neuroandriyanov/LaserRangefinder/hardware/photos/README.en.md

# Rangefinder, optics and power-supply photographs

[Русский](README.md) | **English**

Original photographs by the author. Images are preserved without re-encoding;
links open full-size files. Board labels do not replace checking connections
against the schematic and QSF.

## Board in its enclosure

Rangefinder board and receiver assembly in the open enclosure

*Custom electronics are arranged around the optical assembly.*

## Optical assembly

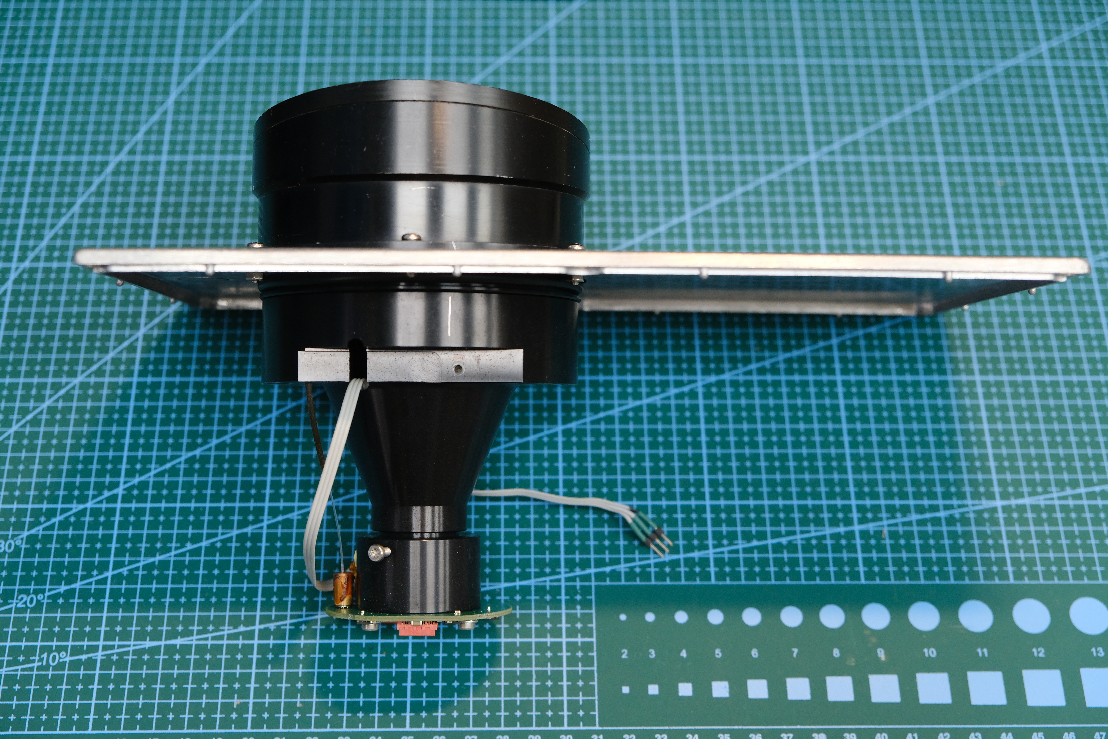
[picture p2: hardware/photos/rangefinder-03.jpg]
Optical assembly on the mounting panel, side view


*The optics used to build the bench. The restoration story is in a
[separate description](../../docs/project-story.en.md).*

## All original photographs

| Rangefinder | Power supply |
|---|---|
| [Photo 01 — board](rangefinder-01.jpg) | [Power-supply photo 01](power-supply-01.jpg) |
| [Photo 02](rangefinder-02.jpg) | [Power-supply photo 02](power-supply-02.jpg) |
| [Photo 03 — optical assembly](rangefinder-03.jpg) | |
| [Photo 04](rangefinder-04.jpg) | |
| [Photo 05 — board in enclosure](rangefinder-05.jpg) | |
| [Photo 06](rangefinder-06.jpg) | |

Oscilloscope captures are stored separately:
[latest series with distances](../../measurements/2026-11-03/Осциллограммы/README.en.md).
