neuroandriyanov/LaserRangefinder/NOTICE.en.md

# Material provenance and licences

[Русский](NOTICE.md) | **English**

Copyright (c) 2026 Sergey Vasilyevich Andriyanov (NeuroAndriyanov).

At the owner's request of 3 November 2026, original LaserRangefinder
materials are provided under the same free permissive licences used
in his FerroDSP and PropValve-RE06MT projects.

## Applicable terms

| Materials | Licence |
|---|---|
| Original application and tool code: app/, tools/ | MIT |
| Original HDL, tests, ROM tables and custom FPGA settings in fpga/ | MIT, preserving separate manufacturer notices |
| Original READMEs, instructions, reports and illustrations | MIT |
| Author's hardware/photos/ photographs, oscilloscope captures, tables and original presentation of measurements/ data | MIT, to the extent of the author's rights |
| Original main.pdf, power.pdf schematics and bom.xlsx in hardware/schematics/ | CERN-OHL-P-2.0 |

Full texts: [MIT](LICENSE) and [CERN-OHL-P-2.0](LICENSES/CERN-OHL-P-2.0.txt).
This is an allocation by material type, not a requirement to apply both
licences simultaneously to every file. Retain attribution notices and
follow the relevant licence terms when using and distributing changes.

## Manufacturer materials

Quartus, its libraries and automatically generated components retain
Altera's terms. QDF files, SOF/POF images and project-file notices
containing such components do not become wholly MIT-licensed merely
by being in this folder. Licensing the author's settings and HDL
does not grant rights to Quartus itself or proprietary manufacturer components.

Python, Tcl/Tk, Icarus Verilog, NumPy, Matplotlib, pySerial, Bumble, libusb1,
Bleak and other dependencies are installed separately under their own
licences. Third-party APKs, installers, drivers and manufacturer
documentation packages are not included here.

LE-200 PROFIBUS is named as the donor of physical optical assemblies.
This project's licences do not grant rights to the manufacturer's
original design, documentation, trademarks or third-party patents.
The bench is an independent experimental design, not an official
project of the donor's manufacturer.

## Data and history

Code and measurement scripts were developed with AI participation;
the author designed, restored and checked the hardware. Documents
distinguish his statements, simulations and real measurements.
An open licence does not confirm a 200 m range, accuracy or IP68 protection.

The root manifest describes the current publication folder. The
measurement-series manifest remains unchanged and also contains hashes
of primary captures retained in the author's working archive. The new
licence does not change numerical results or file provenance.

[Licence text sources](docs/license-sources.en.md).
