neuroandriyanov/LaserRangefinder/docs/website-links.md

# Материалы для ссылок с сайта

**Русский** | [English](website-links.en.md)

Все пути отсчитываются от корня этой папки. Машиночитаемый каталог:
[site-links.json](../site-links.json). Ссылки относительные, поэтому адрес
будущего GitHub-репозитория и домен сайта не зашиты в документы.

После выбора репозитория для просмотра используйте его обычную ссылку на
файл/каталог; для скачивания — URL исходного файла, предоставленный GitHub.
Пробелы и кириллицу кодируйте по сегментам URL (например, пробел → `%20`).
Для воспроизводимых публикаций фиксируйте commit/tag, а не изменяемую ветку.
`measurements/2026-11-03/` — постоянный адрес именно этой серии; новые серии
следует добавлять рядом, не перезаписывая исторические материалы.

| Материал | Путь |
|---|---|
| Программа | `app/README.md` |
| Проект Quartus | `fpga/DistanceSensorFpga_v0.qpf` |
| Сборка FPGA | `fpga/README.md` |
| Основная схема | `hardware/schematics/main.pdf` |
| Питание | `hardware/schematics/power.pdf` |
| Спецификация | `hardware/schematics/bom.xlsx` |
| Фото платы, оптики и питания | `hardware/photos/README.md` |
| Последняя серия | `measurements/2026-11-03/README.md` |
| Таблица измерений | `measurements/2026-11-03/Стендовые измерения.xlsx` |
| Осциллограммы | `measurements/2026-11-03/Осциллограммы/README.md` |
| UART v3 | `docs/protocol-v3.md` |
| Проверки | `docs/build-verification.md` |
| Обзор проекта | `README.md` |
| История проекта | `docs/project-story.md` |
| Стенд | `docs/stand.md` |
| Эксперименты | `docs/experiments.md` |
| Начать работу с ИИ | `docs/START_WITH_AI.md` |
| Памятка ИИ | `AGENTS.md` |
| Текущий статус | `docs/AI_HANDOFF.md` |
| Лицензии | `NOTICE.md` |

На снимках SVG есть внешняя подпись расстояния и пары каналов; рядом лежат
нативные PNG. Для сайта можно ссылаться на SVG или PNG без повторного
скриншота и изменения измерительных следов. Схемы PDF и таблицы XLSX
доступны отдельными файлами. Фото плат полноразмерные, поэтому страница
сайта может задавать уменьшенную ширину отображения и ссылку на оригинал.

Для страницы проекта можно использовать разделы основного README: история,
работа с ИИ, измерения и другие проекты. Подробные статьи имеют собственные
постоянные пути; материалы измерений остаются в каталоге своей даты.
