neuroandriyanov/LaserRangefinder/docs/AI_HANDOFF.md

# Контекст для следующего ИИ

**Русский** | [English](AI_HANDOFF.en.md)

Состояние на **3 ноября 2026 года, Samara (UTC+4)**. Этот файл относится
к самостоятельной публикационной папке. Он не требует доступа к рабочему
компьютеру автора. Порядок чтения и проверки — [AGENTS.md](../AGENTS.md).

Канонический репозиторий: [neuroandriyanov/LaserRangefinder](https://github.com/neuroandriyanov/LaserRangefinder).
Первая публикация подготовлена 03.11.2026 по поручению автора через отдельную
ветку и pull request в main. Точный коммит и факт слияния проверяйте в истории
репозитория. Программная версия и результаты измерений при переносе не менялись.

## Документация на двух языках — 7 ноября 2026

Аппаратное и программное состояние ниже остаётся состоянием 3 ноября.
Добавлены полные английские документы, подписи осциллограмм и отдельная
английская таблица измерений. Числовые исходники, прошивка и исторические
манифесты сохранены; приборы не опрашивались. Русский материал можно добавлять
первым, затем переводить по [инструкции](TRANSLATIONS.md). Проверки и причина
обновления корневого manifest.json записаны в [журнале](PROJECT_LOG.md).

## Что здесь есть

Приложение ПК 0.5.1, FPGA UART v3, схемы, фото и последняя серия измерений.
История: оптика и приёмный блок от неисправного LE-200 PROFIBUS; PIN-фотодиоды
заменены на BPX65, лазерный диод на QL67D7SA. Это сведения автора, записанные
при подготовке описания. Основная плата — собственная разработка.
Подробнее: [история](project-story.md), [стенд](stand.md).

## Актуальная реализация

| Узел | Состояние |
|---|---|
| FPGA | EP4CE6E22C8, проект DistanceSensorFpga_v0 в fpga/ |
| DDS | AD9959, SYSCLK 500 МГц, единый IO_UPDATE, 4 канала |
| АЦП | 8 ADS8681, синхронные 250 квыб/с |
| Аналоговая фаза | МНК/CORDIC, окно 1000 отсчётов, обновление через 250; FIR отсутствует |
| Цифровая фаза | 125 МГц, 16 фронтов каждой полярности |
| Достоверность | Помимо фаз, проверяется модуль U ≥0,5 В на каждом ADC5–8 |
| UART | v3, 115200 8N1, запрос 12 байт, измерения 112, банк DDS 48 |
| Расстояние | Вычисляет ПК по cal2; в FPGA расчёта расстояния и скорости нет |
| Рулетка | Vector60 через отдельный WinUSB Bluetooth-адаптер; не обязательна для FPGA/демо |

Стартовый банк: FTW `[12845056, 635888254, 12879416, 635830272]`,
ASF `[200, 1000, 1000, 450]`, POW все 0. Точная копия —
[default.json](../app/profiles/dds/default.json). ПЧ НЧ 4000,030458 Гц,
ВЧ 6749,993190 Гц. НЧ DDS CH0/CH2, ВЧ CH1/CH3; фазовые пары входов
3−1 ВЧ и 4−2 НЧ. Настройки через COM действуют до reset; на ПК сохраняются отдельно.

## Что проверено

Последняя серия: 762, 1091, 1480, 1958, 2398, 2876, 3425, 4198, 4814, 5635 мм.
На точку два снимка, CH1+CH3 и CH2+CH4. Cal2 зафиксирована до серии,
область 638–5583 мм, ID `6c959d57db56d0397e0618d8026c43604e38874606a59c39262eb9daf9059de6`.
Внутри неё девять точек: RMS расхождения с рулеткой 13,36/13,16 мм,
max |ошибки| 22,96/22,81 мм (аналоговый/цифровой). 5635 мм вне модели.
[Отчёт и данные](../measurements/2026-11-03/README.md).

POF рабочей серии: `7e652373ae74ca5d1734248706c16cae9fdaf9ef25b28a321869271220e0212d`.
Program+Verify на авторской плате — 03.11.2026 20:31:09 Samara.
Контрольная сборка публикационной копии дала такой же POF, без повторной записи.
Quartus Lite 25.1std: 6162/6272 LE, 23/30 M9K, 5/15 DSP18, 1/2 PLL;
66 проверок, min slack +0,137 нс, unconstrained 0.
63 теста приложения, 22 протокола и 9 HDL-наборов прошли;
чистая установка и деморежим после переноса проверены на Windows/Python 3.14.
[Доказательства](build-verification.md). Это проверки сохранённой версии.

## Незакрытые вопросы

- В точке 5635 мм появился `diagnostics=4`: запоминаемое цифровое переполнение.
  Источник — digital_phase_meter.overflow_seen и/или bridge.overrun; какой именно
  и почему, пока не установлено. После восстановления текущий valid может быть 1.
- Причина редких аппаратных скачков фазы не доказана. Проверка DDS не обнаружила
  периодических обновлений при неизменном задании. FIR был убран после отсутствия
  заметного улучшения по наблюдениям автора.
- Подбор DDS проводился в одной точке 1642 мм. Профиль не универсальная калибровка.
- Нужны исследования динамики и температуры, длинная дистанция 100–200 м,
  дальнейший расчёт расстояния/скорости. Комнатные опыты их не заменяют.
- IP68 — цель выбора корпуса; протокола испытаний собранного изделия нет.

Последнее подтверждённое состояние авторского стенда после серии: прежний
DDS-банк, generation=0, diagnostics=4, COM/BLE освобождены, осциллограф RUN,
все четыре канала, 50 мкс/дел. При подготовке этой документации приборы не
опрашивались. Для другого стенда или нового дня состояние нужно узнать заново.

## С чего продолжать

Для изучения достаточно [инструкции](START_WITH_AI.md), демонстрации и сохранённых
данных. Для разработки выберите задачу пользователя, затем соответствующие тесты.
Для bit2 сначала нужен воспроизводимый сценарий и локализация источника;
не сбрасывайте и не скрывайте флаг ради красивой статистики. Для нового стенда
сначала подтвердите подключения, реальный банк и пригодность своей калибровки.

Новые сведения записывайте сюда, завершённые этапы — в [PROJECT_LOG.md](PROJECT_LOG.md).
Исходные данные и старые манифесты сохраняйте. Лицензии уже выбраны по поручению
автора: MIT и CERN-OHL-P-2.0, область — [NOTICE.md](../NOTICE.md).
