neuroandriyanov/LaserRangefinder/docs/known-limitations.md

# Подтверждённые ограничения

**Русский** | [English](known-limitations.en.md)

- Корпус выбирался с расчётом на IP68; протокола испытаний степени защиты
  собранного устройства в комплекте нет.

- Реально измерена комнатная дистанция до 5635 мм. Cal2 охватывает 638–5583 мм;
  перенос результата на 100–200 м пока не проверен.
- Расстояние на главной вкладке считает ПК. FPGA передаёт фазы, амплитуды,
  сырые коды, частоты и статусы; аппаратного расчёта расстояния/скорости нет.
- Последняя точка стенда содержит `diagnostics=4`: запоминаемый bit2
  переполнения цифрового захвата/CDC. Причина не установлена. Текущие valid
  могут восстановиться, пока этот диагностический бит остаётся до reset.
- Для точки вне модели Excel выводит «н/д». Потери и помехи не заменяются
  интерполяцией, выдаваемой за измерение.
- Независимость фазового алгоритма от масштаба амплитуды проверена
  моделированием. При малом сигнале, искажениях, насыщении и взаимопроникновении
  каналов реальная погрешность всё равно возможна.
- Передача полного запроса и ответа при 115200 8N1 занимает минимум 10,764 мс;
  1000 и даже устойчивые 100 полных ответов/с на этой скорости недостижимы.
- Приложение и WinUSB backend проверены на Windows. Изменяемый VID:PID
  не означает подтверждённую совместимость со всеми Bluetooth-адаптерами.
- Профиль DDS подобран на конкретной плате при 1642 мм. Его сохранение не
  заменяет настройку и калибровку другого экземпляра.
- FPGA использует 98% логических элементов; запас для новых функций мал.
- Эта публикационная сборка не проходила повторную запись в плату.
  Стендовая серия относится к отдельно сохранённому проверенному POF.
