neuroandriyanov/LaserRangefinder/docs/protocol-v2-fields.md

# Наследуемые поля UART v2

**Русский** | [English](protocol-v2-fields.en.md)

Справочная таблица старого формата для сравнения с v3. **Текущая прошивка — v3**,
описана в [основном документе](protocol-v3.md). Для v3 наследуются байты 4–87;
байты 88–111, длина, версия, периоды, возраст и CRC определяются только v3.
FIR в текущей прошивке отсутствует. Порог ADC5–8 и перестройка DDS описаны в v3.

## Измерения: 96 байт

| Смещение | Размер | Поле |
|---|---:|---|
| 0…3 | 4 | `A5 5A 02 60` |
| 4 | 1 | `82` |
| 5 | 1 | 0 — запрос обработан; **это не признак достоверности измерений** |
| 6 | 1 | Аналоговые флаги, см. ниже |
| 7 | 1 | Цифровые флаги: bit0 ВЧ valid, bit1 НЧ valid |
| 8 | 2 | Номер запроса |
| 10 | 1 | `adc_ok`: bit0…7 для АЦП1…8 |
| 11 | 1 | `channel_valid`: bit0…3 для аналоговых каналов 1…4 |
| 12 | 4 | Счётчик аналоговых результатов, шаг 1 мс, unsigned32 |
| 16 | 4 | Счётчик выборок АЦП, unsigned32, 250000/с |
| 20, 24 | 4+4 | Аналоговые фазы ВЧ и НЧ, signed32 |
| 28, 32 | 4+4 | Цифровые фазы ВЧ и НЧ, signed32, среднее двух полярностей |
| 36, 40 | 4+4 | Цифровая ВЧ: отдельно нарастающие / спадающие фронты |
| 44, 48 | 4+4 | Цифровая НЧ: отдельно нарастающие / спадающие фронты |
| 52, 56, 60, 64 | 4×4 | Модули I/Q каналов 1…4 после CORDIC, unsigned32 |
| 68, 70, 72, 74 | 4×2 | Последние сырые коды АЦП1…4 (синусоиды), unsigned16 |
| **76, 78, 80, 82** | **4×2** | **АЦП5…8: выходы четырёх детекторов амплитуды**, unsigned16 |
| 84 | 2 | Счётчик цифровых результатов, unsigned16 |
| 86 | 2 | Порог аналоговой амплитуды, 100 отсчётов пика |
| 88, 90 | 2+2 | Последние периоды опорных ВЧ/НЧ меандров в тактах 125 МГц |
| 92 | 1 | Возраст цифрового результата, приблизительно мс, насыщение 255 |
| 93 | 1 | Диагностика: bit0 ошибка RX, bit1 очередь запросов переполнена, bit2 цифровой буфер/CDC переполнен |
| 94 | 2 | CRC16 байтов 2…93 |

Аналоговые флаги byte6: bit0 ВЧ valid; bit1 НЧ valid; bit2 `beam_lost` после
100 мс непрерывной непригодности; bit3 ошибка инициализации хотя бы одного
АЦП; bit4 плохая выборка/ограничение в окне; bit5 окно не заполнено;
bit6 ошибка RX; bit7 переполнение аналоговой обработки.
Диагностические биты ошибок RX/очереди/цифрового переполнения сохраняются
до reset, но сами не запрещают восстановление хороших последующих измерений.

Фазы: `градусы = signed32 × 360 / 2^32`, интервал [-180,180).
Цифровое значение внутри FPGA имеет 24 бита, в пакете дополняется восемью
нулевыми младшими битами. Направление всех разностей — канал 3 минус 1
(ВЧ), канал 4 минус 2 (НЧ). Переход ±180° штатный, развёртки дальности нет.

Синусоидальная амплитуда пика в отсчётах АЦП:
`2 × magnitude / (1000 × 1.646760258121)`; далее ×0.000375 В.
Для сырых кодов АЦП: `(raw - 32768) × 0.000375 В`.
АЦП5…8 передают напряжения выходов детекторов на входах АЦП, а не калиброванную
мощность света/ВЧ. Пакет содержит одну последнюю одновременную выборку всех
восьми АЦП у конца аналогового окна; это отдельные данные от I/Q-амплитуд,
усреднённых за 4 мс. Передаточный коэффициент детектора сюда не введён.
