neuroandriyanov/LaserRangefinder/docs/stand.md

# Из чего состоит стенд

**Русский** | [English](stand.en.md)

Стенд нужен для сопоставления трёх вещей: реального перемещения мишени,
формы сигналов и результата вычислений FPGA. Это настольная установка
с ручным перемещением, а не автоматическая измерительная линия.

## Аппаратура

| Узел | Назначение |
|---|---|
| Восстановленная оптика LE-200 PROFIBUS | Линза, коллиматор, оптический путь и приёмный узел |
| BPX65, два PIN-фотодиода | Прямой опорный свет по оптоволокну и отражённый свет от мишени |
| QL67D7SA | Заменённый лазерный диод, красный диапазон около 670 нм по описанию автора |
| Четыре SA612 | Перенос двух частот каждого фотоприёмного канала на ПЧ |
| Собственная плата с AD9959 и Cyclone IV | Формирование сигналов, управление и вычисление фаз |
| Восемь ADS8681 | Четыре синусоиды ПЧ и четыре выхода детекторов амплитуды |
| Компараторы | Цифровые сигналы для второго способа измерения фаз |
| RIGOL DS1104Z | Наблюдение четырёх сигналов, запись экранов и контроль формы |
| Vector60 с Bluetooth | Контроль расстояния до той же мишени |
| USB–TTL | UART между FPGA и ПК, 115200 8N1, уровни 3,3 В |
| USB-Blaster | Загрузка и проверка образа FPGA / EPCS4 |
| ПК и выделенный Bluetooth USB-адаптер | Программа, журналы, расчёты и обмен с рулеткой |
| Мишень на штативе | Ручное изменение расстояния с остановками |

Фотографии [платы, оптики и питания](../hardware/photos/README.md),
[схемы и спецификация](../hardware/README.md). Внешний тракт SA612 не полностью
представлен основной схемой. Оптическая история и марки заменённых элементов
сообщены автором; они не выведены из PDF основной платы.

## Подключение каналов

В последней аналоговой серии использовалось следующее соответствие:

| Осциллограф | Разъём | Сигнал | С чем сравниваем |
|---|---|---|---|
| CH1 | X9 | Опорный ВЧ | CH3−CH1 |
| CH2 | X10 | Опорный НЧ | CH4−CH2 |
| CH3 | X11 | Отражённый ВЧ | CH3−CH1 |
| CH4 | X12 | Отражённый НЧ | CH4−CH2 |

Для наблюдения цифрового тракта ранее использовались X17–X20 в соответствующем
порядке. Перестановку щупов необходимо отмечать в новом сеансе: одни и те же
подписи CH1–CH4 сами по себе не говорят, аналоговый это сигнал или цифровой.

Текущие DDS CH0/CH2 образуют НЧ-пару, CH1/CH3 — ВЧ-пару. Их нельзя путать
с номерами входов осциллографа или АЦП. Точные FTW и амплитуды находятся
в [профиле](../app/profiles/dds/default.json). ПЧ НЧ — 4000,030458 Гц,
ПЧ ВЧ — 6749,993190 Гц; генератор AD9959 номинально 500 МГц.

## Как снималась последняя серия

1. Автор устанавливал мишень и подтверждал, что она неподвижна.
2. После выдержки записывались ответы рулетки и FPGA. В последней серии
   использовались выдержка 3 с, запись не менее 15 с и не менее шести ответов
   рулетки. Критерии отбора приведены в [отчёте](../measurements/2026-11-03/README.md).
3. Сохранялись два экрана осциллографа: CH1+CH3 и CH2+CH4. Затем ещё раз
   проверялось расстояние рулеткой.
4. Только после завершения точки подавалась команда передвинуть мишень.
   Ответ «двигать некуда» завершал серию.

Это отдельная проверочная серия. Автоматическая калибровка в приложении имеет
другой критерий: **три одинаковых ответа рулетки** и пригодные свежие фазы.
Она подаёт звуковой сигнал о добавлении точки. Эти три ответа не означают
ни три синхронные выборки всех приборов, ни критерий последней длинной записи.

Рулетка и осциллограф имеют собственные часы и задержки. Их сопоставляли
на остановках мишени. FPGA синхронизирует свои АЦП; это не синхронизирует
внешние приборы с FPGA. Для движения нужна отдельная проверка времени измерения.

## Что сохраняется

Для серии полезны версия/хеш прошивки, прочитанный DDS-банк, подключение щупов,
настройки осциллографа, временные метки запросов и ответов, исходные пакеты UART,
отсчёты рулетки и ошибки. Компактный результат содержит средние, разброс,
флаги достоверности, формулы и подписанные снимки; он не заменяет сырую запись.

В этом комплекте лежат клиенты FPGA и Vector60, приложение и сохранённые
осциллограммы. Авторские сценарии автоматического захвата RIGOL и полные сырые
сеансы не включены. Для повторения на другом стенде нужен подходящий SCPI/VISA
клиент или сохранение экранов средствами самого осциллографа.

Программа и скрипты не перемещают мишень. Решение о движении реального механизма
при потере достоверности принимает внешний управляющий контроллер.

## Следующий масштаб испытаний

Пока использовано небольшое помещение. Для проверки 100–200 м понадобится
длинный участок, новые контрольные расстояния и проверка повторяемости,
дрейфа и работы при движении. Конструкция корпуса рассчитана на последующие
опыты на оборудовании; результаты испытаний IP68 пока не представлены.
