neuroandriyanov/LaserRangefinder/docs/START_WITH_AI.md

# Как начать работу с проектом вместе с ИИ

**Русский** | [English](START_WITH_AI.en.md)

Начать можно без платы и измерительных приборов. В папке уже есть фотографии,
схемы, исходники, тесты и записанные измерения. Агент с доступом к локальным
файлам сможет восстановить контекст и помочь с выбранной задачей.

## 1. Откройте весь проект

Скачайте или скопируйте комплект целиком и откройте его корневую папку в среде,
где работает ваш ИИ-агент. В корне должны быть `AGENTS.md`, `README.md` и папки
`app`, `fpga`, `hardware`, `measurements`, `docs`. Пути в инструкциях отсчитываются
отсюда. Передавать агенту только один Verilog-файл недостаточно для понимания
подключений, тактов, протокола и ограничений.

Не все агенты автоматически читают AGENTS.md, поэтому в первом сообщении
лучше назвать его явно. Если у вашего помощника нет доступа к папкам,
предоставьте ему эти документы и нужные исходники доступным в вашей среде способом.

## 2. Дайте первое задание

Можно скопировать этот текст:

```text
Работаем с LaserRangefinder. Сначала прочитай AGENTS.md, README.md,
docs/AI_HANDOFF.md и docs/START_WITH_AI.md. Затем изучи карту файлов
и документы по моей задаче.

Кратко объясни, как устроен тракт, что уже реализовано и проверено,
какие ограничения остаются и где лежат исходные данные.
Отделяй реальные измерения от моделирования и гипотез.
Пока только изучение: файлы и настройки приборов не меняй.
```

Это удобный первый шаг, а не обязательная церемония перед каждой задачей.
Когда агент освоился, дайте конкретное поручение и нужный объём самостоятельности.

## 3. Выберите небольшую задачу

| Интерес | Пример поручения |
|---|---|
| Программа ПК | «Запусти деморежим по app/README.md, изучи чтение UART v3 и покажи, где отображается достоверность» |
| Математика | «По последней серии построй зависимость фаз от расстояния. Коэффициенты cal2 не переобучай; сравни с сохранённым результатом» |
| FPGA | «Разбери путь ADC → phase_demod → phase_lsq → CORDIC и тест переменных ПЧ. Объясни, почему масштаб амплитуды не должен менять идеальную фазу» |
| Диагностика | «Изучи digital_phase_meter и digital_phase_bridge. Предложи тест для источника bit2; не объявляй причину доказанной до проверки» |
| Документация | «Проверь, хватает ли схем, таблицы подключений и инструкций для запуска на другом ПК» |

Команды установки, запуска и тестов находятся в [app/README.md](../app/README.md)
и [fpga/README.md](../fpga/README.md). Контроль исходного комплекта без приборов:

```powershell
python tools/verify_bundle.py
```

Команда запускается из корня и сверяет хеши с manifest.json. После намеренной
правки файл закономерно перестанет совпадать: это повод сохранить новую версию
манифеста с записью в журнале, а не скрывать изменение.

## 4. Если есть собственный стенд

Сначала покажите агенту [описание стенда](stand.md), вашу схему подключения,
модель FPGA, реальный COM-порт, приборы и задачу эксперимента. Адреса авторского
стенда не нужны: программа рассчитана на выбор своих устройств.

Перед перестройкой DDS сохраните прочитанный банк и проверьте соответствие
калибровки. Смена частоты меняет вклад аналогового тракта; прежние коэффициенты
нельзя автоматически считать подходящими. В комплекте есть клиенты FPGA и
Vector60. Управление другой рулеткой или осциллографом потребует своего
совместимого интерфейса; готового универсального драйвера здесь нет.

Пример согласованной серии:

```text
Запиши исходную точку на неподвижной мишени. После завершения записи
предлагай два ответа: «Передвинул, мишень неподвижна» и
«Двигать некуда, заканчиваем». Новую точку снимай после подтверждения.
Сохраняй расстояние рулетки, данные FPGA, два снимка осциллографа,
настройки и ошибки. При завершении подготовь таблицу и краткий отчёт.
```

Точное подключение и критерии приёма записи оговариваются до серии.
Рулетка, осциллограф и FPGA имеют разные задержки: совпадение времени получения
данных на ПК само по себе не делает измерения синхронными.

## 5. Оставьте контекст следующему агенту

В конце полезно поручить:

```text
Обнови docs/AI_HANDOFF.md и добавь запись в docs/PROJECT_LOG.md.
Укажи, что изменено, чем проверено, где лежат результаты и что делать дальше.
Если использовались приборы, запиши настройки и оставленное состояние.
Исходные измерения и неудачные попытки сохрани без подмены.
```

Так проект можно продолжать в новом чате и с другим помощником. Важнее сохранить
понятные данные и решения, чем всю переписку: следующий участник должен видеть,
что известно, на чём это основано и что пока остаётся вопросом.
