neuroandriyanov/LaserRangefinder/hardware/photos/power-supply-01.jpg

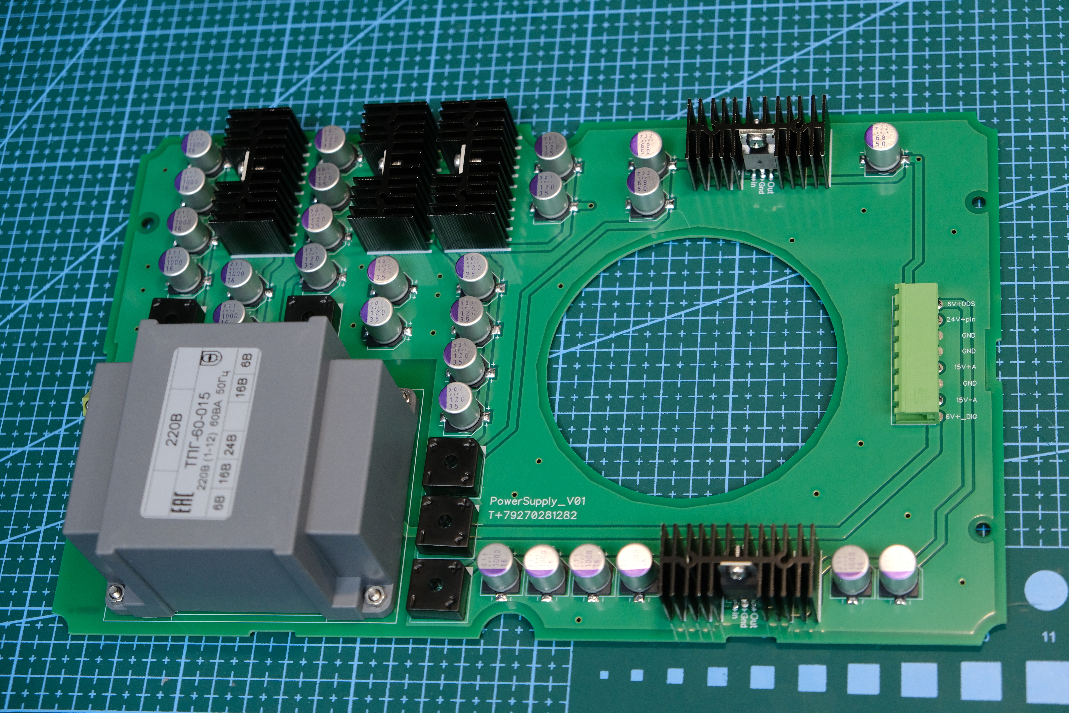
hardware/photos/power-supply-01.jpg
