neuroandriyanov/LaserRangefinder/hardware/photos/power-supply-02.jpg

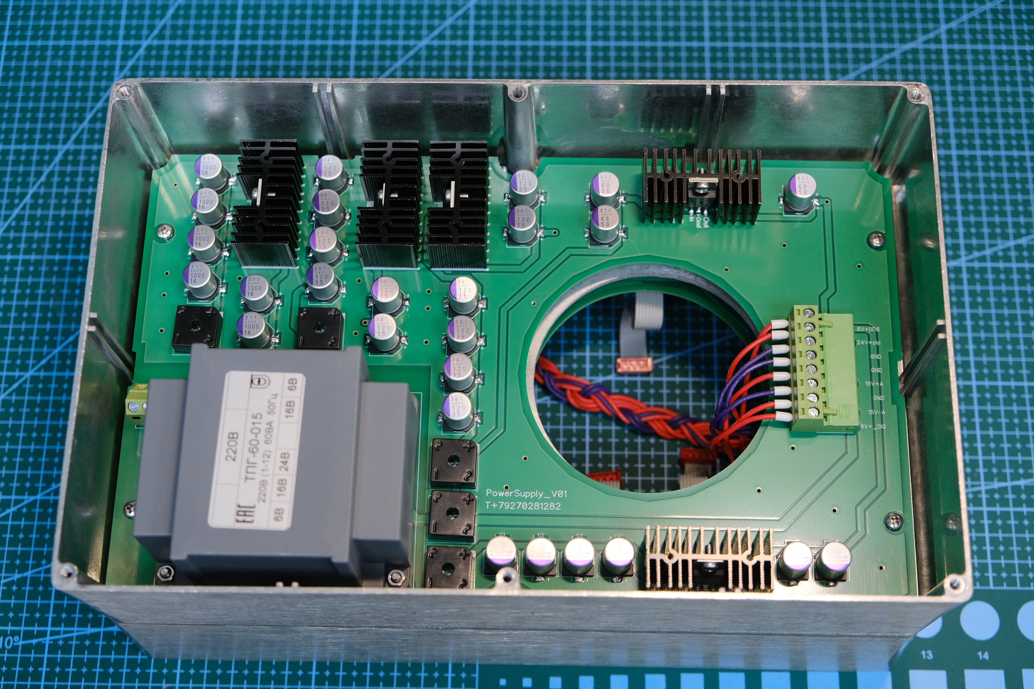
hardware/photos/power-supply-02.jpg
