neuroandriyanov/LaserRangefinder/hardware/photos/rangefinder-01.jpg

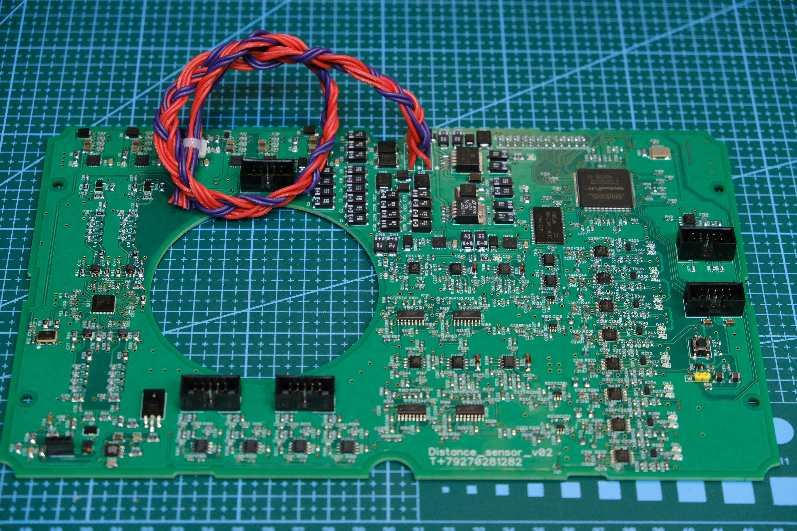
hardware/photos/rangefinder-01.jpg
