neuroandriyanov/LaserRangefinder/hardware/photos/rangefinder-02.jpg

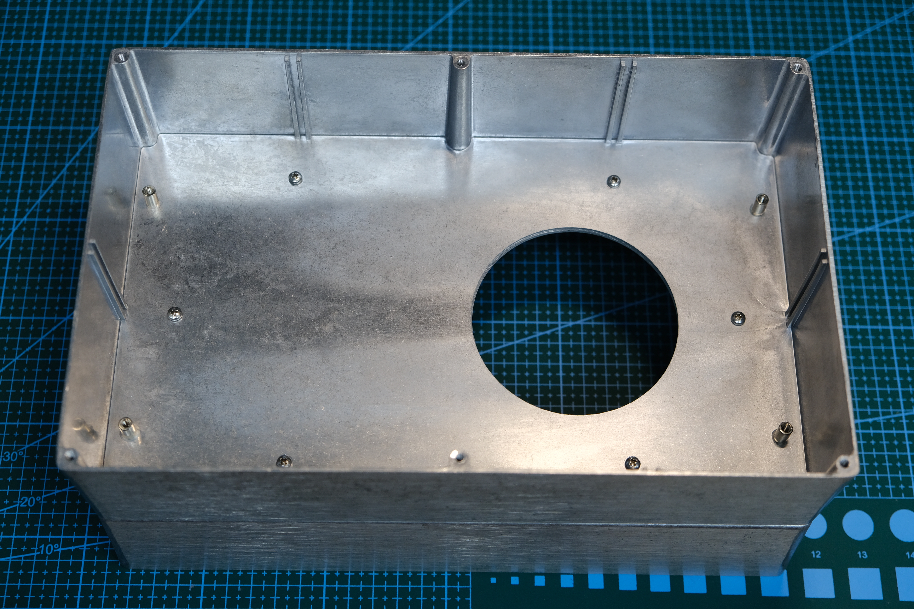
hardware/photos/rangefinder-02.jpg
