neuroandriyanov/LaserRangefinder/hardware/photos/rangefinder-04.jpg

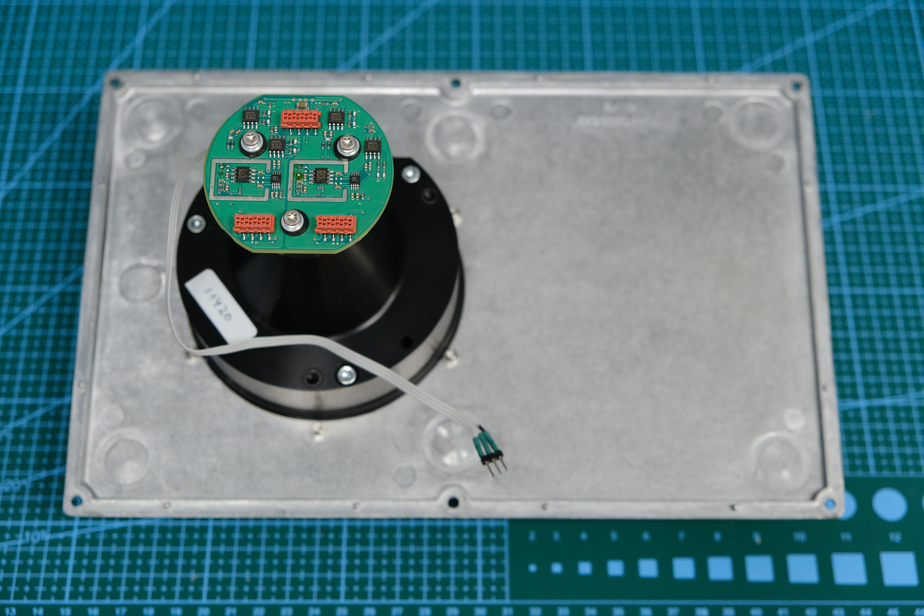
hardware/photos/rangefinder-04.jpg
