neuroandriyanov/LaserRangefinder/hardware/photos/rangefinder-06.jpg

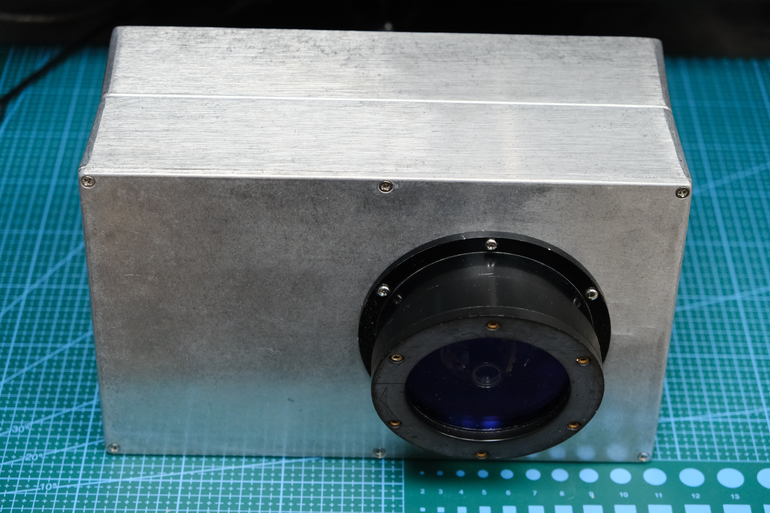
hardware/photos/rangefinder-06.jpg
