neuroandriyanov/LaserRangefinder/hardware/schematics/bom.xlsx

N | RefDes | Value | Name | Pcs | Price | SumPrice
1 | DA7 | AD9959BCPZ | AD9959BCPZ | 1
2 | DA31,DA32,DA33,DA34,DA35,DA36,DA37,DA38 | ADS8681 | ADS8681 | 8
3 | DA11 | TPS7A3301RGWR | TPS7A3301RGWR | 1
4 | DA1,DA2,DA3,DA4,DA5,DA6,DA10 | TPS7A4701RGWR | TPS7A4701RGWR | 7
5 | DA17,DA20,DA24,DA27 | OPA189 | OPA189 | 4
6 | DA8 | OPA343UA | OPA343UA | 1
7 | DD5,DD6,DD7,DD8 | MAX998EUT | MAX998EUT | 4
8 | DA19,DA22,DA23,DA26,DA29,DA30 | AD8034 | AD8034 | 6
9 | D4,D7,D8,D9,D12,D13,D24,D27,D30,D32,D37,D38,D39,D40,D41,D42,D43,D44,D45,D46,D47,D48,D49,D50,D51,D52 | APHCM2012CGCK | APHCM2012CGCK | 32
10 | DD3 | EP4CE6E22 | EP4CE6E22 | 1
11 | DD4 | K6R4008V1D-UI10 | K6R4008V1D-UI10 | 1
12 | DA18,DA21,DA25,DA28 | LM13700M | LM13700M | 4
13 | DD1,DD9,DD10,DD11,DD12,DD13,DD14,DD15,DD16 | SN74LVC2G14DBVR | SN74LVC2G14DBVR | 9
14 | DD2 | RS806-2.93YF5 | RS806-2.93YF5 | 1
15 | DA9 | EPCS4SI8 | EPCS4SI8 | 1
16 | D15,D16,D17,D18 | BAT60JFILM | BAT60JFILM | 4
17 | DA12,DA13 | M78L05CD | M78L05CD | 2
18 | DA14 | LM1117_3V | LM1117_3V | 1
19 | R49,R60,R62,R65,R67,R69,R71,R73,R76,R78,,R79,R81,R83,R92,R93,R108,R111,R114,R129,R134,R135,R141,R142,R143,R144,R151,R152,R158,R159,R160,R161,R162,R163,R178,R181,R184,R199,R204,R205,R211,R212,R213,R214,R221,R222,R228,R229,R230,R231 | 22 | 603 | 49
20 | R146,R148,R155,R156,R216,R218,R225,R226 | 100 | 603 | 8
21 | R99,R103,R117,R125,R169,R173,R187,R195 | 470 | 603 | 8
22 | R232,R233,R235,R239,R240,R241,R242,R243,R272,R273,R274,R277,R280,R281,R282,R283 | 560 | 603 | 16
N | RefDes | Value | Name | Pcs | Price | SumPrice
23 | R234,R236,R237,R238,R244,R245,R246,R247,R275,R276,R278,R279,R284,R285,R286,R287 | 0.3 | 603 | 16
24 | R100,R104,R118,R126,R170,R174,R188,R196 | 1,5K | 603 | 8
25 | R88 | 1.5M | 603 | 1
26 | R8,R13,R17 | 1,91K | 603 | 3
27 | R12,R21,R50,R51,R52,R53,R54,R55,R56,R58,R59,R105,R106,R109,R110,R112,R113,R122,R127,R130,R131,R132,R133,R136,R137,R138,R139,R140,R145,R147,,R149,R150,R153,R154,R157,R175,,R176,R179,R180,R182,R183,R192,R197,R200,R201,R202,R203,R206,R207,R208,R209,R210,R215,R217,R219,R220,R223,R224,R227,R248,R249,R250,R251,R252,R253,R254,R255,R256,R257,R258,R259,R260,R261,R262,R263,R264,R265,R266,R267,R268,R269,R270,R271,R288,R289,R290,R291,R292,R293,R294,,R295,R296,R297,R298,R299,R300,R301,R302,R303,R304,R305,R306,R307,R308,R309,R310,R311 | 10K | 603 | 106
28 | R101,R116,R171,R186 | 20K | 603 | 4
29 | R95,R97,R102,R107,R119,R120,R123,R128,R165,R167,R172,R177,R189,R190,R193,R198 | 22K | 603 | 16
30 | R96,R98,R121,R124,R166,R168,R191,R194 | 3,3K | 603 | 8
31 | R61,R63,R64,R66,R68,R70,R72,R74,R75,R77,R80,R82,R84 | 4,3K | 603 | 13
32 | R94,R115,R164,R185 | 15K | 603 | 4
33 | R89 | 162k | 603 | 1
34 | R57 | 1k | 603 | 1
35 | C139 | 0,01uF 16V | 603 | 1
36 | C215,C216,C220,C221,C269,C270,C274,C275 | 0,022uF 16V | 603 | 8
37 | C180,C188,C193,C200,C234,C242,C247,C254 | 0,02uF 16V | 603 | 8
38 | C184,C186,C195,C202,C208,C219,C238,C240,C249,C256,C262,C273 | 0,05uF 16V | 603 | 12
N | RefDes | Value | Name | Pcs | Price | SumPrice
39 | C55,C56,C57,C58,C59,C60,C61,C62,C63,C64,C65,C67,C68,C69,C71,C76,C77,C78,C79,C84,C88,C89,C90,C95,C96,C97,C98,C99,C100,C101,C106,C107,C112,C113,C114,C115,C120,C121,C124,C125,C126,C143,C144,C154,C155,C156,C157,C158,C159,,C160,C161,C162,C163,C164,C165,C166,C167,C168,C169,C170,C171,C172,C173,C174,C175,C176,C177,C178,C179,C181,C183,C185,C187,C190,C192,C196,C197,C198,C199,C204,C205,C206,C207,C209,C210,C212,C213,C223,C224,C228,C229,C230,C231,C232,C233,C235,C237,C239,,C241,C244,C246,C250,C251,C252,,C253,C258,C259,C260,C261,C263,C264,C266,C267,C277,C278,C282,C283,C284,C285 | 0,1uF 16V | 603 | 119
40 | C191,C203,C214,C225,C245,C257,C268,C279 | 100pF 16V | 603 | 8
41 | C83,C94,C105,C111,C116,C117,C118,C119 | 10pF 16V | 603 | 8
42 | C20,C21,C22,C23,C27,C28,C29,C30,C34,C35,C36,C37,C41,C42,C43,C44,C48,C49,C50,C51,C72,C85,C86,C87,C142,C145,C292,C295,C304,C307,C316,C319,C328,C331 | 10uF 16V | 603 | 34
43 | C211,C222,C265,C276,C286,C287,C288,C289,C294,C297,C298,C299,C300,C301,C306,C309,C310,C311,C312,C313,C318,C321,C322,C323,C324,C325,C330,C333 | 1uF 16V | 603 | 28
44 | C80,C91,C102,C108,C217,C226,C271,C280 | 20pF 16V | 603 | 8
45 | C293,C296,C305,C308,C317,C320,C329,C332 | 22uF 16V | 603 | 8
46 | C218,C227,C272,C281, | 23pF 16V | 603 | 4
47 | C290,C291,C302,C303,C314,,C315,C326,C327 | 300pF 16V | 603 | 8
48 | C182,C194,C236,C248, | 30pF 16V | 603 | 4
49 | C82,C93,,C104,C110 | 33pF 16V | 603 | 4
50 | C81,C92,C103,C109 | 39pF 16V | 603 | 4
51 | C74 | 680pF 16V | 603 | 1
52 | C189,C201,C243,C255 | 70pF 16V | 603 | 4
N | RefDes | Value | Name | Pcs | Price | SumPrice
53 | L4,L8,L12,L16 | 100nH | 603 | 4
54 | L2,L6,L10,L14 | 22nH | 603 | 4
55 | L5,L9,L13,L17 | 56nH | 603 | 4
56 | L3,L7,L11,L15 | 82nH | 603 | 4
57 | R26,R33,R39,R45 | 1 | 1206 | 4
58 | R14,R22 | 10 | 1206 | 2
59 | R7 | 20 | 1206 | 1
60 | R30,R32,R35 | 30 | 1206 | 3
61 | R15,R16 | 50 | 1206 | 2
62 | R24,R25,R27,R28,R29,R31,R34,R36,R37,R38,R40,R41,R42,R43,R44,,R46,R47,R48 | 180 | 1206 | 18
63 | R3,R4,R5,R6,R90,R91 | 560 | 1206 | 6
64 | R18,R19,R85 | 10K | 1206 | 3
65 | R2 | 1K | 1206 | 1
66 | R10,R11 | 2,2K | 1206 | 2
67 | R23 | 2K | 1206 | 1
68 | R20,R86,R87 | 3K | 1206 | 3
69 | R1 | 4,3K | 1206 | 1
70 | R9 | 8,2K | 1206 | 1
71 | C66,C73,C75 | 0,1uF 16V | 1206 | 3
72 | C14,C19,C26,C33,C40,C47,C131,C138 | 0,47uF 25V | 1206 | 8
73 | C15,C16,C17,C18 | 10uF 50V | 1210 | 4
74 | L1 | 10uH | 1812 | 1
75 | C24,C25,C31,C32,C38,C39,C45,C46,C52,C53,C54,C70,C122,C123 | 47uF 10V | 1206 | 14
76 | C11,C12,C13,C127,C128,C129,C130,C132,C133,C134,C135 | 68uF 25V | 7343 | 11
77 | C1,C2,C3,C4,C5,C6,C7,C8,C9C10,C136,C137,,C140,C141,C146,C147,C148,C149,C150,C151,C152,C153 | 100uF 16V | 7343 | 23
78 | VT1 | 2SD882 | 2SD882 | 1
N | RefDes | Value | Name | Pcs | Price | SumPrice
79 | OSC1 | ASG-P-X-A-500.000M | ASG-P-X-A-500.000M | 1
80 | CLCK1 | WTL7K85435FO | WTL7K85435FO | 1
81 | DA16 | TPS7A4525KTTR | TPS7A4525KTTR | 1
82 | DA15 | TPS7A4533KTTR | TPS7A4533KTTR | 1
83 | D33,D34,D35,D36 | BAT85 | BAT85 | 4
84 | L18,l19 | CBC3225T220MR | CBC3225T220MR | 2
85 | Sa1 | IT1109 | IT1109 | 1
86 | Q1,Q2,Q3 | RQA0004LXAQS | RQA0004LXAQS | 3
87 | D1,D3,D19,D20,D25,D28 | STPS5L60S | STPS5L60S | 6
88 | T1,T2,T3,T4 | TC1-1T+ | TC1-1T+ | 4
89 | X2,X3,X5,X6,X7 | IDC10 | IDC10 | 5
90 | D23,D26 | SMBJ12.0 | SMBJ12.0 | 2
91 | D21,D22 | SMBJ15.0 | SMBJ15.0 | 2
92 | D6 | SMBJ5.0 | SMBJ5.0 | 1
93 | D2,D31 | SMBJ6.0 | SMBJ6.0 | 2
94 | D10,D11,D29 | SMBJ3V3 | SMBJ3V3 | 3
95 | D5 | SMBJ24.0 | SMBJ24.0 | 1
