neuroandriyanov/LaserRangefinder/docs/verification/quartus-build.txt

TBBmalloc: skip allocation functions replacement in ucrtbase.dll: unknown prologue for function _msize
Info: *******************************************************************
Info: Running Quartus Prime Shell
    Info: Version 25.1std.0 Build 1129 10/21/2025 SC Lite Edition
    Info: Copyright (C) 2025  Altera Corporation. All rights reserved.
    Info: Your use of Altera Corporation's design tools, logic functions 
    Info: and other software and tools, and any partner logic 
    Info: functions, and any output files from any of the foregoing 
    Info: (including device programming or simulation files), and any 
    Info: associated documentation or information are expressly subject 
    Info: to the terms and conditions of the Altera Program License 
    Info: Subscription Agreement, the Altera Quartus Prime License Agreement,
    Info: the Altera IP License Agreement, or other applicable license
    Info: agreement, including, without limitation, that your use is for
    Info: the sole purpose of programming logic devices manufactured by
    Info: Altera and sold by Altera or its authorized distributors.  Please
    Info: refer to the Altera Software License Subscription Agreements 
    Info: on the Quartus Prime software download page.
    Info: Processing started: Tue Nov  3 22:02:20 2026
Info: Command: quartus_sh --flow compile DistanceSensorFpga_v0
Info: Quartus(args): compile DistanceSensorFpga_v0
Info: Project Name = <workspace>/LaseRangefinder_github/fpga/DistanceSensorFpga_v0
Info: Revision Name = DistanceSensorFpga_v0
Info: *******************************************************************
Info: Running Quartus Prime Analysis & Synthesis
    Info: Version 25.1std.0 Build 1129 10/21/2025 SC Lite Edition
    Info: Processing started: Tue Nov  3 22:02:21 2026
Info: Command: quartus_map --read_settings_files=on --write_settings_files=off DistanceSensorFpga_v0 -c DistanceSensorFpga_v0
Info (20032): Parallel compilation is enabled and will use up to 4 processors
Info (12021): Found 1 design units, including 1 entities, in source file distancesensorfpga_v0.sv
    Info (12023): Found entity 1: DistanceSensorFpga_v0 File: <workspace>/LaseRangefinder_github/fpga/DistanceSensorFpga_v0.sv Line: 2
Info (12021): Found 1 design units, including 1 entities, in source file dds_programmer.sv
    Info (12023): Found entity 1: dds_programmer File: <workspace>/LaseRangefinder_github/fpga/dds_programmer.sv Line: 3
Info (12021): Found 1 design units, including 1 entities, in source file dds_settings.sv
    Info (12023): Found entity 1: dds_settings File: <workspace>/LaseRangefinder_github/fpga/dds_settings.sv Line: 3
Info (12021): Found 2 design units, including 2 entities, in source file phase_clock.sv
    Info (12023): Found entity 1: phase_clock File: <workspace>/LaseRangefinder_github/fpga/phase_clock.sv Line: 2
    Info (12023): Found entity 2: reset_sync File: <workspace>/LaseRangefinder_github/fpga/phase_clock.sv Line: 26
Info (12021): Found 1 design units, including 1 entities, in source file ads8681_bank.sv
    Info (12023): Found entity 1: ads8681_bank File: <workspace>/LaseRangefinder_github/fpga/ads8681_bank.sv Line: 3
Info (12021): Found 1 design units, including 1 entities, in source file phase_demod.sv
    Info (12023): Found entity 1: phase_demod File: <workspace>/LaseRangefinder_github/fpga/phase_demod.sv Line: 3
Info (12021): Found 1 design units, including 1 entities, in source file cordic_atan.sv
    Info (12023): Found entity 1: cordic_atan File: <workspace>/LaseRangefinder_github/fpga/cordic_atan.sv Line: 3
Info (12021): Found 1 design units, including 1 entities, in source file phase_lsq.sv
    Info (12023): Found entity 1: phase_lsq File: <workspace>/LaseRangefinder_github/fpga/phase_lsq.sv Line: 3
Info (12021): Found 1 design units, including 1 entities, in source file uart_phy.sv
    Info (12023): Found entity 1: uart_phy File: <workspace>/LaseRangefinder_github/fpga/uart_phy.sv Line: 2
Info (12021): Found 1 design units, including 1 entities, in source file phase_link.sv
    Info (12023): Found entity 1: phase_link File: <workspace>/LaseRangefinder_github/fpga/phase_link.sv Line: 2
Info (12021): Found 1 design units, including 1 entities, in source file digital_phase_meter.sv
    Info (12023): Found entity 1: digital_phase_meter File: <workspace>/LaseRangefinder_github/fpga/digital_phase_meter.sv Line: 4
Info (12021): Found 1 design units, including 1 entities, in source file digital_phase_bridge.sv
    Info (12023): Found entity 1: digital_phase_bridge File: <workspace>/LaseRangefinder_github/fpga/digital_phase_bridge.sv Line: 3
Info (12127): Elaborating entity "DistanceSensorFpga_v0" for the top level hierarchy
Info (12128): Elaborating entity "reset_sync" for hierarchy "reset_sync:board_reset" File: <workspace>/LaseRangefinder_github/fpga/DistanceSensorFpga_v0.sv Line: 119
Info (12128): Elaborating entity "dds_settings" for hierarchy "dds_settings:config_bank" File: <workspace>/LaseRangefinder_github/fpga/DistanceSensorFpga_v0.sv Line: 135
Warning (10230): Verilog HDL assignment warning at dds_settings.sv(60): truncated value with size 32 to match size of target (18) File: <workspace>/LaseRangefinder_github/fpga/dds_settings.sv Line: 60
Warning (10230): Verilog HDL assignment warning at dds_settings.sv(61): truncated value with size 32 to match size of target (18) File: <workspace>/LaseRangefinder_github/fpga/dds_settings.sv Line: 61
Warning (10230): Verilog HDL assignment warning at dds_settings.sv(86): truncated value with size 20 to match size of target (19) File: <workspace>/LaseRangefinder_github/fpga/dds_settings.sv Line: 86
Info (12128): Elaborating entity "dds_programmer" for hierarchy "dds_programmer:ad9959_ctrl" File: <workspace>/LaseRangefinder_github/fpga/DistanceSensorFpga_v0.sv Line: 138
Warning (10230): Verilog HDL assignment warning at dds_programmer.sv(36): truncated value with size 32 to match size of target (2) File: <workspace>/LaseRangefinder_github/fpga/dds_programmer.sv Line: 36
Info (12128): Elaborating entity "phase_clock" for hierarchy "phase_clock:sample_clock" File: <workspace>/LaseRangefinder_github/fpga/DistanceSensorFpga_v0.sv Line: 142
Info (12128): Elaborating entity "altpll" for hierarchy "phase_clock:sample_clock|altpll:pll" File: <workspace>/LaseRangefinder_github/fpga/phase_clock.sv Line: 21
Info (12130): Elaborated megafunction instantiation "phase_clock:sample_clock|altpll:pll" File: <workspace>/LaseRangefinder_github/fpga/phase_clock.sv Line: 21
Info (12133): Instantiated megafunction "phase_clock:sample_clock|altpll:pll" with the following parameter: File: <workspace>/LaseRangefinder_github/fpga/phase_clock.sv Line: 21
    Info (12134): Parameter "bandwidth_type" = "AUTO"
    Info (12134): Parameter "clk0_divide_by" = "5"
    Info (12134): Parameter "clk0_multiply_by" = "2"
    Info (12134): Parameter "clk1_divide_by" = "1"
    Info (12134): Parameter "clk1_multiply_by" = "1"
    Info (12134): Parameter "clk1_duty_cycle" = "50"
    Info (12134): Parameter "clk1_phase_shift" = "-1250"
    Info (12134): Parameter "clk0_duty_cycle" = "50"
    Info (12134): Parameter "clk0_phase_shift" = "0"
    Info (12134): Parameter "compensate_clock" = "CLK0"
    Info (12134): Parameter "inclk0_input_frequency" = "8000"
    Info (12134): Parameter "intended_device_family" = "Cyclone IV E"
    Info (12134): Parameter "operation_mode" = "NORMAL"
    Info (12134): Parameter "pll_type" = "AUTO"
    Info (12134): Parameter "width_clock" = "5"
    Info (12134): Parameter "port_areset" = "PORT_USED"
    Info (12134): Parameter "port_inclk0" = "PORT_USED"
    Info (12134): Parameter "port_locked" = "PORT_USED"
    Info (12134): Parameter "port_clk0" = "PORT_USED"
    Info (12134): Parameter "port_clk1" = "PORT_USED"
Info (12021): Found 1 design units, including 1 entities, in source file db/altpll_1ud1.tdf
    Info (12023): Found entity 1: altpll_1ud1 File: <workspace>/LaseRangefinder_github/fpga/db/altpll_1ud1.tdf Line: 28
Info (12128): Elaborating entity "altpll_1ud1" for hierarchy "phase_clock:sample_clock|altpll:pll|altpll_1ud1:auto_generated" File: <Quartus>/libraries/megafunctions/altpll.tdf Line: 898
Info (12128): Elaborating entity "digital_phase_meter" for hierarchy "digital_phase_meter:digital_meter" File: <workspace>/LaseRangefinder_github/fpga/DistanceSensorFpga_v0.sv Line: 162
Warning (10036): Verilog HDL or VHDL warning at digital_phase_meter.sv(59): object "expected" assigned a value but never read File: <workspace>/LaseRangefinder_github/fpga/digital_phase_meter.sv Line: 59
Warning (10230): Verilog HDL assignment warning at digital_phase_meter.sv(119): truncated value with size 32 to match size of target (18) File: <workspace>/LaseRangefinder_github/fpga/digital_phase_meter.sv Line: 119
Info (12128): Elaborating entity "digital_phase_bridge" for hierarchy "digital_phase_bridge:digital_bridge" File: <workspace>/LaseRangefinder_github/fpga/DistanceSensorFpga_v0.sv Line: 168
Info (12128): Elaborating entity "ads8681_bank" for hierarchy "ads8681_bank:adc_bank" File: <workspace>/LaseRangefinder_github/fpga/DistanceSensorFpga_v0.sv Line: 181
Info (12128): Elaborating entity "phase_demod" for hierarchy "phase_demod:demod" File: <workspace>/LaseRangefinder_github/fpga/DistanceSensorFpga_v0.sv Line: 192
Warning (10030): Net "sine_rom.data_a" at phase_demod.sv(16) has no driver or initial value, using a default initial value '0' File: <workspace>/LaseRangefinder_github/fpga/phase_demod.sv Line: 16
Warning (10030): Net "sine_rom.waddr_a" at phase_demod.sv(16) has no driver or initial value, using a default initial value '0' File: <workspace>/LaseRangefinder_github/fpga/phase_demod.sv Line: 16
Warning (10030): Net "sine_rom.we_a" at phase_demod.sv(16) has no driver or initial value, using a default initial value '0' File: <workspace>/LaseRangefinder_github/fpga/phase_demod.sv Line: 16
Info (12128): Elaborating entity "phase_lsq" for hierarchy "phase_lsq:finalize" File: <workspace>/LaseRangefinder_github/fpga/DistanceSensorFpga_v0.sv Line: 196
Warning (10230): Verilog HDL assignment warning at phase_lsq.sv(18): truncated value with size 42 to match size of target (32) File: <workspace>/LaseRangefinder_github/fpga/phase_lsq.sv Line: 18
Warning (10230): Verilog HDL assignment warning at phase_lsq.sv(29): truncated value with size 64 to match size of target (32) File: <workspace>/LaseRangefinder_github/fpga/phase_lsq.sv Line: 29
Warning (10230): Verilog HDL assignment warning at phase_lsq.sv(32): truncated value with size 64 to match size of target (32) File: <workspace>/LaseRangefinder_github/fpga/phase_lsq.sv Line: 32
Info (10264): Verilog HDL Case Statement information at phase_lsq.sv(28): all case item expressions in this case statement are onehot File: <workspace>/LaseRangefinder_github/fpga/phase_lsq.sv Line: 28
Warning (10230): Verilog HDL assignment warning at phase_lsq.sv(43): truncated value with size 32 to match size of target (5) File: <workspace>/LaseRangefinder_github/fpga/phase_lsq.sv Line: 43
Info (12128): Elaborating entity "cordic_atan" for hierarchy "phase_lsq:finalize|cordic_atan:angle_unit" File: <workspace>/LaseRangefinder_github/fpga/phase_lsq.sv Line: 89
Warning (10230): Verilog HDL assignment warning at cordic_atan.sv(20): truncated value with size 34 to match size of target (28) File: <workspace>/LaseRangefinder_github/fpga/cordic_atan.sv Line: 20
Warning (10230): Verilog HDL assignment warning at cordic_atan.sv(21): truncated value with size 34 to match size of target (28) File: <workspace>/LaseRangefinder_github/fpga/cordic_atan.sv Line: 21
Warning (10230): Verilog HDL assignment warning at cordic_atan.sv(23): truncated value with size 32 to match size of target (28) File: <workspace>/LaseRangefinder_github/fpga/cordic_atan.sv Line: 23
Warning (10030): Net "table_atan.data_a" at cordic_atan.sv(11) has no driver or initial value, using a default initial value '0' File: <workspace>/LaseRangefinder_github/fpga/cordic_atan.sv Line: 11
Warning (10030): Net "table_atan.waddr_a" at cordic_atan.sv(11) has no driver or initial value, using a default initial value '0' File: <workspace>/LaseRangefinder_github/fpga/cordic_atan.sv Line: 11
Warning (10030): Net "table_atan.we_a" at cordic_atan.sv(11) has no driver or initial value, using a default initial value '0' File: <workspace>/LaseRangefinder_github/fpga/cordic_atan.sv Line: 11
Info (12128): Elaborating entity "phase_link" for hierarchy "phase_link:link" File: <workspace>/LaseRangefinder_github/fpga/DistanceSensorFpga_v0.sv Line: 212
Info (12128): Elaborating entity "uart_phy" for hierarchy "phase_link:link|uart_phy:phy" File: <workspace>/LaseRangefinder_github/fpga/phase_link.sv Line: 34
Info (19000): Inferred 11 megafunctions from design logic
    Info (276029): Inferred altsyncram megafunction from the following design logic: "digital_phase_meter:digital_meter|history_rtl_0" 
        Info (286033): Parameter OPERATION_MODE set to SINGLE_PORT
        Info (286033): Parameter WIDTH_A set to 75
        Info (286033): Parameter WIDTHAD_A set to 3
        Info (286033): Parameter NUMWORDS_A set to 8
        Info (286033): Parameter OUTDATA_REG_A set to UNREGISTERED
        Info (286033): Parameter ADDRESS_ACLR_A set to NONE
        Info (286033): Parameter OUTDATA_ACLR_A set to NONE
        Info (286033): Parameter READ_DURING_WRITE_MODE_PORT_A set to OLD_DATA
        Info (286033): Parameter INDATA_ACLR_A set to NONE
        Info (286033): Parameter WRCONTROL_ACLR_A set to NONE
        Info (286033): Parameter RAM_BLOCK_TYPE set to M9K
    Info (276029): Inferred altsyncram megafunction from the following design logic: "dds_settings:config_bank|staging_rtl_0" 
        Info (286033): Parameter OPERATION_MODE set to DUAL_PORT
        Info (286033): Parameter WIDTH_A set to 16
        Info (286033): Parameter WIDTHAD_A set to 4
        Info (286033): Parameter NUMWORDS_A set to 16
        Info (286033): Parameter WIDTH_B set to 16
        Info (286033): Parameter WIDTHAD_B set to 4
        Info (286033): Parameter NUMWORDS_B set to 16
        Info (286033): Parameter ADDRESS_ACLR_A set to NONE
        Info (286033): Parameter OUTDATA_REG_B set to UNREGISTERED
        Info (286033): Parameter ADDRESS_ACLR_B set to NONE
        Info (286033): Parameter OUTDATA_ACLR_B set to NONE
        Info (286033): Parameter ADDRESS_REG_B set to CLOCK0
        Info (286033): Parameter INDATA_ACLR_A set to NONE
        Info (286033): Parameter WRCONTROL_ACLR_A set to NONE
        Info (286033): Parameter RAM_BLOCK_TYPE set to M9K
        Info (286033): Parameter READ_DURING_WRITE_MODE_MIXED_PORTS set to OLD_DATA
    Info (276029): Inferred altsyncram megafunction from the following design logic: "phase_link:link|packet_mem_rtl_0" 
        Info (286033): Parameter OPERATION_MODE set to DUAL_PORT
        Info (286033): Parameter WIDTH_A set to 8
        Info (286033): Parameter WIDTHAD_A set to 7
        Info (286033): Parameter NUMWORDS_A set to 128
        Info (286033): Parameter WIDTH_B set to 8
        Info (286033): Parameter WIDTHAD_B set to 7
        Info (286033): Parameter NUMWORDS_B set to 128
        Info (286033): Parameter ADDRESS_ACLR_A set to NONE
        Info (286033): Parameter OUTDATA_REG_B set to UNREGISTERED
        Info (286033): Parameter ADDRESS_ACLR_B set to NONE
        Info (286033): Parameter OUTDATA_ACLR_B set to NONE
        Info (286033): Parameter ADDRESS_REG_B set to CLOCK0
        Info (286033): Parameter INDATA_ACLR_A set to NONE
        Info (286033): Parameter WRCONTROL_ACLR_A set to NONE
        Info (286033): Parameter RAM_BLOCK_TYPE set to M9K
        Info (286033): Parameter READ_DURING_WRITE_MODE_MIXED_PORTS set to OLD_DATA
    Info (276029): Inferred altsyncram megafunction from the following design logic: "phase_lsq:finalize|work_rtl_0" 
        Info (286033): Parameter OPERATION_MODE set to DUAL_PORT
        Info (286033): Parameter WIDTH_A set to 32
        Info (286033): Parameter WIDTHAD_A set to 5
        Info (286033): Parameter NUMWORDS_A set to 32
        Info (286033): Parameter WIDTH_B set to 32
        Info (286033): Parameter WIDTHAD_B set to 5
        Info (286033): Parameter NUMWORDS_B set to 32
        Info (286033): Parameter ADDRESS_ACLR_A set to NONE
        Info (286033): Parameter OUTDATA_REG_B set to UNREGISTERED
        Info (286033): Parameter ADDRESS_ACLR_B set to NONE
        Info (286033): Parameter OUTDATA_ACLR_B set to NONE
        Info (286033): Parameter ADDRESS_REG_B set to CLOCK0
        Info (286033): Parameter INDATA_ACLR_A set to NONE
        Info (286033): Parameter WRCONTROL_ACLR_A set to NONE
        Info (286033): Parameter RAM_BLOCK_TYPE set to M9K
        Info (286033): Parameter READ_DURING_WRITE_MODE_MIXED_PORTS set to OLD_DATA
    Info (276029): Inferred altsyncram megafunction from the following design logic: "phase_lsq:finalize|work_rtl_1" 
        Info (286033): Parameter OPERATION_MODE set to DUAL_PORT
        Info (286033): Parameter WIDTH_A set to 32
        Info (286033): Parameter WIDTHAD_A set to 5
        Info (286033): Parameter NUMWORDS_A set to 32
        Info (286033): Parameter WIDTH_B set to 32
        Info (286033): Parameter WIDTHAD_B set to 5
        Info (286033): Parameter NUMWORDS_B set to 32
        Info (286033): Parameter ADDRESS_ACLR_A set to NONE
        Info (286033): Parameter OUTDATA_REG_B set to UNREGISTERED
        Info (286033): Parameter ADDRESS_ACLR_B set to NONE
        Info (286033): Parameter OUTDATA_ACLR_B set to NONE
        Info (286033): Parameter ADDRESS_REG_B set to CLOCK0
        Info (286033): Parameter INDATA_ACLR_A set to NONE
        Info (286033): Parameter WRCONTROL_ACLR_A set to NONE
        Info (286033): Parameter RAM_BLOCK_TYPE set to M9K
        Info (286033): Parameter READ_DURING_WRITE_MODE_MIXED_PORTS set to OLD_DATA
    Info (276029): Inferred altsyncram megafunction from the following design logic: "digital_phase_meter:digital_meter|averages_rtl_0" 
        Info (286033): Parameter OPERATION_MODE set to SINGLE_PORT
        Info (286033): Parameter WIDTH_A set to 24
        Info (286033): Parameter WIDTHAD_A set to 3
        Info (286033): Parameter NUMWORDS_A set to 8
        Info (286033): Parameter OUTDATA_REG_A set to UNREGISTERED
        Info (286033): Parameter ADDRESS_ACLR_A set to NONE
        Info (286033): Parameter OUTDATA_ACLR_A set to NONE
        Info (286033): Parameter READ_DURING_WRITE_MODE_PORT_A set to OLD_DATA
        Info (286033): Parameter INDATA_ACLR_A set to NONE
        Info (286033): Parameter WRCONTROL_ACLR_A set to NONE
        Info (286033): Parameter RAM_BLOCK_TYPE set to M9K
    Info (276029): Inferred altsyncram megafunction from the following design logic: "phase_demod:demod|window_mem_rtl_0" 
        Info (286033): Parameter OPERATION_MODE set to DUAL_PORT
        Info (286033): Parameter WIDTH_A set to 32
        Info (286033): Parameter WIDTHAD_A set to 5
        Info (286033): Parameter NUMWORDS_A set to 32
        Info (286033): Parameter WIDTH_B set to 32
        Info (286033): Parameter WIDTHAD_B set to 5
        Info (286033): Parameter NUMWORDS_B set to 32
        Info (286033): Parameter ADDRESS_ACLR_A set to NONE
        Info (286033): Parameter OUTDATA_REG_B set to UNREGISTERED
        Info (286033): Parameter ADDRESS_ACLR_B set to NONE
        Info (286033): Parameter OUTDATA_ACLR_B set to NONE
        Info (286033): Parameter ADDRESS_REG_B set to CLOCK0
        Info (286033): Parameter INDATA_ACLR_A set to NONE
        Info (286033): Parameter WRCONTROL_ACLR_A set to NONE
        Info (286033): Parameter RAM_BLOCK_TYPE set to M9K
        Info (286033): Parameter READ_DURING_WRITE_MODE_MIXED_PORTS set to OLD_DATA
    Info (276029): Inferred altsyncram megafunction from the following design logic: "phase_demod:demod|acc_mem_rtl_0" 
        Info (286033): Parameter OPERATION_MODE set to SINGLE_PORT
        Info (286033): Parameter WIDTH_A set to 42
        Info (286033): Parameter WIDTHAD_A set to 5
        Info (286033): Parameter NUMWORDS_A set to 32
        Info (286033): Parameter OUTDATA_REG_A set to UNREGISTERED
        Info (286033): Parameter ADDRESS_ACLR_A set to NONE
        Info (286033): Parameter OUTDATA_ACLR_A set to NONE
        Info (286033): Parameter READ_DURING_WRITE_MODE_PORT_A set to OLD_DATA
        Info (286033): Parameter INDATA_ACLR_A set to NONE
        Info (286033): Parameter WRCONTROL_ACLR_A set to NONE
        Info (286033): Parameter RAM_BLOCK_TYPE set to M9K
    Info (276029): Inferred altsyncram megafunction from the following design logic: "phase_demod:demod|total_mem_rtl_0" 
        Info (286033): Parameter OPERATION_MODE set to SINGLE_PORT
        Info (286033): Parameter WIDTH_A set to 42
        Info (286033): Parameter WIDTHAD_A set to 5
        Info (286033): Parameter NUMWORDS_A set to 32
        Info (286033): Parameter OUTDATA_REG_A set to UNREGISTERED
        Info (286033): Parameter ADDRESS_ACLR_A set to NONE
        Info (286033): Parameter OUTDATA_ACLR_A set to NONE
        Info (286033): Parameter READ_DURING_WRITE_MODE_PORT_A set to OLD_DATA
        Info (286033): Parameter INDATA_ACLR_A set to NONE
        Info (286033): Parameter WRCONTROL_ACLR_A set to NONE
        Info (286033): Parameter RAM_BLOCK_TYPE set to M9K
    Info (276029): Inferred altsyncram megafunction from the following design logic: "phase_demod:demod|history_mem_rtl_0" 
        Info (286033): Parameter OPERATION_MODE set to SINGLE_PORT
        Info (286033): Parameter WIDTH_A set to 42
        Info (286033): Parameter WIDTHAD_A set to 7
        Info (286033): Parameter NUMWORDS_A set to 128
        Info (286033): Parameter OUTDATA_REG_A set to UNREGISTERED
        Info (286033): Parameter ADDRESS_ACLR_A set to NONE
        Info (286033): Parameter OUTDATA_ACLR_A set to NONE
        Info (286033): Parameter READ_DURING_WRITE_MODE_PORT_A set to OLD_DATA
        Info (286033): Parameter INDATA_ACLR_A set to NONE
        Info (286033): Parameter WRCONTROL_ACLR_A set to NONE
        Info (286033): Parameter RAM_BLOCK_TYPE set to M9K
    Info (276029): Inferred altsyncram megafunction from the following design logic: "phase_demod:demod|sine_rom_rtl_0" 
        Info (286033): Parameter OPERATION_MODE set to BIDIR_DUAL_PORT
        Info (286033): Parameter WIDTH_A set to 16
        Info (286033): Parameter WIDTH_B set to 16
        Info (286033): Parameter WIDTHAD_A set to 12
        Info (286033): Parameter WIDTHAD_B set to 12
        Info (286033): Parameter NUMWORDS_A set to 4096
        Info (286033): Parameter NUMWORDS_B set to 4096
        Info (286033): Parameter OUTDATA_REG_A set to UNREGISTERED
        Info (286033): Parameter OUTDATA_REG_B set to UNREGISTERED
        Info (286033): Parameter ADDRESS_REG_B set to CLOCK0
        Info (286033): Parameter INDATA_REG_B set to CLOCK0
        Info (286033): Parameter WRCONTROL_WRADDRESS_REG_B set to CLOCK0
        Info (286033): Parameter INDATA_ACLR_A set to NONE
        Info (286033): Parameter WRCONTROL_ACLR_A set to NONE
        Info (286033): Parameter ADDRESS_ACLR_A set to NONE
        Info (286033): Parameter ADDRESS_ACLR_B set to NONE
        Info (286033): Parameter OUTDATA_ACLR_B set to NONE
        Info (286033): Parameter INIT_FILE set to db/DistanceSensorFpga_v0.ram0_phase_demod_e102cc5e.hdl.mif
Info (278001): Inferred 3 megafunctions from design logic
    Info (278003): Inferred multiplier megafunction ("lpm_mult") from the following logic: "phase_lsq:finalize|Mult0" File: <workspace>/LaseRangefinder_github/fpga/phase_lsq.sv Line: 24
    Info (278003): Inferred multiplier megafunction ("lpm_mult") from the following logic: "phase_demod:demod|Mult0" File: <workspace>/LaseRangefinder_github/fpga/phase_demod.sv Line: 49
    Info (278002): Inferred adder/subtractor megafunction ("lpm_add_sub") from the following logic: "phase_lsq:finalize|cordic_atan:angle_unit|Add4" File: <workspace>/LaseRangefinder_github/fpga/cordic_atan.sv Line: 29
Info (12130): Elaborated megafunction instantiation "digital_phase_meter:digital_meter|altsyncram:history_rtl_0"
Info (12133): Instantiated megafunction "digital_phase_meter:digital_meter|altsyncram:history_rtl_0" with the following parameter:
    Info (12134): Parameter "OPERATION_MODE" = "SINGLE_PORT"
    Info (12134): Parameter "WIDTH_A" = "75"
    Info (12134): Parameter "WIDTHAD_A" = "3"
    Info (12134): Parameter "NUMWORDS_A" = "8"
    Info (12134): Parameter "OUTDATA_REG_A" = "UNREGISTERED"
    Info (12134): Parameter "ADDRESS_ACLR_A" = "NONE"
    Info (12134): Parameter "OUTDATA_ACLR_A" = "NONE"
    Info (12134): Parameter "READ_DURING_WRITE_MODE_PORT_A" = "OLD_DATA"
    Info (12134): Parameter "INDATA_ACLR_A" = "NONE"
    Info (12134): Parameter "WRCONTROL_ACLR_A" = "NONE"
    Info (12134): Parameter "RAM_BLOCK_TYPE" = "M9K"
Info (12021): Found 1 design units, including 1 entities, in source file db/altsyncram_l6a1.tdf
    Info (12023): Found entity 1: altsyncram_l6a1 File: <workspace>/LaseRangefinder_github/fpga/db/altsyncram_l6a1.tdf Line: 28
Info (12130): Elaborated megafunction instantiation "dds_settings:config_bank|altsyncram:staging_rtl_0"
Info (12133): Instantiated megafunction "dds_settings:config_bank|altsyncram:staging_rtl_0" with the following parameter:
    Info (12134): Parameter "OPERATION_MODE" = "DUAL_PORT"
    Info (12134): Parameter "WIDTH_A" = "16"
    Info (12134): Parameter "WIDTHAD_A" = "4"
    Info (12134): Parameter "NUMWORDS_A" = "16"
    Info (12134): Parameter "WIDTH_B" = "16"
    Info (12134): Parameter "WIDTHAD_B" = "4"
    Info (12134): Parameter "NUMWORDS_B" = "16"
    Info (12134): Parameter "ADDRESS_ACLR_A" = "NONE"
    Info (12134): Parameter "OUTDATA_REG_B" = "UNREGISTERED"
    Info (12134): Parameter "ADDRESS_ACLR_B" = "NONE"
    Info (12134): Parameter "OUTDATA_ACLR_B" = "NONE"
    Info (12134): Parameter "ADDRESS_REG_B" = "CLOCK0"
    Info (12134): Parameter "INDATA_ACLR_A" = "NONE"
    Info (12134): Parameter "WRCONTROL_ACLR_A" = "NONE"
    Info (12134): Parameter "RAM_BLOCK_TYPE" = "M9K"
    Info (12134): Parameter "READ_DURING_WRITE_MODE_MIXED_PORTS" = "OLD_DATA"
Info (12021): Found 1 design units, including 1 entities, in source file db/altsyncram_hoi1.tdf
    Info (12023): Found entity 1: altsyncram_hoi1 File: <workspace>/LaseRangefinder_github/fpga/db/altsyncram_hoi1.tdf Line: 28
Info (12130): Elaborated megafunction instantiation "phase_link:link|altsyncram:packet_mem_rtl_0"
Info (12133): Instantiated megafunction "phase_link:link|altsyncram:packet_mem_rtl_0" with the following parameter:
    Info (12134): Parameter "OPERATION_MODE" = "DUAL_PORT"
    Info (12134): Parameter "WIDTH_A" = "8"
    Info (12134): Parameter "WIDTHAD_A" = "7"
    Info (12134): Parameter "NUMWORDS_A" = "128"
    Info (12134): Parameter "WIDTH_B" = "8"
    Info (12134): Parameter "WIDTHAD_B" = "7"
    Info (12134): Parameter "NUMWORDS_B" = "128"
    Info (12134): Parameter "ADDRESS_ACLR_A" = "NONE"
    Info (12134): Parameter "OUTDATA_REG_B" = "UNREGISTERED"
    Info (12134): Parameter "ADDRESS_ACLR_B" = "NONE"
    Info (12134): Parameter "OUTDATA_ACLR_B" = "NONE"
    Info (12134): Parameter "ADDRESS_REG_B" = "CLOCK0"
    Info (12134): Parameter "INDATA_ACLR_A" = "NONE"
    Info (12134): Parameter "WRCONTROL_ACLR_A" = "NONE"
    Info (12134): Parameter "RAM_BLOCK_TYPE" = "M9K"
    Info (12134): Parameter "READ_DURING_WRITE_MODE_MIXED_PORTS" = "OLD_DATA"
Info (12021): Found 1 design units, including 1 entities, in source file db/altsyncram_1pi1.tdf
    Info (12023): Found entity 1: altsyncram_1pi1 File: <workspace>/LaseRangefinder_github/fpga/db/altsyncram_1pi1.tdf Line: 28
Info (12130): Elaborated megafunction instantiation "phase_lsq:finalize|altsyncram:work_rtl_0"
Info (12133): Instantiated megafunction "phase_lsq:finalize|altsyncram:work_rtl_0" with the following parameter:
    Info (12134): Parameter "OPERATION_MODE" = "DUAL_PORT"
    Info (12134): Parameter "WIDTH_A" = "32"
    Info (12134): Parameter "WIDTHAD_A" = "5"
    Info (12134): Parameter "NUMWORDS_A" = "32"
    Info (12134): Parameter "WIDTH_B" = "32"
    Info (12134): Parameter "WIDTHAD_B" = "5"
    Info (12134): Parameter "NUMWORDS_B" = "32"
    Info (12134): Parameter "ADDRESS_ACLR_A" = "NONE"
    Info (12134): Parameter "OUTDATA_REG_B" = "UNREGISTERED"
    Info (12134): Parameter "ADDRESS_ACLR_B" = "NONE"
    Info (12134): Parameter "OUTDATA_ACLR_B" = "NONE"
    Info (12134): Parameter "ADDRESS_REG_B" = "CLOCK0"
    Info (12134): Parameter "INDATA_ACLR_A" = "NONE"
    Info (12134): Parameter "WRCONTROL_ACLR_A" = "NONE"
    Info (12134): Parameter "RAM_BLOCK_TYPE" = "M9K"
    Info (12134): Parameter "READ_DURING_WRITE_MODE_MIXED_PORTS" = "OLD_DATA"
Info (12021): Found 1 design units, including 1 entities, in source file db/altsyncram_boi1.tdf
    Info (12023): Found entity 1: altsyncram_boi1 File: <workspace>/LaseRangefinder_github/fpga/db/altsyncram_boi1.tdf Line: 28
Info (12130): Elaborated megafunction instantiation "digital_phase_meter:digital_meter|altsyncram:averages_rtl_0"
Info (12133): Instantiated megafunction "digital_phase_meter:digital_meter|altsyncram:averages_rtl_0" with the following parameter:
    Info (12134): Parameter "OPERATION_MODE" = "SINGLE_PORT"
    Info (12134): Parameter "WIDTH_A" = "24"
    Info (12134): Parameter "WIDTHAD_A" = "3"
    Info (12134): Parameter "NUMWORDS_A" = "8"
    Info (12134): Parameter "OUTDATA_REG_A" = "UNREGISTERED"
    Info (12134): Parameter "ADDRESS_ACLR_A" = "NONE"
    Info (12134): Parameter "OUTDATA_ACLR_A" = "NONE"
    Info (12134): Parameter "READ_DURING_WRITE_MODE_PORT_A" = "OLD_DATA"
    Info (12134): Parameter "INDATA_ACLR_A" = "NONE"
    Info (12134): Parameter "WRCONTROL_ACLR_A" = "NONE"
    Info (12134): Parameter "RAM_BLOCK_TYPE" = "M9K"
Info (12021): Found 1 design units, including 1 entities, in source file db/altsyncram_f6a1.tdf
    Info (12023): Found entity 1: altsyncram_f6a1 File: <workspace>/LaseRangefinder_github/fpga/db/altsyncram_f6a1.tdf Line: 28
Info (12130): Elaborated megafunction instantiation "phase_demod:demod|altsyncram:acc_mem_rtl_0"
Info (12133): Instantiated megafunction "phase_demod:demod|altsyncram:acc_mem_rtl_0" with the following parameter:
    Info (12134): Parameter "OPERATION_MODE" = "SINGLE_PORT"
    Info (12134): Parameter "WIDTH_A" = "42"
    Info (12134): Parameter "WIDTHAD_A" = "5"
    Info (12134): Parameter "NUMWORDS_A" = "32"
    Info (12134): Parameter "OUTDATA_REG_A" = "UNREGISTERED"
    Info (12134): Parameter "ADDRESS_ACLR_A" = "NONE"
    Info (12134): Parameter "OUTDATA_ACLR_A" = "NONE"
    Info (12134): Parameter "READ_DURING_WRITE_MODE_PORT_A" = "OLD_DATA"
    Info (12134): Parameter "INDATA_ACLR_A" = "NONE"
    Info (12134): Parameter "WRCONTROL_ACLR_A" = "NONE"
    Info (12134): Parameter "RAM_BLOCK_TYPE" = "M9K"
Info (12021): Found 1 design units, including 1 entities, in source file db/altsyncram_u7a1.tdf
    Info (12023): Found entity 1: altsyncram_u7a1 File: <workspace>/LaseRangefinder_github/fpga/db/altsyncram_u7a1.tdf Line: 28
Info (12130): Elaborated megafunction instantiation "phase_demod:demod|altsyncram:history_mem_rtl_0"
Info (12133): Instantiated megafunction "phase_demod:demod|altsyncram:history_mem_rtl_0" with the following parameter:
    Info (12134): Parameter "OPERATION_MODE" = "SINGLE_PORT"
    Info (12134): Parameter "WIDTH_A" = "42"
    Info (12134): Parameter "WIDTHAD_A" = "7"
    Info (12134): Parameter "NUMWORDS_A" = "128"
    Info (12134): Parameter "OUTDATA_REG_A" = "UNREGISTERED"
    Info (12134): Parameter "ADDRESS_ACLR_A" = "NONE"
    Info (12134): Parameter "OUTDATA_ACLR_A" = "NONE"
    Info (12134): Parameter "READ_DURING_WRITE_MODE_PORT_A" = "OLD_DATA"
    Info (12134): Parameter "INDATA_ACLR_A" = "NONE"
    Info (12134): Parameter "WRCONTROL_ACLR_A" = "NONE"
    Info (12134): Parameter "RAM_BLOCK_TYPE" = "M9K"
Info (12021): Found 1 design units, including 1 entities, in source file db/altsyncram_m9a1.tdf
    Info (12023): Found entity 1: altsyncram_m9a1 File: <workspace>/LaseRangefinder_github/fpga/db/altsyncram_m9a1.tdf Line: 28
Info (12130): Elaborated megafunction instantiation "phase_demod:demod|altsyncram:sine_rom_rtl_0"
Info (12133): Instantiated megafunction "phase_demod:demod|altsyncram:sine_rom_rtl_0" with the following parameter:
    Info (12134): Parameter "OPERATION_MODE" = "BIDIR_DUAL_PORT"
    Info (12134): Parameter "WIDTH_A" = "16"
    Info (12134): Parameter "WIDTH_B" = "16"
    Info (12134): Parameter "WIDTHAD_A" = "12"
    Info (12134): Parameter "WIDTHAD_B" = "12"
    Info (12134): Parameter "NUMWORDS_A" = "4096"
    Info (12134): Parameter "NUMWORDS_B" = "4096"
    Info (12134): Parameter "OUTDATA_REG_A" = "UNREGISTERED"
    Info (12134): Parameter "OUTDATA_REG_B" = "UNREGISTERED"
    Info (12134): Parameter "ADDRESS_REG_B" = "CLOCK0"
    Info (12134): Parameter "INDATA_REG_B" = "CLOCK0"
    Info (12134): Parameter "WRCONTROL_WRADDRESS_REG_B" = "CLOCK0"
    Info (12134): Parameter "INDATA_ACLR_A" = "NONE"
    Info (12134): Parameter "WRCONTROL_ACLR_A" = "NONE"
    Info (12134): Parameter "ADDRESS_ACLR_A" = "NONE"
    Info (12134): Parameter "ADDRESS_ACLR_B" = "NONE"
    Info (12134): Parameter "OUTDATA_ACLR_B" = "NONE"
    Info (12134): Parameter "INIT_FILE" = "db/DistanceSensorFpga_v0.ram0_phase_demod_e102cc5e.hdl.mif"
Info (12021): Found 1 design units, including 1 entities, in source file db/altsyncram_4qq1.tdf
    Info (12023): Found entity 1: altsyncram_4qq1 File: <workspace>/LaseRangefinder_github/fpga/db/altsyncram_4qq1.tdf Line: 28
Info (12130): Elaborated megafunction instantiation "phase_lsq:finalize|lpm_mult:Mult0" File: <workspace>/LaseRangefinder_github/fpga/phase_lsq.sv Line: 24
Info (12133): Instantiated megafunction "phase_lsq:finalize|lpm_mult:Mult0" with the following parameter: File: <workspace>/LaseRangefinder_github/fpga/phase_lsq.sv Line: 24
    Info (12134): Parameter "LPM_WIDTHA" = "32"
    Info (12134): Parameter "LPM_WIDTHB" = "32"
    Info (12134): Parameter "LPM_WIDTHP" = "64"
    Info (12134): Parameter "LPM_WIDTHR" = "64"
    Info (12134): Parameter "LPM_WIDTHS" = "1"
    Info (12134): Parameter "LPM_REPRESENTATION" = "SIGNED"
    Info (12134): Parameter "INPUT_A_IS_CONSTANT" = "NO"
    Info (12134): Parameter "INPUT_B_IS_CONSTANT" = "NO"
    Info (12134): Parameter "MAXIMIZE_SPEED" = "5"
Info (12021): Found 1 design units, including 1 entities, in source file db/mult_46t.tdf
    Info (12023): Found entity 1: mult_46t File: <workspace>/LaseRangefinder_github/fpga/db/mult_46t.tdf Line: 31
Info (12130): Elaborated megafunction instantiation "phase_demod:demod|lpm_mult:Mult0" File: <workspace>/LaseRangefinder_github/fpga/phase_demod.sv Line: 49
Info (12133): Instantiated megafunction "phase_demod:demod|lpm_mult:Mult0" with the following parameter: File: <workspace>/LaseRangefinder_github/fpga/phase_demod.sv Line: 49
    Info (12134): Parameter "LPM_WIDTHA" = "17"
    Info (12134): Parameter "LPM_WIDTHB" = "17"
    Info (12134): Parameter "LPM_WIDTHP" = "34"
    Info (12134): Parameter "LPM_WIDTHR" = "34"
    Info (12134): Parameter "LPM_WIDTHS" = "1"
    Info (12134): Parameter "LPM_REPRESENTATION" = "SIGNED"
    Info (12134): Parameter "INPUT_A_IS_CONSTANT" = "NO"
    Info (12134): Parameter "INPUT_B_IS_CONSTANT" = "NO"
    Info (12134): Parameter "MAXIMIZE_SPEED" = "5"
Info (12021): Found 1 design units, including 1 entities, in source file db/mult_76t.tdf
    Info (12023): Found entity 1: mult_76t File: <workspace>/LaseRangefinder_github/fpga/db/mult_76t.tdf Line: 29
Info (12130): Elaborated megafunction instantiation "phase_lsq:finalize|cordic_atan:angle_unit|lpm_add_sub:Add4" File: <workspace>/LaseRangefinder_github/fpga/cordic_atan.sv Line: 29
Info (12133): Instantiated megafunction "phase_lsq:finalize|cordic_atan:angle_unit|lpm_add_sub:Add4" with the following parameter: File: <workspace>/LaseRangefinder_github/fpga/cordic_atan.sv Line: 29
    Info (12134): Parameter "LPM_WIDTH" = "32"
    Info (12134): Parameter "LPM_DIRECTION" = "DEFAULT"
    Info (12134): Parameter "LPM_REPRESENTATION" = "UNSIGNED"
    Info (12134): Parameter "ONE_INPUT_IS_CONSTANT" = "NO"
Info (12021): Found 1 design units, including 1 entities, in source file db/add_sub_pvi.tdf
    Info (12023): Found entity 1: add_sub_pvi File: <workspace>/LaseRangefinder_github/fpga/db/add_sub_pvi.tdf Line: 23
Warning (12241): 1 hierarchies have connectivity warnings - see the Connectivity Checks report folder
Info (13014): Ignored 190 buffer(s)
    Info (13019): Ignored 190 SOFT buffer(s)
Info (13000): Registers with preset signals will power-up high File: <workspace>/LaseRangefinder_github/fpga/uart_phy.sv Line: 4
Info (13003): DEV_CLRn pin will set, and not reset, register with preset signal due to NOT Gate Push-Back
Warning (13024): Output pins are stuck at VCC or GND
    Warning (13410): Pin "ad9959_p0" is stuck at GND File: <workspace>/LaseRangefinder_github/fpga/DistanceSensorFpga_v0.sv Line: 63
    Warning (13410): Pin "ad9959_p1" is stuck at GND File: <workspace>/LaseRangefinder_github/fpga/DistanceSensorFpga_v0.sv Line: 64
    Warning (13410): Pin "ad9959_p2" is stuck at GND File: <workspace>/LaseRangefinder_github/fpga/DistanceSensorFpga_v0.sv Line: 65
    Warning (13410): Pin "ad9959_p3" is stuck at GND File: <workspace>/LaseRangefinder_github/fpga/DistanceSensorFpga_v0.sv Line: 66
    Warning (13410): Pin "ad9959_sdio1" is stuck at GND File: <workspace>/LaseRangefinder_github/fpga/DistanceSensorFpga_v0.sv Line: 68
    Warning (13410): Pin "ad9959_sdio2" is stuck at GND File: <workspace>/LaseRangefinder_github/fpga/DistanceSensorFpga_v0.sv Line: 69
    Warning (13410): Pin "ad9959_sdio3" is stuck at GND File: <workspace>/LaseRangefinder_github/fpga/DistanceSensorFpga_v0.sv Line: 70
    Warning (13410): Pin "K6R4008V1D_a0" is stuck at GND File: <workspace>/LaseRangefinder_github/fpga/DistanceSensorFpga_v0.sv Line: 75
    Warning (13410): Pin "K6R4008V1D_a1" is stuck at GND File: <workspace>/LaseRangefinder_github/fpga/DistanceSensorFpga_v0.sv Line: 76
    Warning (13410): Pin "K6R4008V1D_a2" is stuck at GND File: <workspace>/LaseRangefinder_github/fpga/DistanceSensorFpga_v0.sv Line: 77
    Warning (13410): Pin "K6R4008V1D_a3" is stuck at GND File: <workspace>/LaseRangefinder_github/fpga/DistanceSensorFpga_v0.sv Line: 78
    Warning (13410): Pin "K6R4008V1D_a4" is stuck at GND File: <workspace>/LaseRangefinder_github/fpga/DistanceSensorFpga_v0.sv Line: 79
    Warning (13410): Pin "K6R4008V1D_a5" is stuck at GND File: <workspace>/LaseRangefinder_github/fpga/DistanceSensorFpga_v0.sv Line: 80
    Warning (13410): Pin "K6R4008V1D_a6" is stuck at GND File: <workspace>/LaseRangefinder_github/fpga/DistanceSensorFpga_v0.sv Line: 81
    Warning (13410): Pin "K6R4008V1D_a7" is stuck at GND File: <workspace>/LaseRangefinder_github/fpga/DistanceSensorFpga_v0.sv Line: 82
    Warning (13410): Pin "K6R4008V1D_a8" is stuck at GND File: <workspace>/LaseRangefinder_github/fpga/DistanceSensorFpga_v0.sv Line: 83
    Warning (13410): Pin "K6R4008V1D_a9" is stuck at GND File: <workspace>/LaseRangefinder_github/fpga/DistanceSensorFpga_v0.sv Line: 84
    Warning (13410): Pin "K6R4008V1D_a10" is stuck at GND File: <workspace>/LaseRangefinder_github/fpga/DistanceSensorFpga_v0.sv Line: 85
    Warning (13410): Pin "K6R4008V1D_a11" is stuck at GND File: <workspace>/LaseRangefinder_github/fpga/DistanceSensorFpga_v0.sv Line: 86
    Warning (13410): Pin "K6R4008V1D_a12" is stuck at GND File: <workspace>/LaseRangefinder_github/fpga/DistanceSensorFpga_v0.sv Line: 87
    Warning (13410): Pin "K6R4008V1D_a13" is stuck at GND File: <workspace>/LaseRangefinder_github/fpga/DistanceSensorFpga_v0.sv Line: 88
    Warning (13410): Pin "K6R4008V1D_a14" is stuck at GND File: <workspace>/LaseRangefinder_github/fpga/DistanceSensorFpga_v0.sv Line: 89
    Warning (13410): Pin "K6R4008V1D_a15" is stuck at GND File: <workspace>/LaseRangefinder_github/fpga/DistanceSensorFpga_v0.sv Line: 90
    Warning (13410): Pin "K6R4008V1D_a16" is stuck at GND File: <workspace>/LaseRangefinder_github/fpga/DistanceSensorFpga_v0.sv Line: 91
    Warning (13410): Pin "K6R4008V1D_a17" is stuck at GND File: <workspace>/LaseRangefinder_github/fpga/DistanceSensorFpga_v0.sv Line: 92
    Warning (13410): Pin "K6R4008V1D_a18" is stuck at GND File: <workspace>/LaseRangefinder_github/fpga/DistanceSensorFpga_v0.sv Line: 93
    Warning (13410): Pin "K6R4008V1D_oe" is stuck at VCC File: <workspace>/LaseRangefinder_github/fpga/DistanceSensorFpga_v0.sv Line: 94
    Warning (13410): Pin "K6R4008V1D_we" is stuck at VCC File: <workspace>/LaseRangefinder_github/fpga/DistanceSensorFpga_v0.sv Line: 95
    Warning (13410): Pin "K6R4008V1D_cs" is stuck at VCC File: <workspace>/LaseRangefinder_github/fpga/DistanceSensorFpga_v0.sv Line: 96
Info (286030): Timing-Driven Synthesis is running
Info (17049): 30 registers lost all their fanouts during netlist optimizations.
Info (16010): Generating hard_block partition "hard_block:auto_generated_inst"
    Info (16011): Adding 1 node(s), including 0 DDIO, 1 PLL, 0 transceiver and 0 LCELL
Warning (21074): Design contains 3 input pin(s) that do not drive logic
    Warning (15610): No output dependent on input pin "mcu_p1" File: <workspace>/LaseRangefinder_github/fpga/DistanceSensorFpga_v0.sv Line: 5
    Warning (15610): No output dependent on input pin "mcu_p2" File: <workspace>/LaseRangefinder_github/fpga/DistanceSensorFpga_v0.sv Line: 6
    Warning (15610): No output dependent on input pin "ad9959_sync_out" File: <workspace>/LaseRangefinder_github/fpga/DistanceSensorFpga_v0.sv Line: 72
Info (21057): Implemented 8336 device resources after synthesis - the final resource count might be different
    Info (21058): Implemented 19 input pins
    Info (21059): Implemented 61 output pins
    Info (21060): Implemented 8 bidirectional pins
    Info (21061): Implemented 7876 logic cells
    Info (21064): Implemented 361 RAM segments
    Info (21065): Implemented 1 PLLs
    Info (21062): Implemented 10 DSP elements
Info: Quartus Prime Analysis & Synthesis was successful. 0 errors, 54 warnings
    Info: Peak virtual memory: 4953 megabytes
    Info: Processing ended: Tue Nov  3 22:02:45 2026
    Info: Elapsed time: 00:00:24
    Info: Total CPU time (on all processors): 00:00:34
Info: *******************************************************************
Info: Running Quartus Prime Fitter
    Info: Version 25.1std.0 Build 1129 10/21/2025 SC Lite Edition
    Info: Processing started: Tue Nov  3 22:02:46 2026
Info: Command: quartus_fit --read_settings_files=off --write_settings_files=off DistanceSensorFpga_v0 -c DistanceSensorFpga_v0
Info: qfit2_default_script.tcl version: #1
Info: Project  = DistanceSensorFpga_v0
Info: Revision = DistanceSensorFpga_v0
Info (20032): Parallel compilation is enabled and will use up to 4 processors
Info (119006): Selected device EP4CE6E22C8 for design "DistanceSensorFpga_v0"
Info (21077): Low junction temperature is 0 degrees C
Info (21077): High junction temperature is 85 degrees C
Info (15535): Implemented PLL "phase_clock:sample_clock|altpll:pll|altpll_1ud1:auto_generated|pll1" as Cyclone IV E PLL type File: <workspace>/LaseRangefinder_github/fpga/db/altpll_1ud1.tdf Line: 31
    Info (15099): Implementing clock multiplication of 2, clock division of 5, and phase shift of 0 degrees (0 ps) for phase_clock:sample_clock|altpll:pll|altpll_1ud1:auto_generated|clk[0] port File: <workspace>/LaseRangefinder_github/fpga/db/altpll_1ud1.tdf Line: 31
    Info (15099): Implementing clock multiplication of 1, clock division of 1, and phase shift of -56 degrees (-1250 ps) for phase_clock:sample_clock|altpll:pll|altpll_1ud1:auto_generated|clk[1] port File: <workspace>/LaseRangefinder_github/fpga/db/altpll_1ud1.tdf Line: 31
Warning (18550): Found RAM instances implemented as ROM because the write logic is disabled. One instance is listed below as an example.
    Info (119043): Atom "phase_demod:demod|altsyncram:sine_rom_rtl_0|altsyncram_4qq1:auto_generated|ram_block1a0" is instantiated as RAM, but it is actually implemented as ROM function because the write logic is always disabled
Info (171003): Fitter is performing an Auto Fit compilation, which may decrease Fitter effort to reduce compilation time
Warning (292013): Feature LogicLock is only available with a valid subscription license. You can purchase a software subscription to gain full access to this feature.
Info (176444): Device migration not selected. If you intend to use device migration later, you may need to change the pin assignments as they may be incompatible with other devices
    Info (176445): Device EP4CE10E22C8 is compatible
    Info (176445): Device EP4CE15E22C8 is compatible
    Info (176445): Device EP4CE22E22C8 is compatible
Info (169124): Fitter converted 4 user pins into dedicated programming pins
    Info (169125): Pin ~ALTERA_ASDO_DATA1~ is reserved at location 6
    Info (169125): Pin ~ALTERA_FLASH_nCE_nCSO~ is reserved at location 8
    Info (169125): Pin ~ALTERA_DCLK~ is reserved at location 12
    Info (169125): Pin ~ALTERA_DATA0~ is reserved at location 13
Info (176045): Design uses memory blocks. Violating setup or hold times of memory block address registers for either read or write operations could cause memory contents to be corrupted. Make sure that all memory block address registers meet the setup and hold time requirements.
Info (332104): Reading SDC File: 'phase.sdc'
Info (332110): Deriving PLL clocks
    Info (332110): create_generated_clock -source {sample_clock|pll|auto_generated|pll1|inclk[0]} -divide_by 5 -multiply_by 2 -duty_cycle 50.00 -name {sample_clock|pll|auto_generated|pll1|clk[0]} {sample_clock|pll|auto_generated|pll1|clk[0]}
    Info (332110): create_generated_clock -source {sample_clock|pll|auto_generated|pll1|inclk[0]} -phase -56.25 -duty_cycle 50.00 -name {sample_clock|pll|auto_generated|pll1|clk[1]} {sample_clock|pll|auto_generated|pll1|clk[1]}
Info (332151): Clock uncertainty is not calculated until you update the timing netlist.
Info (332154): The derive_clock_uncertainty command did not apply clock uncertainty to any clock-to-clock transfers.
Info (332129): Detected timing requirements -- optimizing circuit to achieve only the specified requirements
Info (332111): Found 4 clocks
    Info (332111):   Period   Clock Name
    Info (332111): ======== ============
    Info (332111):   20.000      board50
    Info (332111):    8.000       dds125
    Info (332111):   20.000 sample_clock|pll|auto_generated|pll1|clk[0]
    Info (332111):    8.000 sample_clock|pll|auto_generated|pll1|clk[1]
Info (176353): Automatically promoted node ad9959_sync_clck_125Mhz~input (placed in PIN 23 (CLK1, DIFFCLK_0n)) File: <workspace>/LaseRangefinder_github/fpga/DistanceSensorFpga_v0.sv Line: 71
    Info (176355): Automatically promoted destinations to use location or clock signal Global Clock CLKCTRL_G2
Info (176353): Automatically promoted node phase_clock:sample_clock|altpll:pll|altpll_1ud1:auto_generated|clk[0] (placed in counter C0 of PLL_1) File: <workspace>/LaseRangefinder_github/fpga/db/altpll_1ud1.tdf Line: 37
    Info (176355): Automatically promoted destinations to use location or clock signal Global Clock CLKCTRL_G3
Info (176353): Automatically promoted node phase_clock:sample_clock|altpll:pll|altpll_1ud1:auto_generated|clk[1] (placed in counter C1 of PLL_1) File: <workspace>/LaseRangefinder_github/fpga/db/altpll_1ud1.tdf Line: 37
    Info (176355): Automatically promoted destinations to use location or clock signal Global Clock CLKCTRL_G4
Info (176353): Automatically promoted node Clock_50Mhz~input (placed in PIN 25 (CLK3, DIFFCLK_1n)) File: <workspace>/LaseRangefinder_github/fpga/DistanceSensorFpga_v0.sv Line: 107
    Info (176355): Automatically promoted destinations to use location or clock signal Global Clock CLKCTRL_G0
Info (176353): Automatically promoted node reset_sync:measure_reset|sync[2]  File: <workspace>/LaseRangefinder_github/fpga/phase_clock.sv Line: 30
    Info (176355): Automatically promoted destinations to use location or clock signal Global Clock
    Info (176356): Following destination nodes may be non-global or may not use global or regional clocks
        Info (176357): Destination node comb~1
Info (176353): Automatically promoted node reset_sync:processing_reset|sync[2]  File: <workspace>/LaseRangefinder_github/fpga/phase_clock.sv Line: 30
    Info (176355): Automatically promoted destinations to use location or clock signal Global Clock
Info (176353): Automatically promoted node reset_sync:digital_reset|sync[2]  File: <workspace>/LaseRangefinder_github/fpga/phase_clock.sv Line: 30
    Info (176355): Automatically promoted destinations to use location or clock signal Global Clock
Info (176353): Automatically promoted node comb~0 
    Info (176355): Automatically promoted destinations to use location or clock signal Global Clock
Info (176233): Starting register packing
Info (176235): Finished register packing
    Extra Info (176218): Packed 8 registers into blocks of type Block RAM
    Extra Info (176218): Packed 17 registers into blocks of type Embedded multiplier block
    Extra Info (176218): Packed 2 registers into blocks of type I/O Output Buffer
    Extra Info (176220): Created 2 register duplicates
Info (171121): Fitter preparation operations ending: elapsed time is 00:00:04
Info (14896): Fitter has disabled Advanced Physical Optimization because it is not supported for the current family.
Info (170189): Fitter placement preparation operations beginning
Info (170190): Fitter placement preparation operations ending: elapsed time is 00:00:03
Info (170191): Fitter placement operations beginning
Info (170137): Fitter placement was successful
Info (170192): Fitter placement operations ending: elapsed time is 00:00:11
Info (170193): Fitter routing operations beginning
Info (170195): Router estimated average interconnect usage is 25% of the available device resources
    Info (170196): Router estimated peak interconnect usage is 37% of the available device resources in the region that extends from location X11_Y0 to location X22_Y11
Info (170199): The Fitter performed an Auto Fit compilation.  Optimizations were skipped to reduce compilation time.
    Info (170201): Optimizations that may affect the design's routability were skipped
Info (170194): Fitter routing operations ending: elapsed time is 00:00:09
Info (11888): Total time spent on timing analysis during the Fitter is 6.57 seconds.
Info (334003): Started post-fitting delay annotation
Info (334004): Delay annotation completed successfully
Info (334003): Started post-fitting delay annotation
Info (334004): Delay annotation completed successfully
Info (11218): Fitter post-fit operations ending: elapsed time is 00:00:03
Warning (169177): 27 pins must meet Intel FPGA requirements for 3.3-, 3.0-, and 2.5-V interfaces. For more information, refer to AN 447: Interfacing Cyclone IV E Devices with 3.3/3.0/2.5-V LVTTL/LVCMOS I/O Systems.
    Info (169178): Pin mcu_p1 uses I/O standard 3.3-V LVCMOS at 1 File: <workspace>/LaseRangefinder_github/fpga/DistanceSensorFpga_v0.sv Line: 5
    Info (169178): Pin mcu_p2 uses I/O standard 3.3-V LVCMOS at 2 File: <workspace>/LaseRangefinder_github/fpga/DistanceSensorFpga_v0.sv Line: 6
    Info (169178): Pin ad9959_sync_out uses I/O standard 3.3-V LVTTL at 24 File: <workspace>/LaseRangefinder_github/fpga/DistanceSensorFpga_v0.sv Line: 72
    Info (169178): Pin K6R4008V1D_io01 uses I/O standard 3.3-V LVCMOS at 100 File: <workspace>/LaseRangefinder_github/fpga/DistanceSensorFpga_v0.sv Line: 97
    Info (169178): Pin K6R4008V1D_io02 uses I/O standard 3.3-V LVCMOS at 101 File: <workspace>/LaseRangefinder_github/fpga/DistanceSensorFpga_v0.sv Line: 98
    Info (169178): Pin K6R4008V1D_io03 uses I/O standard 3.3-V LVCMOS at 103 File: <workspace>/LaseRangefinder_github/fpga/DistanceSensorFpga_v0.sv Line: 99
    Info (169178): Pin K6R4008V1D_io04 uses I/O standard 3.3-V LVCMOS at 104 File: <workspace>/LaseRangefinder_github/fpga/DistanceSensorFpga_v0.sv Line: 100
    Info (169178): Pin K6R4008V1D_io05 uses I/O standard 3.3-V LVCMOS at 128 File: <workspace>/LaseRangefinder_github/fpga/DistanceSensorFpga_v0.sv Line: 101
    Info (169178): Pin K6R4008V1D_io06 uses I/O standard 3.3-V LVCMOS at 127 File: <workspace>/LaseRangefinder_github/fpga/DistanceSensorFpga_v0.sv Line: 102
    Info (169178): Pin K6R4008V1D_io07 uses I/O standard 3.3-V LVCMOS at 126 File: <workspace>/LaseRangefinder_github/fpga/DistanceSensorFpga_v0.sv Line: 103
    Info (169178): Pin K6R4008V1D_io08 uses I/O standard 3.3-V LVCMOS at 125 File: <workspace>/LaseRangefinder_github/fpga/DistanceSensorFpga_v0.sv Line: 104
    Info (169178): Pin Clock_50Mhz uses I/O standard 3.3-V LVCMOS at 25 File: <workspace>/LaseRangefinder_github/fpga/DistanceSensorFpga_v0.sv Line: 107
    Info (169178): Pin ad9959_sync_clck_125Mhz uses I/O standard 3.3-V LVCMOS at 23 File: <workspace>/LaseRangefinder_github/fpga/DistanceSensorFpga_v0.sv Line: 71
    Info (169178): Pin max6316_reset uses I/O standard 3.3-V LVCMOS at 74 File: <workspace>/LaseRangefinder_github/fpga/DistanceSensorFpga_v0.sv Line: 56
    Info (169178): Pin mcu_rx uses I/O standard 3.3-V LVCMOS at 3 File: <workspace>/LaseRangefinder_github/fpga/DistanceSensorFpga_v0.sv Line: 7
    Info (169178): Pin sygnal1 uses I/O standard 3.3-V LVCMOS at 91 File: <workspace>/LaseRangefinder_github/fpga/DistanceSensorFpga_v0.sv Line: 110
    Info (169178): Pin sygnal2 uses I/O standard 3.3-V LVCMOS at 90 File: <workspace>/LaseRangefinder_github/fpga/DistanceSensorFpga_v0.sv Line: 111
    Info (169178): Pin sygnal3 uses I/O standard 3.3-V LVCMOS at 89 File: <workspace>/LaseRangefinder_github/fpga/DistanceSensorFpga_v0.sv Line: 112
    Info (169178): Pin sygnal4 uses I/O standard 3.3-V LVCMOS at 88 File: <workspace>/LaseRangefinder_github/fpga/DistanceSensorFpga_v0.sv Line: 115
    Info (169178): Pin adc4_sdo_0 uses I/O standard 3.3-V LVCMOS at 52 File: <workspace>/LaseRangefinder_github/fpga/DistanceSensorFpga_v0.sv Line: 34
    Info (169178): Pin adc3_sdo_0 uses I/O standard 3.3-V LVCMOS at 58 File: <workspace>/LaseRangefinder_github/fpga/DistanceSensorFpga_v0.sv Line: 39
    Info (169178): Pin adc2_sdo_0 uses I/O standard 3.3-V LVCMOS at 65 File: <workspace>/LaseRangefinder_github/fpga/DistanceSensorFpga_v0.sv Line: 44
    Info (169178): Pin adc1_sdo_0 uses I/O standard 3.3-V LVCMOS at 69 File: <workspace>/LaseRangefinder_github/fpga/DistanceSensorFpga_v0.sv Line: 49
    Info (169178): Pin adc8_sdo_0 uses I/O standard 3.3-V LVCMOS at 11 File: <workspace>/LaseRangefinder_github/fpga/DistanceSensorFpga_v0.sv Line: 14
    Info (169178): Pin adc6_sdo_0 uses I/O standard 3.3-V LVCMOS at 39 File: <workspace>/LaseRangefinder_github/fpga/DistanceSensorFpga_v0.sv Line: 24
    Info (169178): Pin adc7_sdo_0 uses I/O standard 3.3-V LVCMOS at 32 File: <workspace>/LaseRangefinder_github/fpga/DistanceSensorFpga_v0.sv Line: 19
    Info (169178): Pin adc5_sdo_0 uses I/O standard 3.3-V LVCMOS at 46 File: <workspace>/LaseRangefinder_github/fpga/DistanceSensorFpga_v0.sv Line: 29
Warning (169064): Following 8 pins have no output enable or a GND or VCC output enable - later changes to this connectivity may change fitting results
    Info (169065): Pin K6R4008V1D_io01 has a permanently disabled output enable File: <workspace>/LaseRangefinder_github/fpga/DistanceSensorFpga_v0.sv Line: 97
    Info (169065): Pin K6R4008V1D_io02 has a permanently disabled output enable File: <workspace>/LaseRangefinder_github/fpga/DistanceSensorFpga_v0.sv Line: 98
    Info (169065): Pin K6R4008V1D_io03 has a permanently disabled output enable File: <workspace>/LaseRangefinder_github/fpga/DistanceSensorFpga_v0.sv Line: 99
    Info (169065): Pin K6R4008V1D_io04 has a permanently disabled output enable File: <workspace>/LaseRangefinder_github/fpga/DistanceSensorFpga_v0.sv Line: 100
    Info (169065): Pin K6R4008V1D_io05 has a permanently disabled output enable File: <workspace>/LaseRangefinder_github/fpga/DistanceSensorFpga_v0.sv Line: 101
    Info (169065): Pin K6R4008V1D_io06 has a permanently disabled output enable File: <workspace>/LaseRangefinder_github/fpga/DistanceSensorFpga_v0.sv Line: 102
    Info (169065): Pin K6R4008V1D_io07 has a permanently disabled output enable File: <workspace>/LaseRangefinder_github/fpga/DistanceSensorFpga_v0.sv Line: 103
    Info (169065): Pin K6R4008V1D_io08 has a permanently disabled output enable File: <workspace>/LaseRangefinder_github/fpga/DistanceSensorFpga_v0.sv Line: 104
Info (144001): Generated suppressed messages file <workspace>/LaseRangefinder_github/fpga/output_files/DistanceSensorFpga_v0.fit.smsg
Info: Quartus Prime Fitter was successful. 0 errors, 4 warnings
    Info: Peak virtual memory: 5700 megabytes
    Info: Processing ended: Tue Nov  3 22:03:20 2026
    Info: Elapsed time: 00:00:34
    Info: Total CPU time (on all processors): 00:00:57
Info: *******************************************************************
Info: Running Quartus Prime Assembler
    Info: Version 25.1std.0 Build 1129 10/21/2025 SC Lite Edition
    Info: Processing started: Tue Nov  3 22:03:21 2026
Info: Command: quartus_asm --read_settings_files=off --write_settings_files=off DistanceSensorFpga_v0 -c DistanceSensorFpga_v0
Info (115031): Writing out detailed assembly data for power analysis
Info (115030): Assembler is generating device programming files
Info: Quartus Prime Assembler was successful. 0 errors, 0 warnings
    Info: Peak virtual memory: 4752 megabytes
    Info: Processing ended: Tue Nov  3 22:03:22 2026
    Info: Elapsed time: 00:00:01
    Info: Total CPU time (on all processors): 00:00:01
Info (293026): Skipped module Power Analyzer due to the assignment FLOW_ENABLE_POWER_ANALYZER
Info: *******************************************************************
Info: Running Quartus Prime Timing Analyzer
    Info: Version 25.1std.0 Build 1129 10/21/2025 SC Lite Edition
    Info: Processing started: Tue Nov  3 22:03:23 2026
Info: Command: quartus_sta DistanceSensorFpga_v0 -c DistanceSensorFpga_v0
Info: qsta_default_script.tcl version: #1
Info (20032): Parallel compilation is enabled and will use up to 4 processors
Info (21077): Low junction temperature is 0 degrees C
Info (21077): High junction temperature is 85 degrees C
Info (332104): Reading SDC File: 'phase.sdc'
Info (332110): Deriving PLL clocks
    Info (332110): create_generated_clock -source {sample_clock|pll|auto_generated|pll1|inclk[0]} -divide_by 5 -multiply_by 2 -duty_cycle 50.00 -name {sample_clock|pll|auto_generated|pll1|clk[0]} {sample_clock|pll|auto_generated|pll1|clk[0]}
    Info (332110): create_generated_clock -source {sample_clock|pll|auto_generated|pll1|inclk[0]} -phase -56.25 -duty_cycle 50.00 -name {sample_clock|pll|auto_generated|pll1|clk[1]} {sample_clock|pll|auto_generated|pll1|clk[1]}
Info (332151): Clock uncertainty is not calculated until you update the timing netlist.
Info (332123): Deriving Clock Uncertainty. Please refer to report_sdc in the Timing Analyzer to see clock uncertainties.
Info: Found TIMING_ANALYZER_REPORT_SCRIPT_INCLUDE_DEFAULT_ANALYSIS = ON
Info: Analyzing Slow 1200mV 85C Model
Info (332146): Worst-case setup slack is 0.294
    Info (332119):     Slack       End Point TNS Clock 
    Info (332119): ========= =================== =====================
    Info (332119):     0.294               0.000 dds125 
    Info (332119):     1.202               0.000 n/a 
    Info (332119):     2.290               0.000 sample_clock|pll|auto_generated|pll1|clk[0] 
    Info (332119):     3.149               0.000 sample_clock|pll|auto_generated|pll1|clk[1] 
    Info (332119):     8.993               0.000 board50 
Info (332146): Worst-case hold slack is 0.399
    Info (332119):     Slack       End Point TNS Clock 
    Info (332119): ========= =================== =====================
    Info (332119):     0.399               0.000 dds125 
    Info (332119):     0.405               0.000 sample_clock|pll|auto_generated|pll1|clk[0] 
    Info (332119):     0.453               0.000 board50 
    Info (332119):     0.454               0.000 sample_clock|pll|auto_generated|pll1|clk[1] 
    Info (332119):     3.841               0.000 n/a 
Info (332146): Worst-case recovery slack is 0.266
    Info (332119):     Slack       End Point TNS Clock 
    Info (332119): ========= =================== =====================
    Info (332119):     0.266               0.000 dds125 
    Info (332119):     4.664               0.000 sample_clock|pll|auto_generated|pll1|clk[1] 
    Info (332119):    13.822               0.000 board50 
    Info (332119):    14.089               0.000 sample_clock|pll|auto_generated|pll1|clk[0] 
Info (332146): Worst-case removal slack is 1.100
    Info (332119):     Slack       End Point TNS Clock 
    Info (332119): ========= =================== =====================
    Info (332119):     1.100               0.000 board50 
    Info (332119):     2.233               0.000 dds125 
    Info (332119):     2.308               0.000 sample_clock|pll|auto_generated|pll1|clk[1] 
    Info (332119):     3.011               0.000 sample_clock|pll|auto_generated|pll1|clk[0] 
Info (332146): Worst-case minimum pulse width slack is 3.595
    Info (332119):     Slack       End Point TNS Clock 
    Info (332119): ========= =================== =====================
    Info (332119):     3.595               0.000 dds125 
    Info (332119):     3.719               0.000 sample_clock|pll|auto_generated|pll1|clk[1] 
    Info (332119):     9.531               0.000 sample_clock|pll|auto_generated|pll1|clk[0] 
    Info (332119):     9.724               0.000 board50 
Info (332114): Report Metastability: Found 19 synchronizer chains.
    Info (332114): Typical MTBF of Design is 1e+09 years or 3.15e+16 seconds.

    Info (332114): Number of Synchronizer Chains Found: 19
    Info (332114): Shortest Synchronizer Chain: 2 Registers
    Info (332114): Fraction of Chains for which MTBFs Could Not be Calculated: 0.053
    Info (332114): Worst Case Available Settling Time: 10.525 ns
    Info (332114): Typical MTBF values are calculated based on the nominal silicon characteristics, at nominal operating conditions.
    Info (332114):   - Under typical conditions, an increase of 100ps in available settling time will increase MTBF values by a factor of 10.8
Info: Analyzing Slow 1200mV 0C Model
Info (334003): Started post-fitting delay annotation
Info (334004): Delay annotation completed successfully
Info (332123): Deriving Clock Uncertainty. Please refer to report_sdc in the Timing Analyzer to see clock uncertainties.
Info (332146): Worst-case setup slack is 0.593
    Info (332119):     Slack       End Point TNS Clock 
    Info (332119): ========= =================== =====================
    Info (332119):     0.593               0.000 dds125 
    Info (332119):     2.293               0.000 n/a 
    Info (332119):     3.447               0.000 sample_clock|pll|auto_generated|pll1|clk[1] 
    Info (332119):     3.800               0.000 sample_clock|pll|auto_generated|pll1|clk[0] 
    Info (332119):     9.368               0.000 board50 
Info (332146): Worst-case hold slack is 0.381
    Info (332119):     Slack       End Point TNS Clock 
    Info (332119): ========= =================== =====================
    Info (332119):     0.381               0.000 dds125 
    Info (332119):     0.388               0.000 sample_clock|pll|auto_generated|pll1|clk[0] 
    Info (332119):     0.401               0.000 board50 
    Info (332119):     0.402               0.000 sample_clock|pll|auto_generated|pll1|clk[1] 
    Info (332119):     3.518               0.000 n/a 
Info (332146): Worst-case recovery slack is 0.253
    Info (332119):     Slack       End Point TNS Clock 
    Info (332119): ========= =================== =====================
    Info (332119):     0.253               0.000 dds125 
    Info (332119):     4.842               0.000 sample_clock|pll|auto_generated|pll1|clk[1] 
    Info (332119):    14.112               0.000 board50 
    Info (332119):    14.379               0.000 sample_clock|pll|auto_generated|pll1|clk[0] 
Info (332146): Worst-case removal slack is 0.951
    Info (332119):     Slack       End Point TNS Clock 
    Info (332119): ========= =================== =====================
    Info (332119):     0.951               0.000 board50 
    Info (332119):     2.076               0.000 dds125 
    Info (332119):     2.096               0.000 sample_clock|pll|auto_generated|pll1|clk[1] 
    Info (332119):     2.684               0.000 sample_clock|pll|auto_generated|pll1|clk[0] 
Info (332146): Worst-case minimum pulse width slack is 3.594
    Info (332119):     Slack       End Point TNS Clock 
    Info (332119): ========= =================== =====================
    Info (332119):     3.594               0.000 dds125 
    Info (332119):     3.718               0.000 sample_clock|pll|auto_generated|pll1|clk[1] 
    Info (332119):     9.551               0.000 sample_clock|pll|auto_generated|pll1|clk[0] 
    Info (332119):     9.738               0.000 board50 
Info (332114): Report Metastability: Found 19 synchronizer chains.
    Info (332114): Typical MTBF of Design is 1e+09 years or 3.15e+16 seconds.

    Info (332114): Number of Synchronizer Chains Found: 19
    Info (332114): Shortest Synchronizer Chain: 2 Registers
    Info (332114): Fraction of Chains for which MTBFs Could Not be Calculated: 0.053
    Info (332114): Worst Case Available Settling Time: 10.902 ns
    Info (332114): Typical MTBF values are calculated based on the nominal silicon characteristics, at nominal operating conditions.
    Info (332114):   - Under typical conditions, an increase of 100ps in available settling time will increase MTBF values by a factor of 10.8
Info: Analyzing Fast 1200mV 0C Model
Info (332123): Deriving Clock Uncertainty. Please refer to report_sdc in the Timing Analyzer to see clock uncertainties.
Info (332146): Worst-case setup slack is 2.180
    Info (332119):     Slack       End Point TNS Clock 
    Info (332119): ========= =================== =====================
    Info (332119):     2.180               0.000 dds125 
    Info (332119):     5.105               0.000 n/a 
    Info (332119):     5.868               0.000 sample_clock|pll|auto_generated|pll1|clk[1] 
    Info (332119):    12.402               0.000 sample_clock|pll|auto_generated|pll1|clk[0] 
    Info (332119):    14.895               0.000 board50 
Info (332146): Worst-case hold slack is 0.137
    Info (332119):     Slack       End Point TNS Clock 
    Info (332119): ========= =================== =====================
    Info (332119):     0.137               0.000 dds125 
    Info (332119):     0.137               0.000 sample_clock|pll|auto_generated|pll1|clk[0] 
    Info (332119):     0.186               0.000 board50 
    Info (332119):     0.187               0.000 sample_clock|pll|auto_generated|pll1|clk[1] 
    Info (332119):     1.759               0.000 n/a 
Info (332146): Worst-case recovery slack is 2.349
    Info (332119):     Slack       End Point TNS Clock 
    Info (332119): ========= =================== =====================
    Info (332119):     2.349               0.000 dds125 
    Info (332119):     6.448               0.000 sample_clock|pll|auto_generated|pll1|clk[1] 
    Info (332119):    17.050               0.000 board50 
    Info (332119):    17.288               0.000 sample_clock|pll|auto_generated|pll1|clk[0] 
Info (332146): Worst-case removal slack is 0.461
    Info (332119):     Slack       End Point TNS Clock 
    Info (332119): ========= =================== =====================
    Info (332119):     0.461               0.000 board50 
    Info (332119):     0.820               0.000 dds125 
    Info (332119):     0.968               0.000 sample_clock|pll|auto_generated|pll1|clk[1] 
    Info (332119):     1.365               0.000 sample_clock|pll|auto_generated|pll1|clk[0] 
Info (332146): Worst-case minimum pulse width slack is 3.198
    Info (332119):     Slack       End Point TNS Clock 
    Info (332119): ========= =================== =====================
    Info (332119):     3.198               0.000 dds125 
    Info (332119):     3.796               0.000 sample_clock|pll|auto_generated|pll1|clk[1] 
    Info (332119):     9.239               0.000 board50 
    Info (332119):     9.732               0.000 sample_clock|pll|auto_generated|pll1|clk[0] 
Info (332114): Report Metastability: Found 19 synchronizer chains.
    Info (332114): Typical MTBF of Design is 1e+09 years or 3.15e+16 seconds.

    Info (332114): Number of Synchronizer Chains Found: 19
    Info (332114): Shortest Synchronizer Chain: 2 Registers
    Info (332114): Fraction of Chains for which MTBFs Could Not be Calculated: 0.053
    Info (332114): Worst Case Available Settling Time: 13.379 ns
    Info (332114): Typical MTBF values are calculated based on the nominal silicon characteristics, at nominal operating conditions.
    Info (332114):   - Under typical conditions, an increase of 100ps in available settling time will increase MTBF values by a factor of 10.8
Info (332101): Design is fully constrained for setup requirements
Info (332101): Design is fully constrained for hold requirements
Info: Quartus Prime Timing Analyzer was successful. 0 errors, 0 warnings
    Info: Peak virtual memory: 4916 megabytes
    Info: Processing ended: Tue Nov  3 22:03:28 2026
    Info: Elapsed time: 00:00:05
    Info: Total CPU time (on all processors): 00:00:06
Info (293000): Quartus Prime Full Compilation was successful. 0 errors, 58 warnings
Info (23030): Evaluation of Tcl script <Quartus>/common/tcl/internal/qsh_flow.tcl was successful
Info: Quartus Prime Shell was successful. 0 errors, 58 warnings
    Info: Peak virtual memory: 4705 megabytes
    Info: Processing ended: Tue Nov  3 22:03:29 2026
    Info: Elapsed time: 00:01:09
    Info: Total CPU time (on all processors): 00:00:01
TBBmalloc: skip allocation functions replacement in ucrtbase.dll: unknown prologue for function _msize
Info: *******************************************************************
Info: Running Quartus Prime Timing Analyzer
    Info: Version 25.1std.0 Build 1129 10/21/2025 SC Lite Edition
    Info: Copyright (C) 2025  Altera Corporation. All rights reserved.
    Info: Your use of Altera Corporation's design tools, logic functions 
    Info: and other software and tools, and any partner logic 
    Info: functions, and any output files from any of the foregoing 
    Info: (including device programming or simulation files), and any 
    Info: associated documentation or information are expressly subject 
    Info: to the terms and conditions of the Altera Program License 
    Info: Subscription Agreement, the Altera Quartus Prime License Agreement,
    Info: the Altera IP License Agreement, or other applicable license
    Info: agreement, including, without limitation, that your use is for
    Info: the sole purpose of programming logic devices manufactured by
    Info: Altera and sold by Altera or its authorized distributors.  Please
    Info: refer to the Altera Software License Subscription Agreements 
    Info: on the Quartus Prime software download page.
    Info: Processing started: Tue Nov  3 22:03:29 2026
Info: Command: quartus_sta -t tools/report_config_timing.tcl
Info (20032): Parallel compilation is enabled and will use up to 4 processors
Info (21077): Low junction temperature is 0 degrees C
Info (21077): High junction temperature is 85 degrees C
Info (332104): Reading SDC File: 'phase.sdc'
Info (332110): Deriving PLL clocks
    Info (332110): create_generated_clock -source {sample_clock|pll|auto_generated|pll1|inclk[0]} -divide_by 5 -multiply_by 2 -duty_cycle 50.00 -name {sample_clock|pll|auto_generated|pll1|clk[0]} {sample_clock|pll|auto_generated|pll1|clk[0]}
    Info (332110): create_generated_clock -source {sample_clock|pll|auto_generated|pll1|inclk[0]} -phase -56.25 -duty_cycle 50.00 -name {sample_clock|pll|auto_generated|pll1|clk[1]} {sample_clock|pll|auto_generated|pll1|clk[1]}
Info (332151): Clock uncertainty is not calculated until you update the timing netlist.
Info (332123): Deriving Clock Uncertainty. Please refer to report_sdc in the Timing Analyzer to see clock uncertainties.
Info (332115): Report Timing: Found 12 setup paths (0 violated).  Worst case slack is 0.294
    Info (332115): -setup
    Info (332115): -npaths 12
    Info (332115): -detail full_path
    Info (332115): -file {test-results/config-setup-paths.rpt}
Info (332115): Report Timing: Found 12 hold paths (0 violated).  Worst case slack is 0.399
    Info (332115): -hold
    Info (332115): -npaths 12
    Info (332115): -detail full_path
    Info (332115): -file {test-results/config-hold-paths.rpt}
Info (332115): Report Timing: Found 1 setup paths (0 violated).  Worst case slack is 0.294
    Info (332115): -to [get_ports {ad9959_io_upd}]
    Info (332115): -setup
    Info (332115): -npaths 4
    Info (332115): -detail full_path
    Info (332115): -file {test-results/config-update-setup.rpt}
Info (332115): Report Timing: Found 1 hold paths (0 violated).  Worst case slack is 1.786
    Info (332115): -to [get_ports {ad9959_io_upd}]
    Info (332115): -hold
    Info (332115): -npaths 4
    Info (332115): -detail full_path
    Info (332115): -file {test-results/config-update-hold.rpt}
Info (332101): Design is fully constrained for setup requirements
Info (332101): Design is fully constrained for hold requirements
Info (23030): Evaluation of Tcl script tools/report_config_timing.tcl was successful
Info: Quartus Prime Timing Analyzer was successful. 0 errors, 0 warnings
    Info: Peak virtual memory: 4819 megabytes
    Info: Processing ended: Tue Nov  3 22:03:30 2026
    Info: Elapsed time: 00:00:01
    Info: Total CPU time (on all processors): 00:00:01
Build complete. Inspect output_files/*.sta.summary and test-results/config-unconstrained.rpt.
No hardware was programmed.
