neuroandriyanov/LaserRangefinder/measurements/2026-11-03/Осциллограммы/README.en.md

# Oscilloscope captures by distance

[Русский](README.md) | English

Captions are outside the native image. The PNG files preserve the original pixels; each SVG contains a caption and an embedded PNG.

## Point 01 — 762 mm

CH1 + CH3, 762 mm

[Native PNG](point-01_00762.0mm_ch1-ch3.png)

CH2 + CH4, 762 mm

[Native PNG](point-01_00762.0mm_ch2-ch4.png)

## Point 02 — 1091 mm

CH1 + CH3, 1091 mm

[Native PNG](point-02_01091.0mm_ch1-ch3.png)

CH2 + CH4, 1091 mm

[Native PNG](point-02_01091.0mm_ch2-ch4.png)

## Point 03 — 1480 mm

CH1 + CH3, 1480 mm

[Native PNG](point-03_01480.0mm_ch1-ch3.png)

CH2 + CH4, 1480 mm

[Native PNG](point-03_01480.0mm_ch2-ch4.png)

## Point 04 — 1958 mm

CH1 + CH3, 1958 mm

[Native PNG](point-04_01958.0mm_ch1-ch3.png)

CH2 + CH4, 1958 mm

[Native PNG](point-04_01958.0mm_ch2-ch4.png)

## Point 05 — 2398 mm

CH1 + CH3, 2398 mm

[Native PNG](point-05_02398.0mm_ch1-ch3.png)

CH2 + CH4, 2398 mm

[Native PNG](point-05_02398.0mm_ch2-ch4.png)

## Point 06 — 2876 mm

CH1 + CH3, 2876 mm

[Native PNG](point-06_02876.0mm_ch1-ch3.png)

CH2 + CH4, 2876 mm

[Native PNG](point-06_02876.0mm_ch2-ch4.png)

## Point 07 — 3425 mm

CH1 + CH3, 3425 mm

[Native PNG](point-07_03425.0mm_ch1-ch3.png)

CH2 + CH4, 3425 mm

[Native PNG](point-07_03425.0mm_ch2-ch4.png)

## Point 08 — 4198 mm

CH1 + CH3, 4198 mm

[Native PNG](point-08_04198.0mm_ch1-ch3.png)

CH2 + CH4, 4198 mm

[Native PNG](point-08_04198.0mm_ch2-ch4.png)

## Point 09 — 4814 mm

CH1 + CH3, 4814 mm

[Native PNG](point-09_04814.0mm_ch1-ch3.png)

CH2 + CH4, 4814 mm

[Native PNG](point-09_04814.0mm_ch2-ch4.png)

## Point 10 — 5635 mm

CH1 + CH3, 5635 mm

[Native PNG](point-10_05635.0mm_ch1-ch3.png)

CH2 + CH4, 5635 mm

[Native PNG](point-10_05635.0mm_ch2-ch4.png)
