neuroandriyanov/LaserRangefinder/measurements/2026-11-03/README.md

# Стендовая серия 3 ноября 2026 года

10 неподвижных положений, **762–5635 мм**, 20 снимков экрана осциллографа.
Серия снята 20:53–21:13 Samara (UTC+4). Перемещение мишени выполнял владелец
после команды, остановку подтверждал. Завершение — достигнут предел помещения.

[Excel с формулами](Стендовые%20измерения.xlsx) содержит расстояние Vector60,
аналоговые и цифровые фазы FPGA, вычисленные расстояния и ошибки, амплитуды,
напряжения детекторов, частоты, СКО фаз, диагностику и имена снимков.
Лист «Расчёт» показывает коэффициенты cal2 и промежуточные вычисления.
[Все осциллограммы](Осциллограммы/README.md) подписаны расстоянием.

## Результаты

Ошибка = вычисленное расстояние − показание рулетки, мм. Модель cal2
зафиксирована **до** серии и по этим точкам не подгонялась.
Дальность вычислена на ПК/в Excel по фазам FPGA, а не внутри FPGA.

| Точка | Рулетка, мм | АЦП, мм | Цифровой, мм | Ошибка АЦП, мм | Ошибка цифровая, мм | Снимки |
|---:|---:|---:|---:|---:|---:|---|
| 1 | 762 | 763.8 | 763.1 | 1.8 | 1.1 | [ВЧ](Осциллограммы/point-01_00762.0mm_ch1-ch3.svg) · [НЧ](Осциллограммы/point-01_00762.0mm_ch2-ch4.svg) |
| 2 | 1091 | 1106.2 | 1105.5 | 15.2 | 14.5 | [ВЧ](Осциллограммы/point-02_01091.0mm_ch1-ch3.svg) · [НЧ](Осциллограммы/point-02_01091.0mm_ch2-ch4.svg) |
| 3 | 1480 | 1492.2 | 1491.8 | 12.2 | 11.8 | [ВЧ](Осциллограммы/point-03_01480.0mm_ch1-ch3.svg) · [НЧ](Осциллограммы/point-03_01480.0mm_ch2-ch4.svg) |
| 4 | 1958 | 1967.4 | 1967.2 | 9.4 | 9.2 | [ВЧ](Осциллограммы/point-04_01958.0mm_ch1-ch3.svg) · [НЧ](Осциллограммы/point-04_01958.0mm_ch2-ch4.svg) |
| 5 | 2398 | 2421.0 | 2420.8 | 23.0 | 22.8 | [ВЧ](Осциллограммы/point-05_02398.0mm_ch1-ch3.svg) · [НЧ](Осциллограммы/point-05_02398.0mm_ch2-ch4.svg) |
| 6 | 2876 | 2891.1 | 2891.2 | 15.1 | 15.2 | [ВЧ](Осциллограммы/point-06_02876.0mm_ch1-ch3.svg) · [НЧ](Осциллограммы/point-06_02876.0mm_ch2-ch4.svg) |
| 7 | 3425 | 3416.5 | 3416.5 | -8.5 | -8.5 | [ВЧ](Осциллограммы/point-07_03425.0mm_ch1-ch3.svg) · [НЧ](Осциллограммы/point-07_03425.0mm_ch2-ch4.svg) |
| 8 | 4198 | 4181.3 | 4181.5 | -16.7 | -16.5 | [ВЧ](Осциллограммы/point-08_04198.0mm_ch1-ch3.svg) · [НЧ](Осциллограммы/point-08_04198.0mm_ch2-ch4.svg) |
| 9 | 4814 | 4808.3 | 4808.8 | -5.7 | -5.2 | [ВЧ](Осциллограммы/point-09_04814.0mm_ch1-ch3.svg) · [НЧ](Осциллограммы/point-09_04814.0mm_ch2-ch4.svg) |
| 10 | 5635 | н/д | н/д | н/д | н/д | [ВЧ](Осциллограммы/point-10_05635.0mm_ch1-ch3.svg) · [НЧ](Осциллограммы/point-10_05635.0mm_ch2-ch4.svg) |

Для девяти точек в области cal2:

| Показатель | АЦП | Цифровой |
|---|---:|---:|
| Среднее расхождение, мм | 5.08 | 4.93 |
| RMS расхождения, мм | 13.36 | 13.16 |
| Максимум модуля расхождения, мм | 22.96 | 22.81 |

Это расхождение с Vector60 на данном стенде после усреднения, не подтверждение
абсолютной точности или динамической погрешности дальномера.
5635 мм находятся вне области cal2 (638–5583 мм); экстраполяция не выполняется.
В этой точке также зарегистрирован запоминаемый цифровой флаг переполнения
`diagnostics=4`. Текущие analog/digital valid были установлены. Причина события
не установлена; FPGA не сбрасывалась, флаг сохранён в данных и таблице.

## Стенд и настройки

FPGA управляет AD9959, оцифровывает четыре синусоидальных сигнала после SA612
и четыре выхода детекторов ADS8681, измеряет также фазы цифровых сигналов
после компараторов. Опорный PIN-фотодиод получает свет по оптоволокну от
излучателя; второй — отражение от мишени на штативе.

| RIGOL DS1104Z | Разъём | Назначение |
|---|---|---|
| CH1 | X9 | Опорный ВЧ |
| CH2 | X10 | Опорный НЧ |
| CH3 | X11 | Отражённый ВЧ |
| CH4 | X12 | Отражённый НЧ |

Фаза — отражённый минус опорный: CH3−CH1 и CH4−CH2.
Vector60 измеряет расстояние до той же неподвижной мишени по Bluetooth.
COM9: 115200, 8N1, UART v3 с CRC, один незавершённый запрос.
Целевой интервал опроса 20 мс; фактический интервал сохранён в первичных данных.
FPGA: 125 МГц, АЦП 250 квыб/с, аналоговое окно 1000 отсчётов (4 мс),
цифровое накопление 16 периодов. Детекторы должны иметь |U| ≥0,5 В на АЦП5–8.

| DDS | FTW | Частота, Гц | ASF | POW |
|---|---:|---:|---:|---:|
| CH0 | 12845056 | 1495361,328125 | 200 | 0 |
| CH1 | 635888254 | 74027135,735378 | 1000 | 0 |
| CH2 | 12879416 | 1499361,358583 | 1000 | 0 |
| CH3 | 635830272 | 74020385,742188 | 450 | 0 |

ПЧ ВЧ **6749,993190 Гц**, ПЧ НЧ **4000,030458 Гц**.
Банк прочитан перед каждой точкой и совпал с банком cal2, generation=0.
DDS и прошивка во время серии не изменялись.
POF SHA256: `7e652373ae74ca5d1734248706c16cae9fdaf9ef25b28a321869271220e0212d`.

## Отбор и обработка

После остановки выдержка 3 с, затем ≥15 с и ≥6 ответов рулетки, после двух
снимков — ещё один контроль расстояния. Допустимый разброс Vector60 ≤3 мм,
достоверных свежих UART-пакетов ≥98%, CRC и тайм-аутов UART нет.
Паузы чтения >200 мс исключают попытку; первые точки проверены по тому же
правилу после записи. В принятых точках все выбранные пакеты valid/fresh.
Фазы усредняются по окружности, амплитуды и детекторы арифметически.
Приборы имеют независимые часы: сопоставляются неподвижные интервалы,
без заявления синхронности рулетки, снимка и FPGA.

Неудачные попытки сохранены: USB-тайм-аут снимка точки 2; BLE-обрывы
подключения точек 3 и 8; пауза UART 0,403 с в первой попытке точки 10;
повторная попытка точки 10 отклонена строгим правилом diagnostics=0.
После проверки HDL выяснено, что bit2 запоминает прошедшее событие до сброса.
Третья попытка точки 10 сохранена отдельно с явной отметкой `sticky_digital_overflow`,
без ослабления проверки остальных диагностических битов и без подмены исходных
неудачных интервалов. Выбор точек не зависел от ошибки относительно модели.

НЧ-фаза выбирает целое число оборотов ВЧ; полином 4-й степени вычисляет
дальность по развёрнутой ВЧ-фазе. Проверяются запас ветви ≥90° и диапазон x.
Коэффициенты: [calibration.json](calibration.json), ID `6c959d57db56d0397e0618d8026c43604e38874606a59c39262eb9daf9059de6`.
В публикационной копии нормализован только путь источника, численные
коэффициенты и ID прежние; точный исходный файл сохранён в первичном сеансе.

## Снимки и проверка

PNG — нативный экран 800×480. Исправлены только известные ошибочные CRC
служебных tEXt-чанков RIGOL; пиксельные данные не изменены. SVG добавляет
внешнюю подпись расстояния и пары каналов, исходный PNG встроен целиком.
Штатный частотомер на экране показывал нестабильные/невалидные значения;
его индикация **не используется** как измерение ПЧ. ПЧ в подписи рассчитаны
из прочитанного DDS-банка. Вольт/деление адаптированы к амплитуде каждой пары.
После съёмки восстановлены исходные масштабы, смещения и все четыре луча,
осциллограф оставлен в RUN, 50 мкс/деление. COM9 и BLE освобождены.

Все 20 изображений визуально просмотрены. Повторно разобраны 15001 бинарный
UART-пакет принятых попыток, каждое поле совпало с JSON, CRC-ошибок нет.
Формулы Excel сверены с desktop_app/distance.py, проверено изменение фазы,
возврат исходного значения и повторный импорт сохранённого XLSX.
В файле сохранены формулы, кешированные значения, фильтры, закрепление строк
и первого столбца, редактируемый точечный график с девятью парами точек.
Microsoft Excel для этой проверки не запускался.

Первичный сеанс: `captures/bench/20261103T165315Z-paired-scope/` (локально, вне публикационного
набора). Структурированные средние: [measurements.json](measurements.json),
метаданные точек: `Данные/`, соответствие снимков: [photo-index.json](photo-index.json).
SHA256 компактных файлов и первичных источников: [manifest.json](manifest.json).
Локальная подготовка не означает публикацию репозитория или push.
