neuroandriyanov/LaserRangefinder/measurements/2026-11-03/Осциллограммы/README.md

# Осциллограммы по расстояниям

Подписи находятся вне нативного изображения. PNG сохраняют исходные пиксели; SVG содержит подпись и встроенный PNG.

## Точка 01 — 762 мм

CH1 + CH3, 762 мм

[Нативный PNG](point-01_00762.0mm_ch1-ch3.png)

CH2 + CH4, 762 мм

[Нативный PNG](point-01_00762.0mm_ch2-ch4.png)

## Точка 02 — 1091 мм

CH1 + CH3, 1091 мм

[Нативный PNG](point-02_01091.0mm_ch1-ch3.png)

CH2 + CH4, 1091 мм

[Нативный PNG](point-02_01091.0mm_ch2-ch4.png)

## Точка 03 — 1480 мм

CH1 + CH3, 1480 мм

[Нативный PNG](point-03_01480.0mm_ch1-ch3.png)

CH2 + CH4, 1480 мм

[Нативный PNG](point-03_01480.0mm_ch2-ch4.png)

## Точка 04 — 1958 мм

CH1 + CH3, 1958 мм

[Нативный PNG](point-04_01958.0mm_ch1-ch3.png)

CH2 + CH4, 1958 мм

[Нативный PNG](point-04_01958.0mm_ch2-ch4.png)

## Точка 05 — 2398 мм

CH1 + CH3, 2398 мм

[Нативный PNG](point-05_02398.0mm_ch1-ch3.png)

CH2 + CH4, 2398 мм

[Нативный PNG](point-05_02398.0mm_ch2-ch4.png)

## Точка 06 — 2876 мм

CH1 + CH3, 2876 мм

[Нативный PNG](point-06_02876.0mm_ch1-ch3.png)

CH2 + CH4, 2876 мм

[Нативный PNG](point-06_02876.0mm_ch2-ch4.png)

## Точка 07 — 3425 мм

CH1 + CH3, 3425 мм

[Нативный PNG](point-07_03425.0mm_ch1-ch3.png)

CH2 + CH4, 3425 мм

[Нативный PNG](point-07_03425.0mm_ch2-ch4.png)

## Точка 08 — 4198 мм

CH1 + CH3, 4198 мм

[Нативный PNG](point-08_04198.0mm_ch1-ch3.png)

CH2 + CH4, 4198 мм

[Нативный PNG](point-08_04198.0mm_ch2-ch4.png)

## Точка 09 — 4814 мм

CH1 + CH3, 4814 мм

[Нативный PNG](point-09_04814.0mm_ch1-ch3.png)

CH2 + CH4, 4814 мм

[Нативный PNG](point-09_04814.0mm_ch2-ch4.png)

## Точка 10 — 5635 мм

CH1 + CH3, 5635 мм

[Нативный PNG](point-10_05635.0mm_ch1-ch3.png)

CH2 + CH4, 5635 мм

[Нативный PNG](point-10_05635.0mm_ch2-ch4.png)
