neuroandriyanov/LaserRangefinder/docs/build-verification.md

# Проверка публикационного комплекта

**Русский** | [English](build-verification.en.md)

03.11.2026, Samara (UTC+4). Проверена самостоятельная копия приложения 0.5.1
и проекта Quartus. Рабочие исходники стенда не изменены; к приборам не обращались.

| Проверка | Результат |
|---|---|
| Python 3.14 x64, новое venv | requirements-vector60.txt установлен, pip check без ошибок |
| Установка после переноса | install.ps1, отдельная папка с пробелами, только основные зависимости |
| Запуск после переноса | Run.cmd --demo --close-after 3, код завершения 0 |
| Тесты приложения, в том числе Tk | 63 / 63 |
| Тесты протокола, включая байты из HDL | 22 / 22 |
| HDL-моделирование | 9 / 9 наборов, Icarus Verilog |
| Назначения выводов | 88 совпадают с проверенным исходным проектом |
| Проверка МНК NumPy | 80 окон, максимум отличия от HDL 0,002427578° |
| Quartus Lite 25.1std, build 1129 | Полная сборка успешна |
| Логика / M9K / DSP18 / PLL | 6162/6272; 23/30; 5/15; 1/2 |
| Тайминги | 66 проверок, минимум +0,137 нс; все TNS=0 |
| Пути без ограничений | 0 |
| Сохранность рабочих исходников | 49 файлов без изменения |
| Исходный архив HDL | 131 файлов совпадают с baseline SHA256 |
| Последняя серия измерений | 59 файлов побайтово сохранены |

POF новой сборки **побайтово совпал** с сохранённым образом последней
стендовой серии: `7e652373ae74ca5d1734248706c16cae9fdaf9ef25b28a321869271220e0212d`. В этой задаче программатор не запускался.
Использованная на стенде запись Program+Verify относится к 20:31:09 этого дня.

Сборка содержит предупреждения синтеза, в том числе об усечении разрядности,
неиспользуемых сигналах и входах ROM; они не скрыты. Ошибок и Critical Warning
в контрольном запуске нет. Анализ предупреждений не заменён утверждением
«сборка без предупреждений»; изменение рабочего HDL в этот этап не входило.

Подробности: [сводка JSON](verification/summary.json),
[журнал Quartus](verification/quartus-build.txt),
[ресурсы](verification/quartus-fit.txt), [тайминги](verification/quartus-timing.txt),
[unconstrained](verification/quartus-unconstrained.txt),
[приложение](verification/app-tests.txt), [протокол](verification/protocol-tests.txt),
[HDL](verification/hdl-tests.json), [проверка МНК](verification/phase-reference.json),
[версии пакетов](verification/python-packages.txt).

Демонстрация и тесты используют имитаторы, а не доказывают аппаратную точность.
Живая работа нового выбираемого WinUSB-адаптера здесь не проверялась.
Отдельный блок схем/фото/измерений не пересчитывался: сохранены оригинальные
PDF, XLSX, JPEG, PNG, SVG и численные данные.

В корне `manifest.json` — контрольные суммы публикационных файлов, проверка:

```powershell
python tools/verify_bundle.py
```

Manifest не подписан и служит контролем целостности. Временные базы сборки,
виртуальные окружения и кеши в него не входят.
