neuroandriyanov/LaserRangefinder/docs/experiments.md

# Эксперименты и результаты

**Русский** | [English](experiments.en.md)

Здесь удобно выбрать, что посмотреть: реальные сигналы и расстояния,
калибровочную модель или проверку вычислений. У каждого вида проверки своя
задача: моделирование не заменяет оптический опыт, а удачный опыт в одной
точке не определяет характеристики всего диапазона.

## Последняя независимая серия: 762–5635 мм

**3 ноября 2026 года, 10 неподвижных положений мишени.** Коэффициенты cal2
зафиксированы до начала серии и по этим точкам не подгонялись.

| Материал | Что в нём |
|---|---|
| [Отчёт серии](../measurements/2026-11-03/README.md) | Метод, условия отбора, результаты и неудачные попытки |
| [Excel с формулами](../measurements/2026-11-03/Стендовые%20измерения.xlsx) | Рулетка, фазы, амплитуды, аналоговое и цифровое расстояния, ошибки |
| [Осциллограммы](../measurements/2026-11-03/Осциллограммы/README.md) | По два снимка на точку с подписями расстояния |
| [Численные результаты](../measurements/2026-11-03/measurements.json) | Средние, разброс и диагностические поля для самостоятельного анализа |
| [Коэффициенты](../measurements/2026-11-03/calibration.json) | Модель, границы применения и её идентификатор |
| [Происхождение и SHA256](../measurements/2026-11-03/manifest.json) | Контрольные суммы компактных файлов и ссылки на первичные источники |

Для девяти точек в области cal2 RMS расхождения с Vector60 составил
13,36 мм по аналоговым и 13,16 мм по цифровым фазам. При 5635 мм модель
не применяется; дополнительно зарегистрирован `diagnostics=4`. Эта точка
сохранена, а не исключена из истории из-за неудобного результата.

## Калибровка cal2

Исходная серия содержит 21 точку от 638 до 5583 мм.
[CSV](../app/desktop_app/cal2.csv) включён в комплект. В выбранном методе
низкая фаза определяет целое число оборотов высокой; точное расстояние
вычисляет нормированный полином четвёртой степени по развёрнутой ВЧ-фазе.

Реализация — [distance.py](../app/desktop_app/distance.py),
регрессионные проверки — [test_cal2.py](../app/desktop_app/test_cal2.py).
Нельзя использовать точки обучения как независимое подтверждение точности:
для этого и проводилась отдельная серия, приведённая выше.
Калибровка не переносится автоматически на другой DDS-банк или экземпляр платы.

## Фаза при разных ПЧ и амплитудах

В моделировании проверялись разные ПЧ в рабочем диапазоне примерно 1–20 кГц,
неравные частоты пар, различные амплитуды и постоянные составляющие.
Тесты используют квантованные отсчёты АЦП, а отдельный расчёт NumPy сравнивает
результат с независимым МНК.

| Проверка | Источник и результат |
|---|---|
| Аналоговый тракт | [tb_variable_phase.sv](../fpga/tb/tb_variable_phase.sv), [журнал](verification/hdl-variable_phase.txt) |
| Независимая проверка МНК | [80 окон](verification/phase-reference.json), максимум отличия от HDL 0,002427578° |
| Цифровой тракт | [tb_variable_digital.sv](../fpga/tb/tb_variable_digital.sv), [журнал](verification/hdl-variable_digital.txt) |
| Атомарное изменение DDS | [tb_config.sv](../fpga/tb/tb_config.sv), [журнал](verification/hdl-config.txt) |
| Порог детекторов и UART | [tb_link.sv](../fpga/tb/tb_link.sv), [журнал](verification/hdl-link.txt) |

Это проверка цифровой реализации на заданных сигналах. Она не доказывает
отсутствие шума, насыщения и взаимного проникновения сигналов в реальной плате.

## Как мы пришли к текущему варианту

До последней серии мы сравнивали фазы осциллографа и FPGA, исследовали время
ответов рулетки, проверяли управление AD9959, пробовали FIR, подбирали частоты
и амплитуды и разрабатывали расчёт по двум фазам.

- Время ответа рулетки менялось; сопоставлять движущуюся мишень только по
  времени прихода пакета оказалось недостаточно. Поэтому основная проверка
  дальности проводилась на остановках.
- В проверенном DDS-коде не обнаружилась периодическая команда, объясняющая
  наблюдавшиеся скачки. Это не установило их аппаратную причину.
- FIR не дал заметного улучшения по наблюдениям автора и был удалён.
- Подбор на мишени 1642 мм дал текущий профиль с разными ПЧ около 4 и 6,75 кГц.
  Предпочтение относится к исследованным вариантам на том стенде, а не ко всем
  возможным частотам и расстояниям.

Это краткая история предыдущих этапов. Их полные первичные сеансы остаются
в рабочем архиве автора и не входят в этот компактный комплект. Здесь доступны
последняя самостоятельная серия, cal2, текущий код и результаты его проверок.

## Что можно исследовать дальше

Повторяемость при подходе к точке с разных сторон, температурный дрейф,
переходы через оборот фазы, появление bit2 при движении и измерения на длинном
участке. Для нового опыта сохраните исходный режим и меняйте один фактор,
чтобы результат можно было объяснить и повторить.

[Стенд](stand.md) · [Работа с ИИ](START_WITH_AI.md) ·
[Открытые вопросы](AI_HANDOFF.md)
