neuroandriyanov/LaserRangefinder/docs/verification/protocol-tests.txt

......................
----------------------------------------------------------------------
Ran 22 tests in 0.009s

OK
