neuroandriyanov/LaserRangefinder/measurements/2026-11-03/Bench measurements.en.xlsx

Sheet: Measurements
Rangefinder bench measurements · 03.11.2026
Error = calculated − reference. cal2 calculation without fitting this series. Phases are circular means of stationary intervals. |  |  |  |  |  |  |  |  |  |  |  |  |  |  |  |  |  |  |  |  |  |  |  |  |  |  |  |  |  | Files in the Осциллограммы folder
Reference, mm | ADC HF, ° | ADC LF, ° | Digital HF, ° | Digital LF, ° | ADC distance, mm | Digital distance, mm | ADC error, mm | Digital error, mm | Point | Status | CH1 amplitude, V | CH2 amplitude, V | CH3 amplitude, V | CH4 amplitude, V | ADC5 detector, V | ADC6 detector, V | ADC7 detector, V | ADC8 detector, V | FPGA HF IF, Hz | FPGA LF IF, Hz | ADC HF std. dev., ° | ADC LF std. dev., ° | Digital HF std. dev., ° | Digital LF std. dev., ° | Packets received | Valid fraction | Reference spread, mm | FPGA diagnostics | Time Samara UTC+4 | CH1+CH3 capture | CH2+CH4 capture | Digital HF edge ↑, ° | Digital HF edge ↓, ° | Digital LF edge ↑, ° | Digital LF edge ↓, ° | Max. UART gap, ms | Max. digital age, ms | ADC OK mask
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
