neuroandriyanov/LaserRangefinder/measurements/2026-11-03/Стендовые измерения.xlsx

Sheet: Измерения
Стендовые измерения дальномера · 03.11.2026
Ошибка = расчёт − рулетка. Расчёт cal2 без подгонки по этой серии. Фазы — круговые средние неподвижных интервалов. |  |  |  |  |  |  |  |  |  |  |  |  |  |  |  |  |  |  |  |  |  |  |  |  |  |  |  |  |  | Файлы в папке «Осциллограммы»
Рулетка, мм | АЦП ВЧ, ° | АЦП НЧ, ° | Цифр. ВЧ, ° | Цифр. НЧ, ° | Расстояние АЦП, мм | Расстояние цифр., мм | Ошибка АЦП, мм | Ошибка цифр., мм | Точка | Состояние | Амплитуда CH1, В | Амплитуда CH2, В | Амплитуда CH3, В | Амплитуда CH4, В | Детектор АЦП5, В | Детектор АЦП6, В | Детектор АЦП7, В | Детектор АЦП8, В | ПЧ ВЧ FPGA, Гц | ПЧ НЧ FPGA, Гц | СКО АЦП ВЧ, ° | СКО АЦП НЧ, ° | СКО цифр. ВЧ, ° | СКО цифр. НЧ, ° | Пакетов принято | Достоверных, доля | Разброс рулетки, мм | Диагностика FPGA | Время Samara UTC+4 | Снимок CH1+CH3 | Снимок CH2+CH4 | Цифр. ВЧ фронт ↑, ° | Цифр. ВЧ фронт ↓, ° | Цифр. НЧ фронт ↑, ° | Цифр. НЧ фронт ↓, ° | Макс. пауза UART, мс | Возраст цифр., макс. мс | АЦП OK, маска
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
