neuroandriyanov/LaserRangefinder/app/tests/fixtures/cal1/cal1.csv

index | utc | distance_mm | analog_high_deg | analog_low_deg | digital_high_deg | digital_low_deg
1 | 2026-11-02T19:04:38.158315+00:00 | 666.0 | -136.82965764775872 | 8.840167969465256 | -135.14445304870605 | 6.810450553894043
2 | 2026-11-02T19:05:01.329675+00:00 | 798.0 | -160.14246689155698 | 8.700613472610712 | -158.2542371749878 | 6.659259796142578
3 | 2026-11-02T19:05:19.806116+00:00 | 950.0 | 174.35609344393015 | 8.60644094645977 | 176.1465883255005 | 6.5674638748168945
4 | 2026-11-02T19:05:38.089301+00:00 | 1123.0 | 145.6547254510224 | 8.180346731096506 | 147.49422311782837 | 6.132216453552246
5 | 2026-11-02T19:05:53.433704+00:00 | 1348.0 | 108.22955008596182 | 7.926088236272335 | 110.00640392303467 | 5.927016735076904
6 | 2026-11-02T19:06:11.374482+00:00 | 1602.0 | 63.34969058632851 | 8.257063440978527 | 65.06661415100098 | 6.254246234893799
7 | 2026-11-02T19:06:29.738353+00:00 | 1835.0 | 22.459614481776953 | 9.92248859256506 | 24.14119005203247 | 7.994120121002197
8 | 2026-11-02T19:06:56.631412+00:00 | 2119.0 | -30.257834270596504 | 12.652638908475637 | -28.475210666656494 | 10.673582553863525
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
