neuroandriyanov/LaserRangefinder/measurements/2026-11-03/Осциллограммы/point-01_00762.0mm_ch2-ch4.png

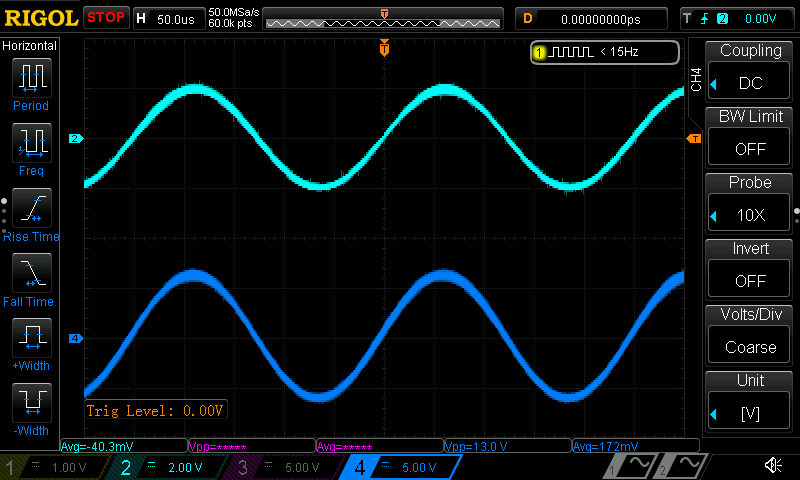
measurements/2026-11-03/Осциллограммы/point-01_00762.0mm_ch2-ch4.png
