neuroandriyanov/LaserRangefinder/measurements/2026-11-03/Осциллограммы/point-02_01091.0mm_ch1-ch3.png

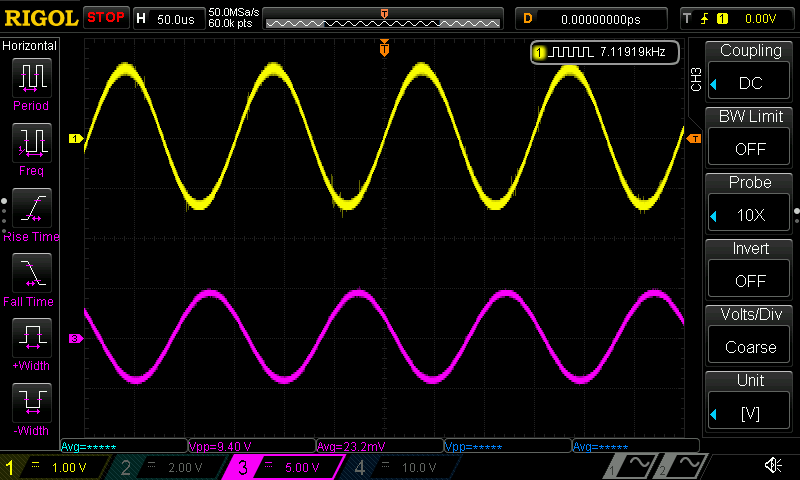
measurements/2026-11-03/Осциллограммы/point-02_01091.0mm_ch1-ch3.png
