neuroandriyanov/LaserRangefinder/measurements/2026-11-03/Осциллограммы/point-05_02398.0mm_ch1-ch3.png

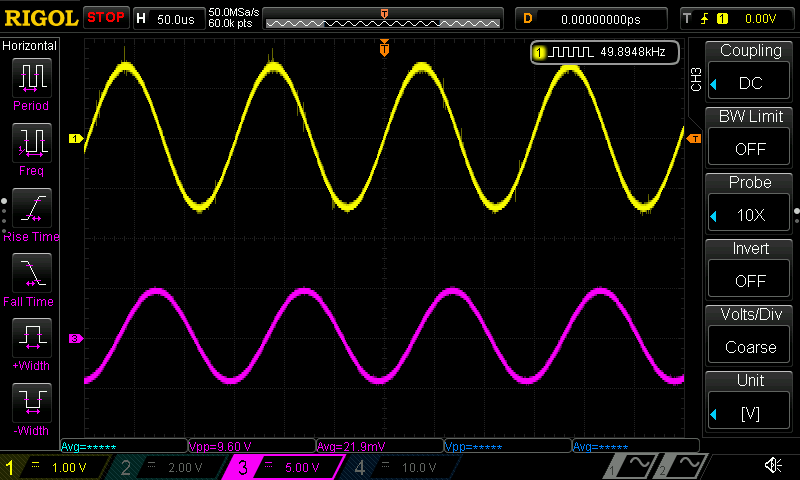
measurements/2026-11-03/Осциллограммы/point-05_02398.0mm_ch1-ch3.png
