neuroandriyanov/LaserRangefinder/measurements/2026-11-03/Осциллограммы/point-05_02398.0mm_ch2-ch4.png

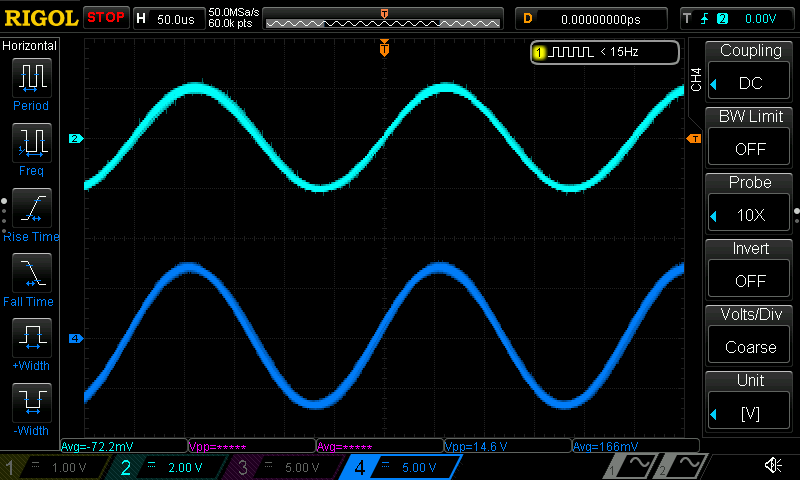
measurements/2026-11-03/Осциллограммы/point-05_02398.0mm_ch2-ch4.png
