neuroandriyanov/LaserRangefinder/measurements/2026-11-03/Осциллограммы/point-07_03425.0mm_ch1-ch3.png

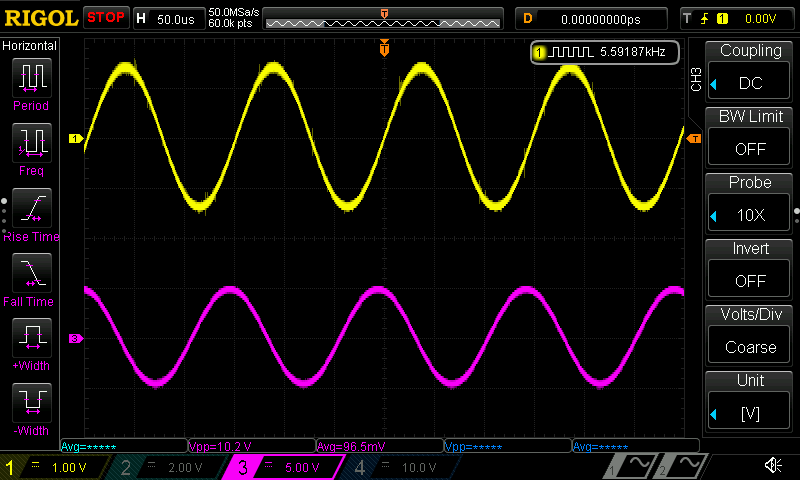
measurements/2026-11-03/Осциллограммы/point-07_03425.0mm_ch1-ch3.png
