neuroandriyanov/LaserRangefinder/hardware/schematics/main.pdf

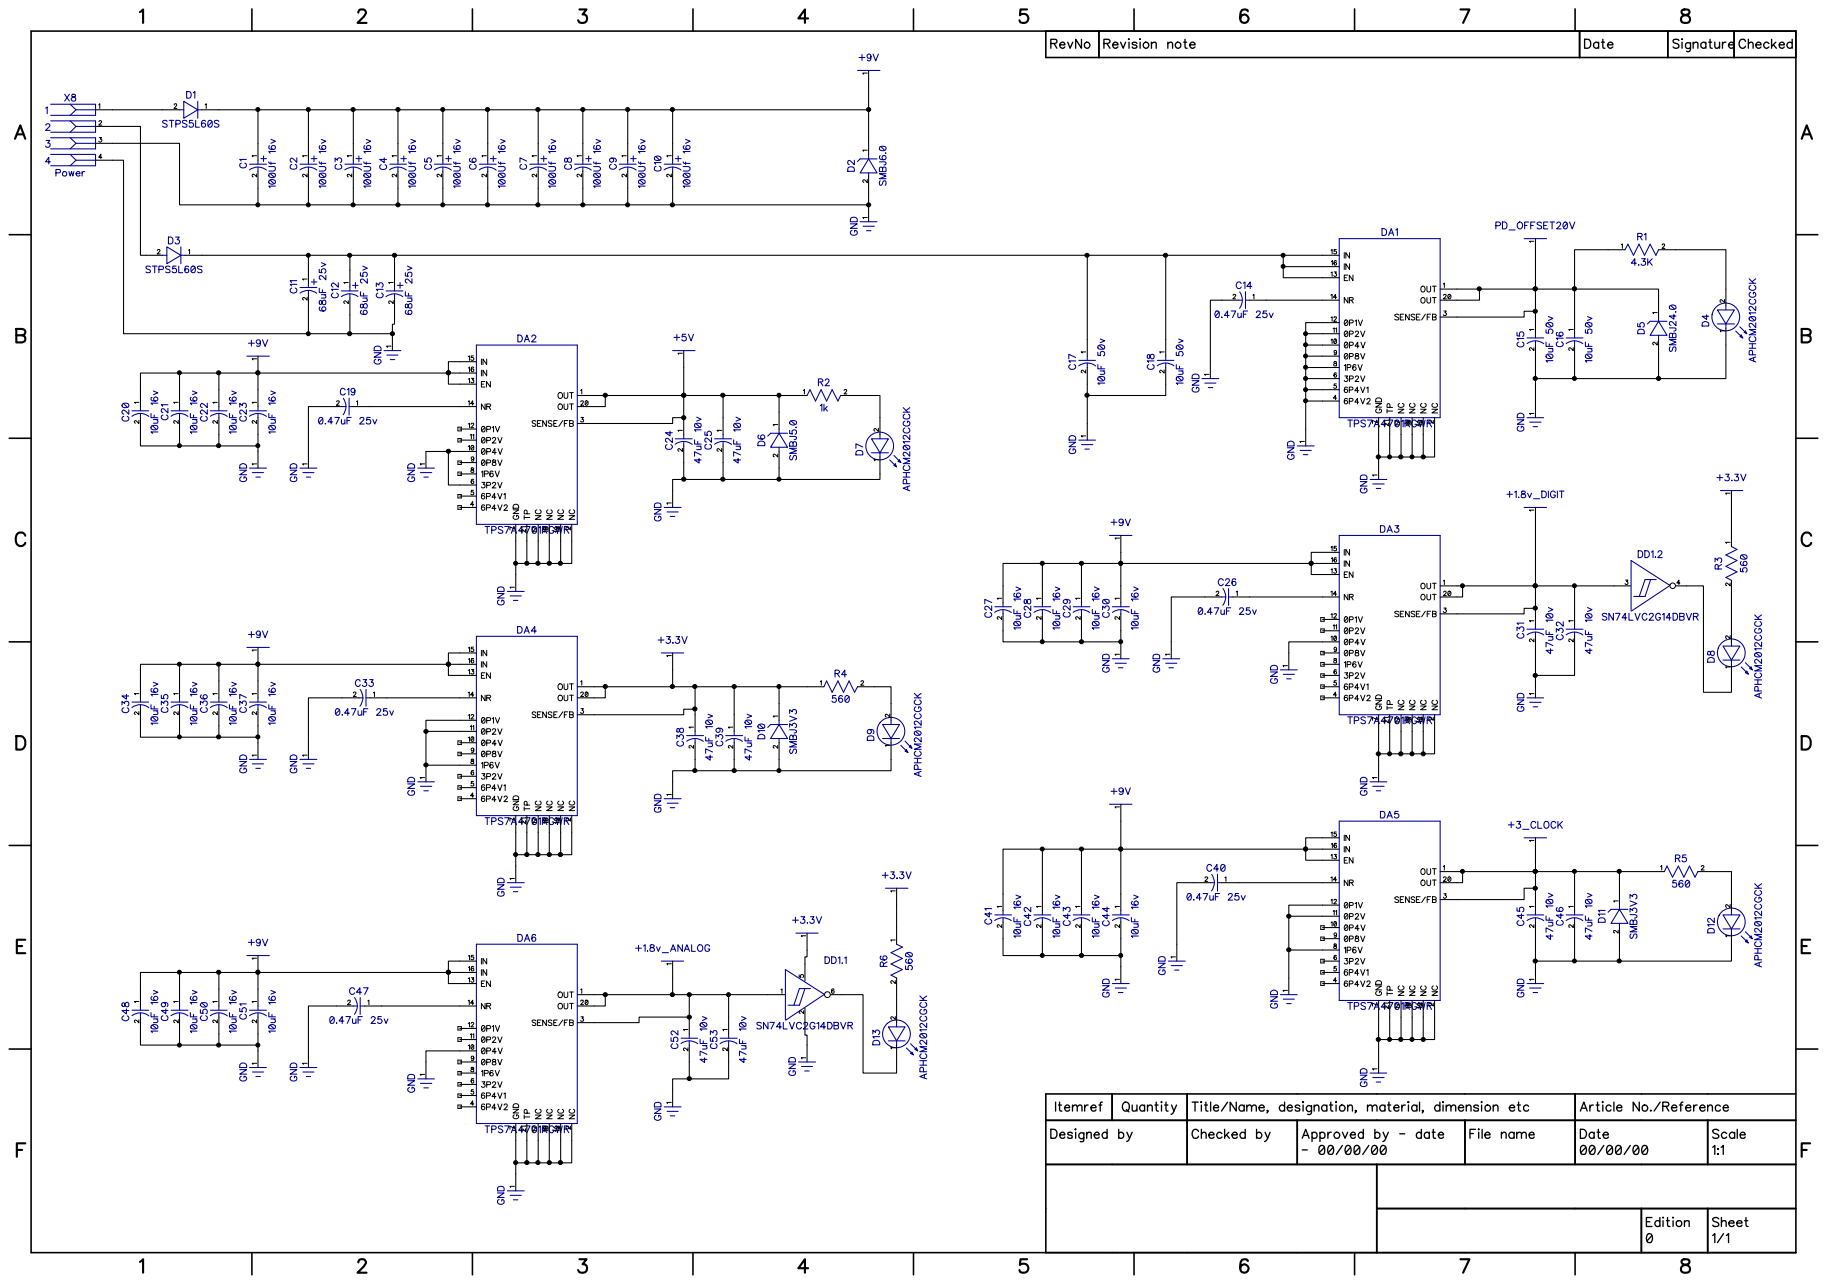
[picture p19: page 1]

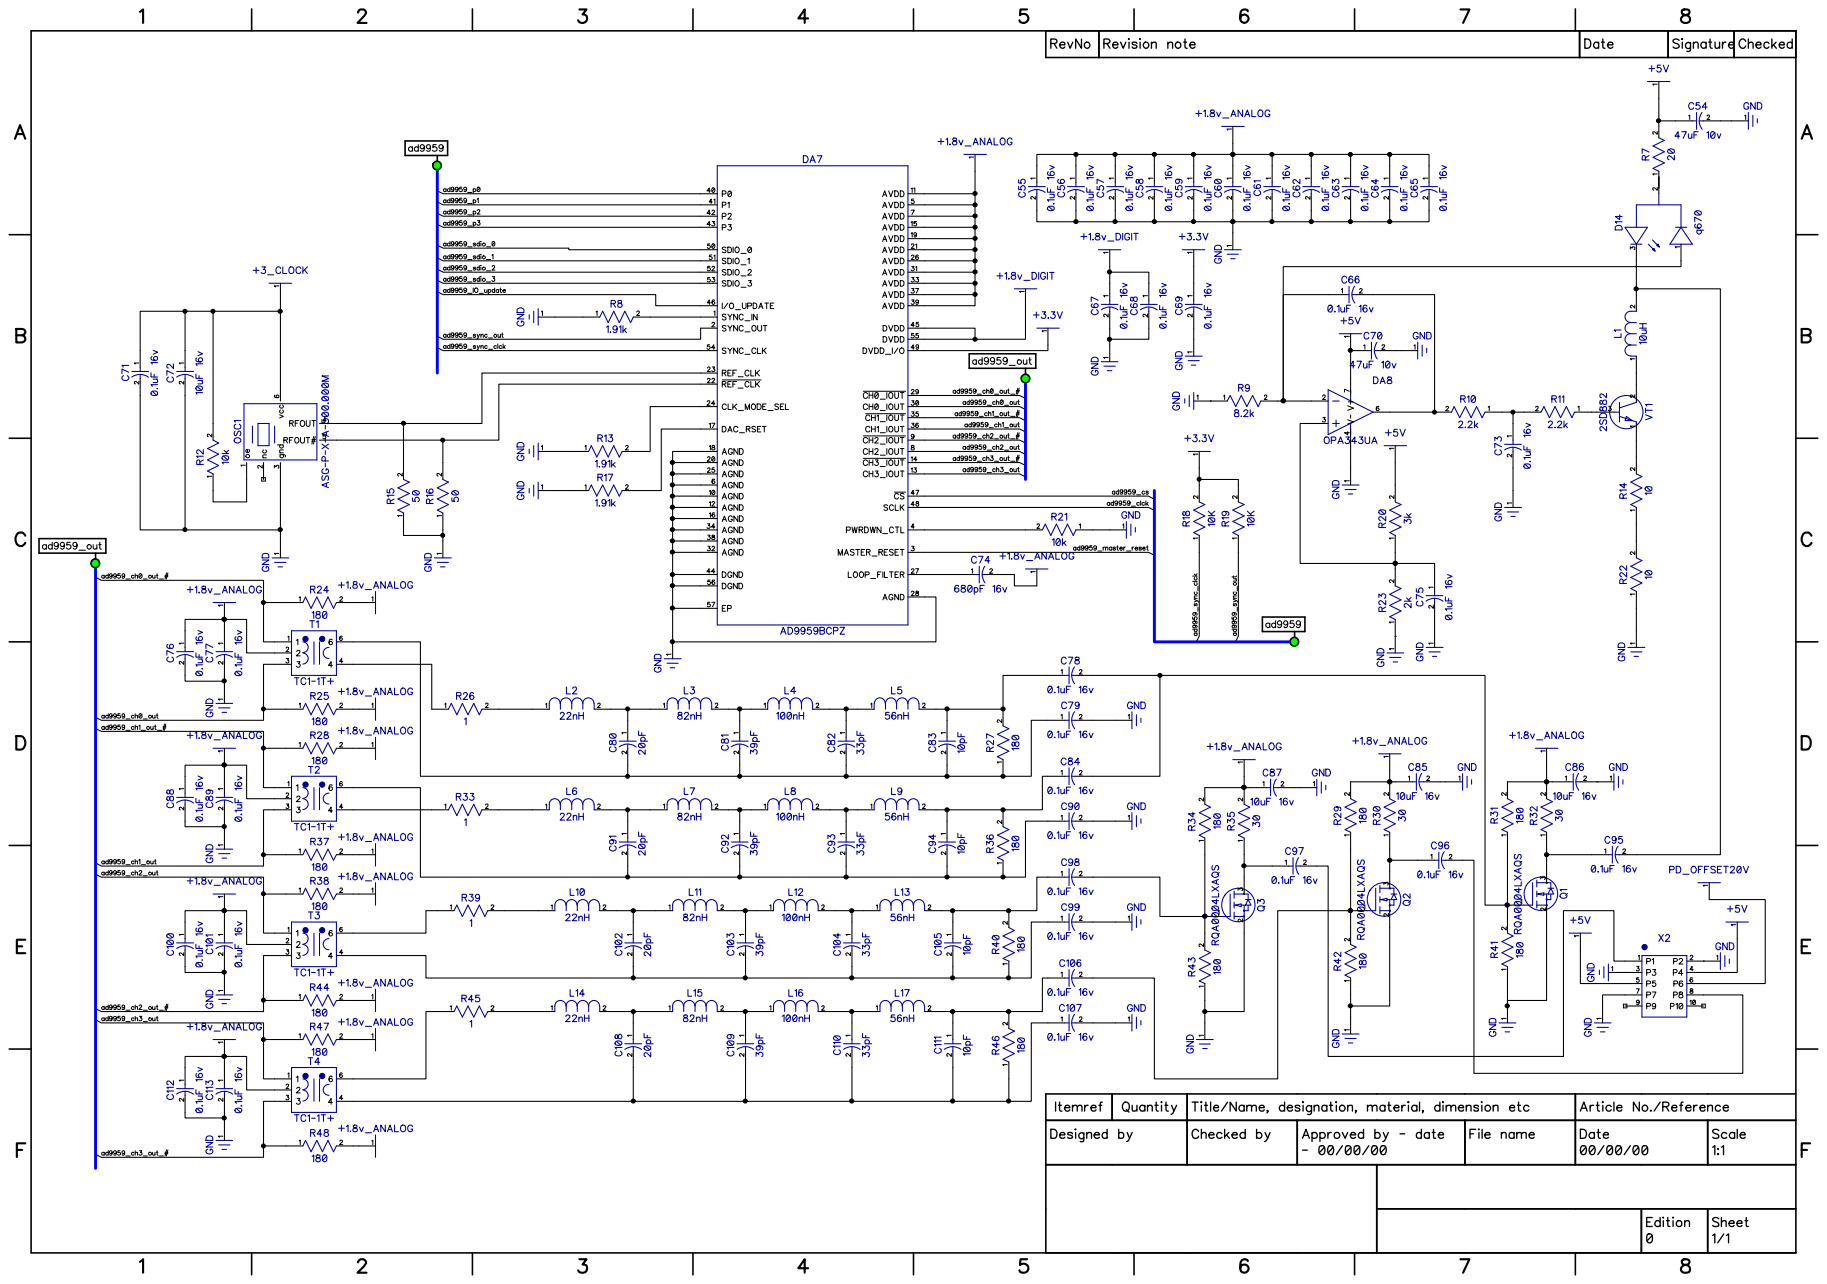
[picture p20: page 2]

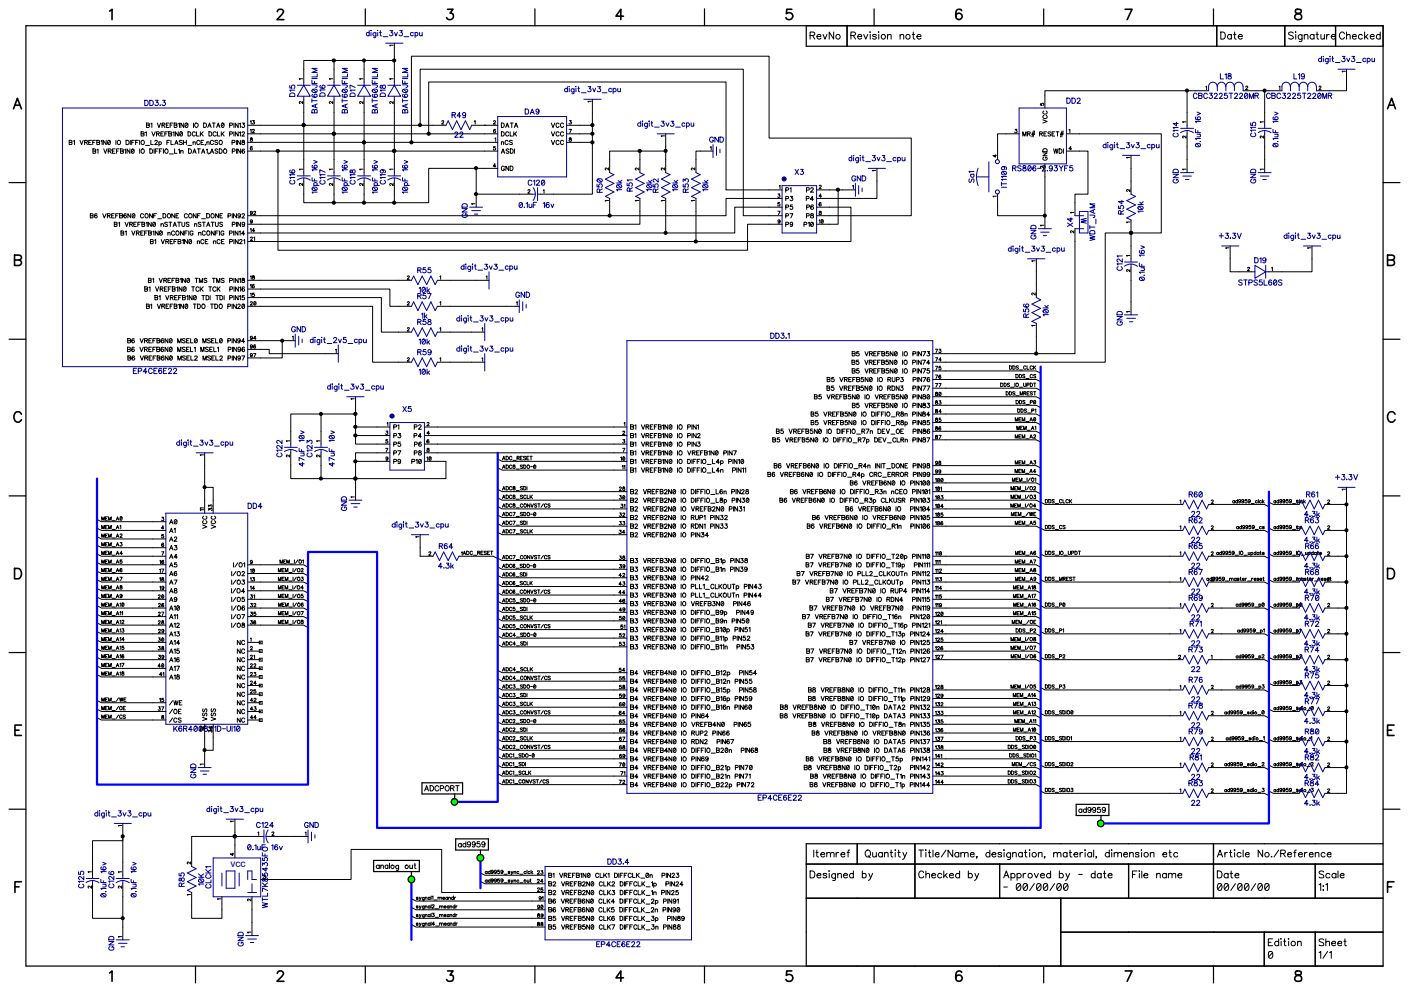
[picture p21: page 3]
vcc

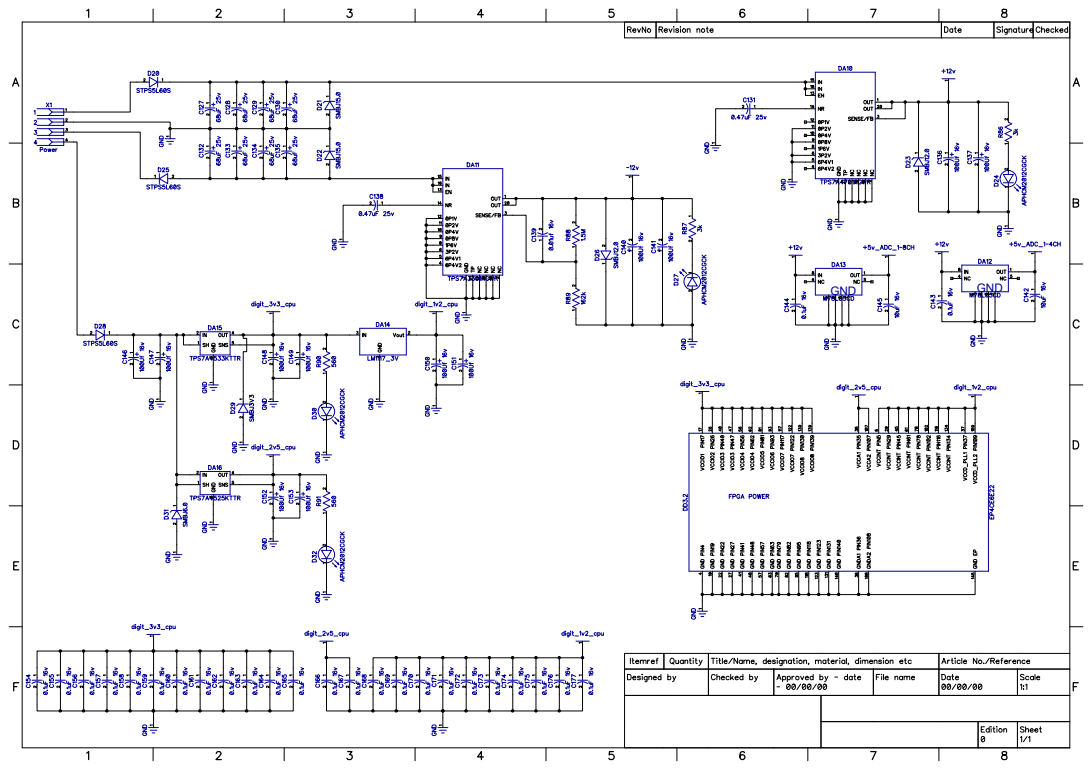
[picture p22: page 4]
GND

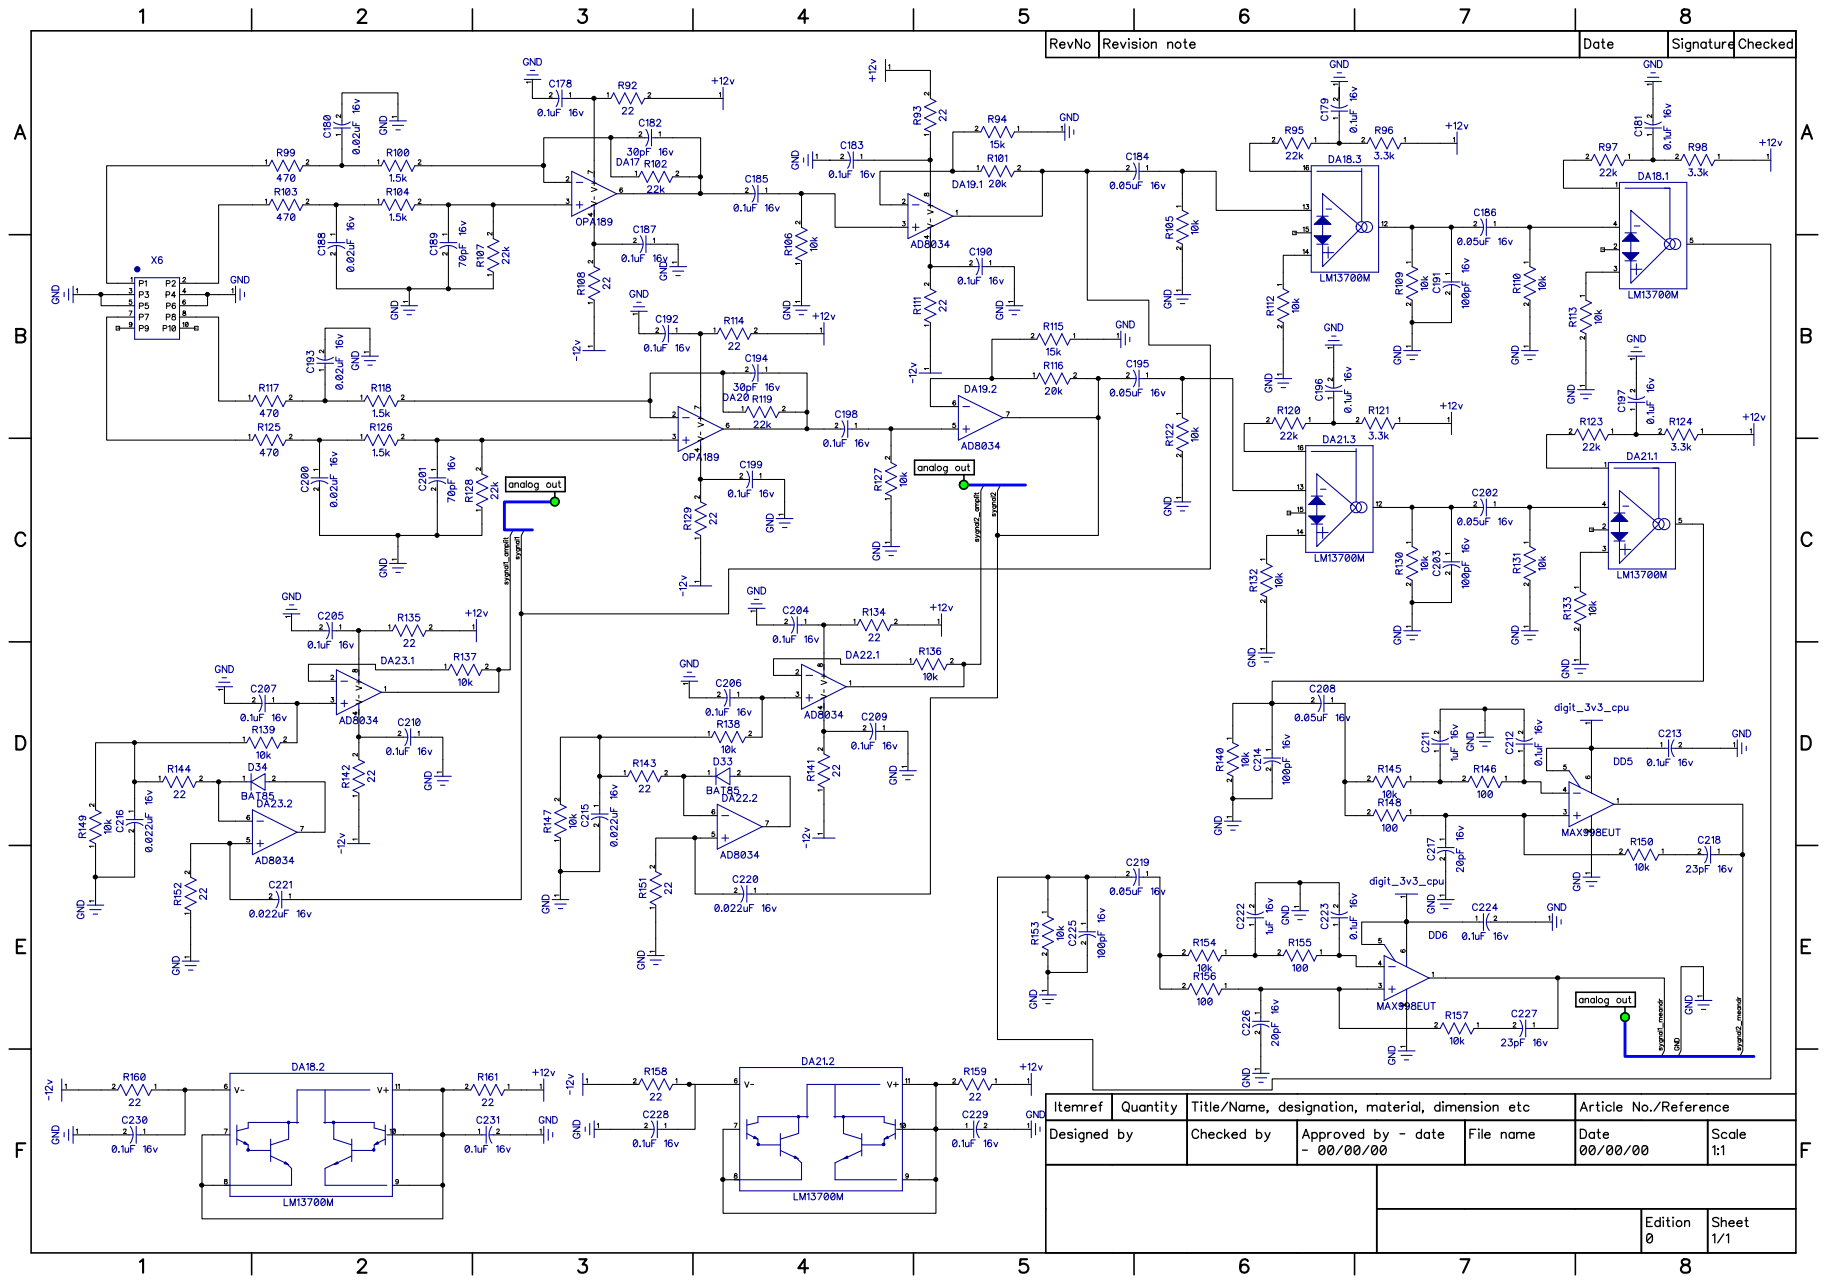
[picture p23: page 5]

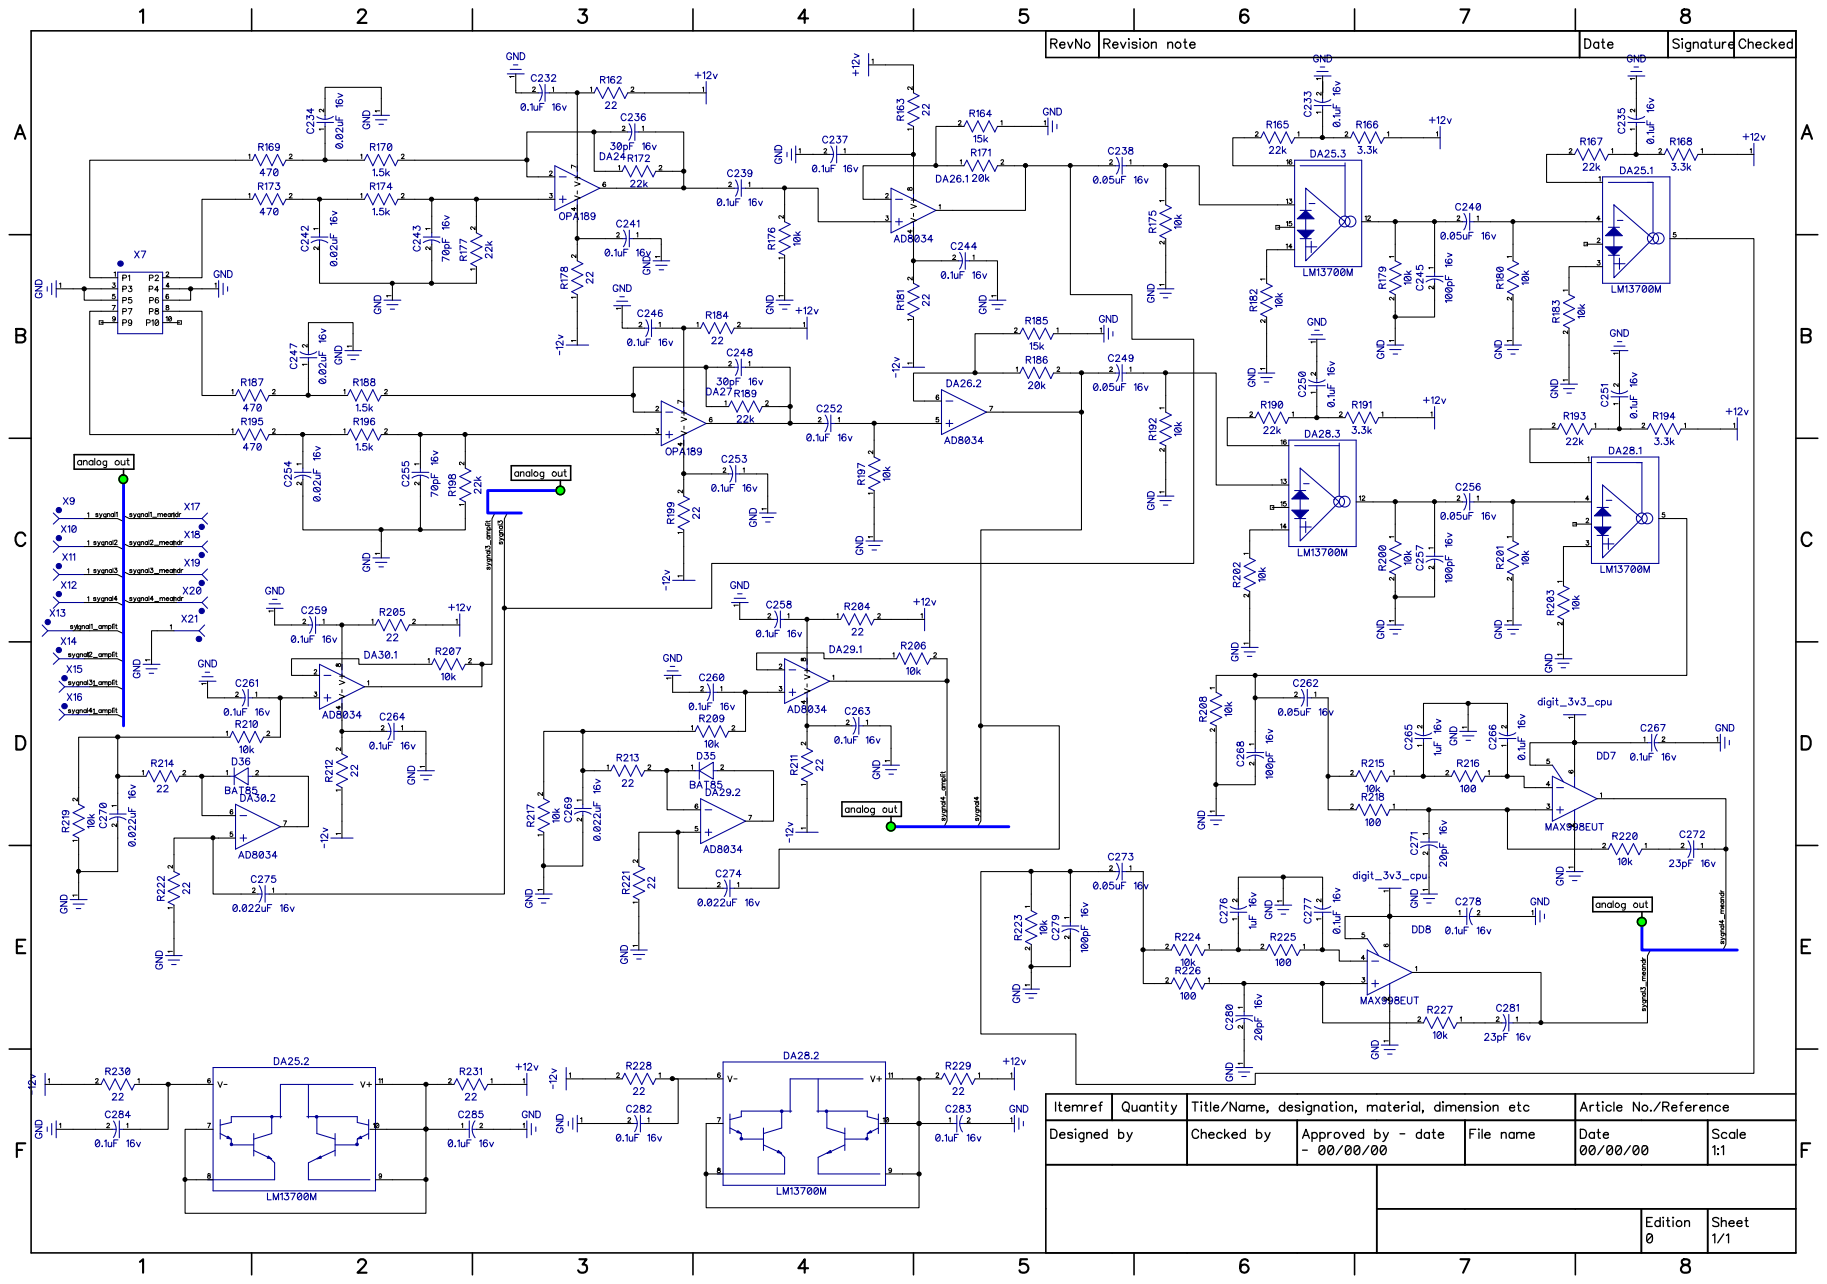
[picture p24: page 6]

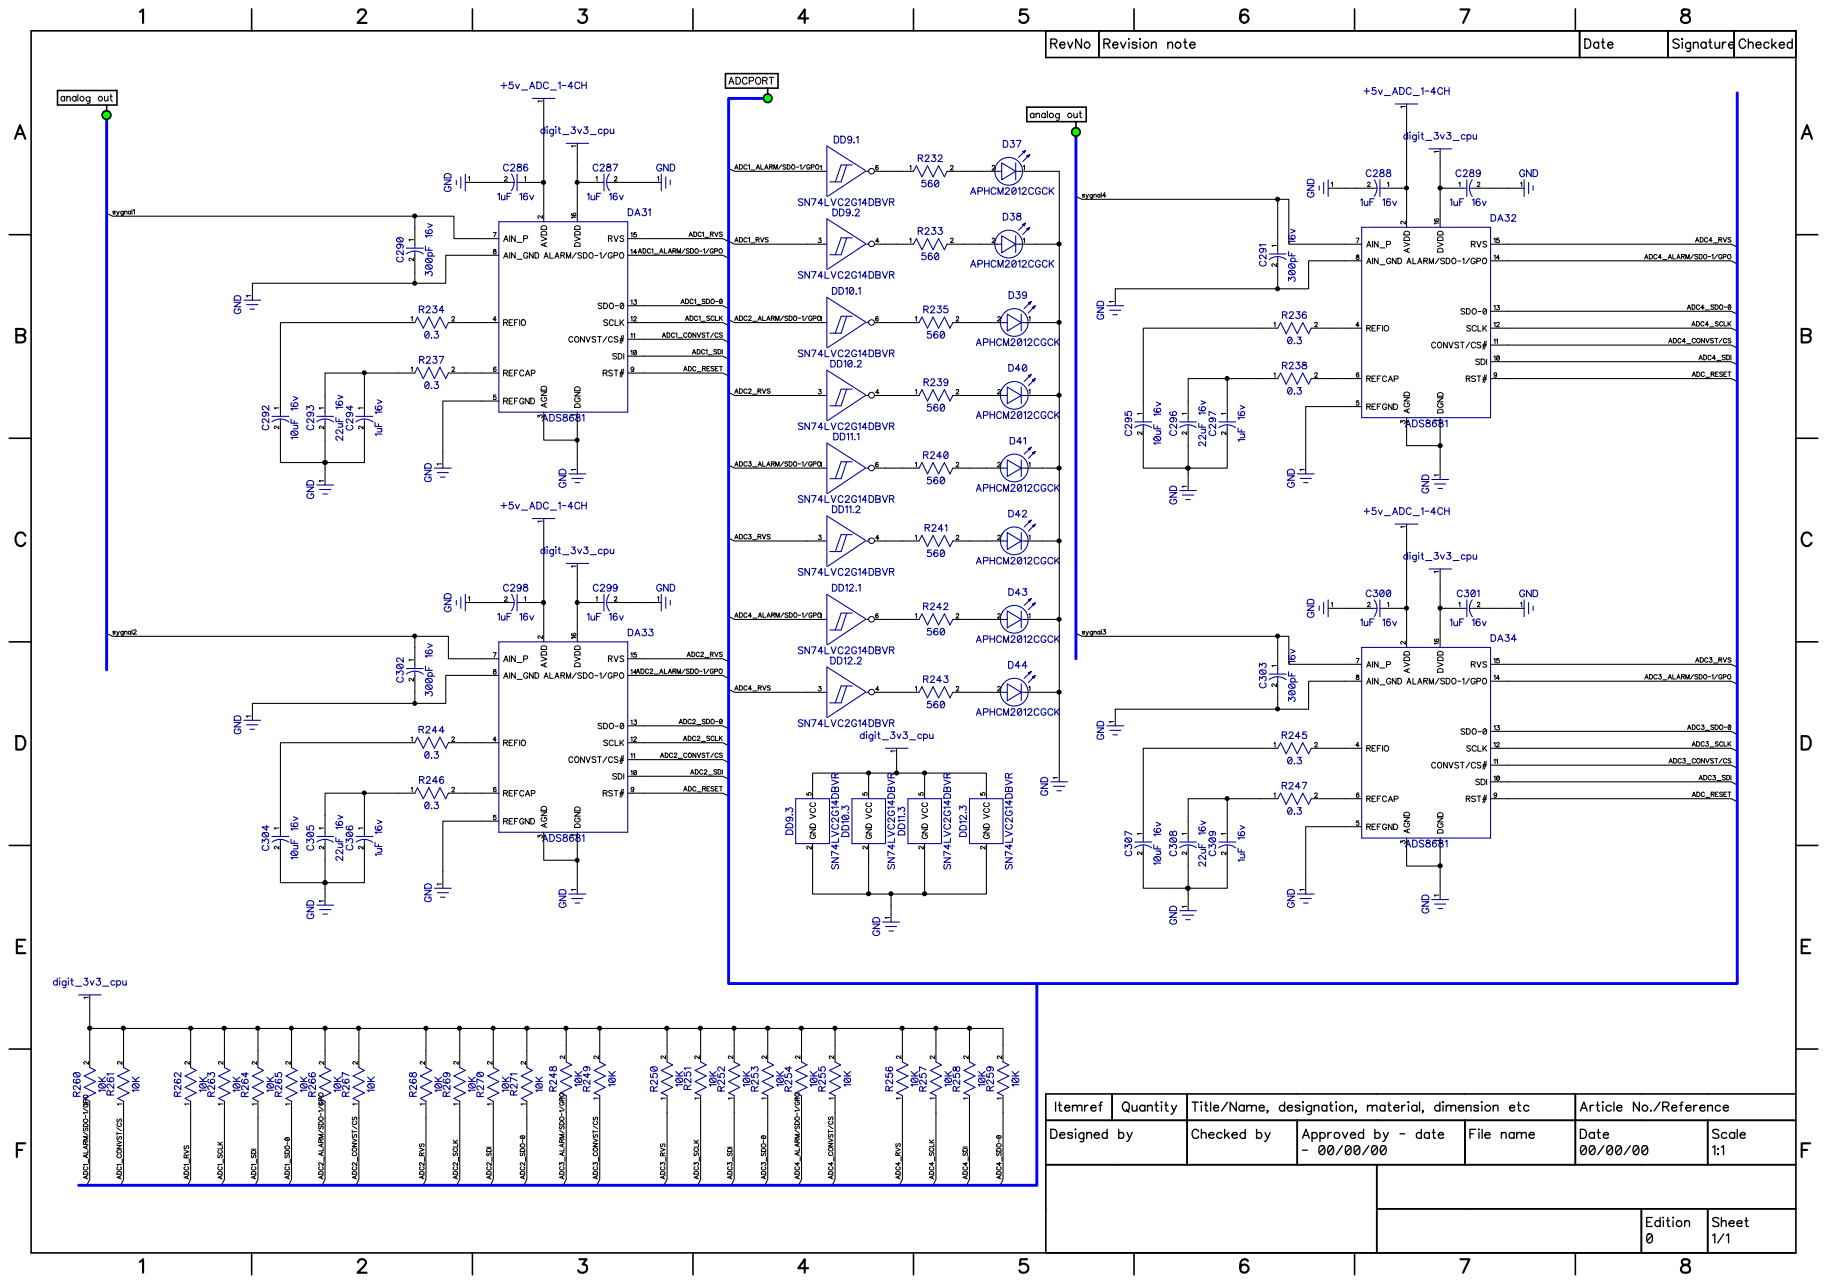
[picture p25: page 7]

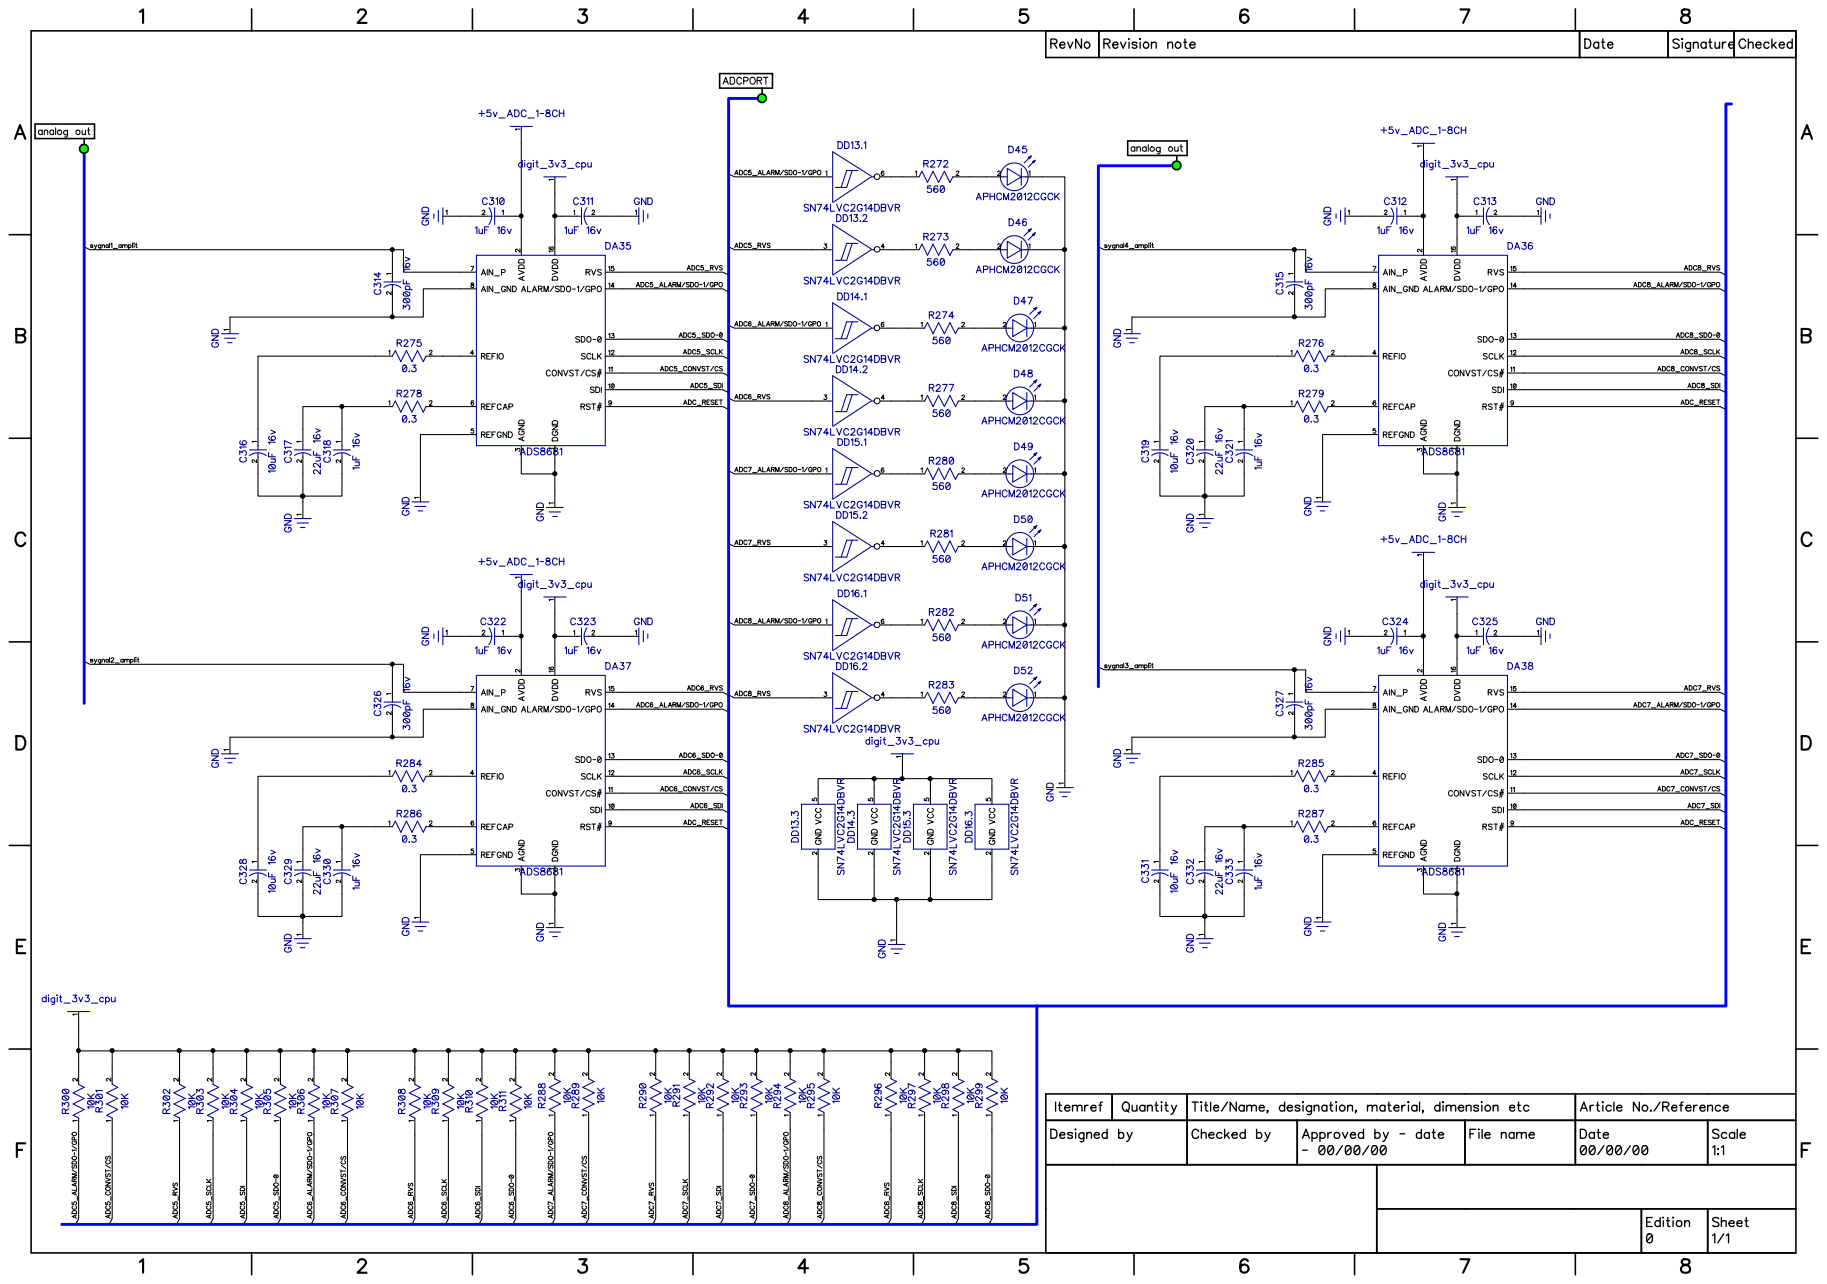
[picture p26: page 8]
