neuroandriyanov/LaserRangefinder/hardware/schematics/power.pdf

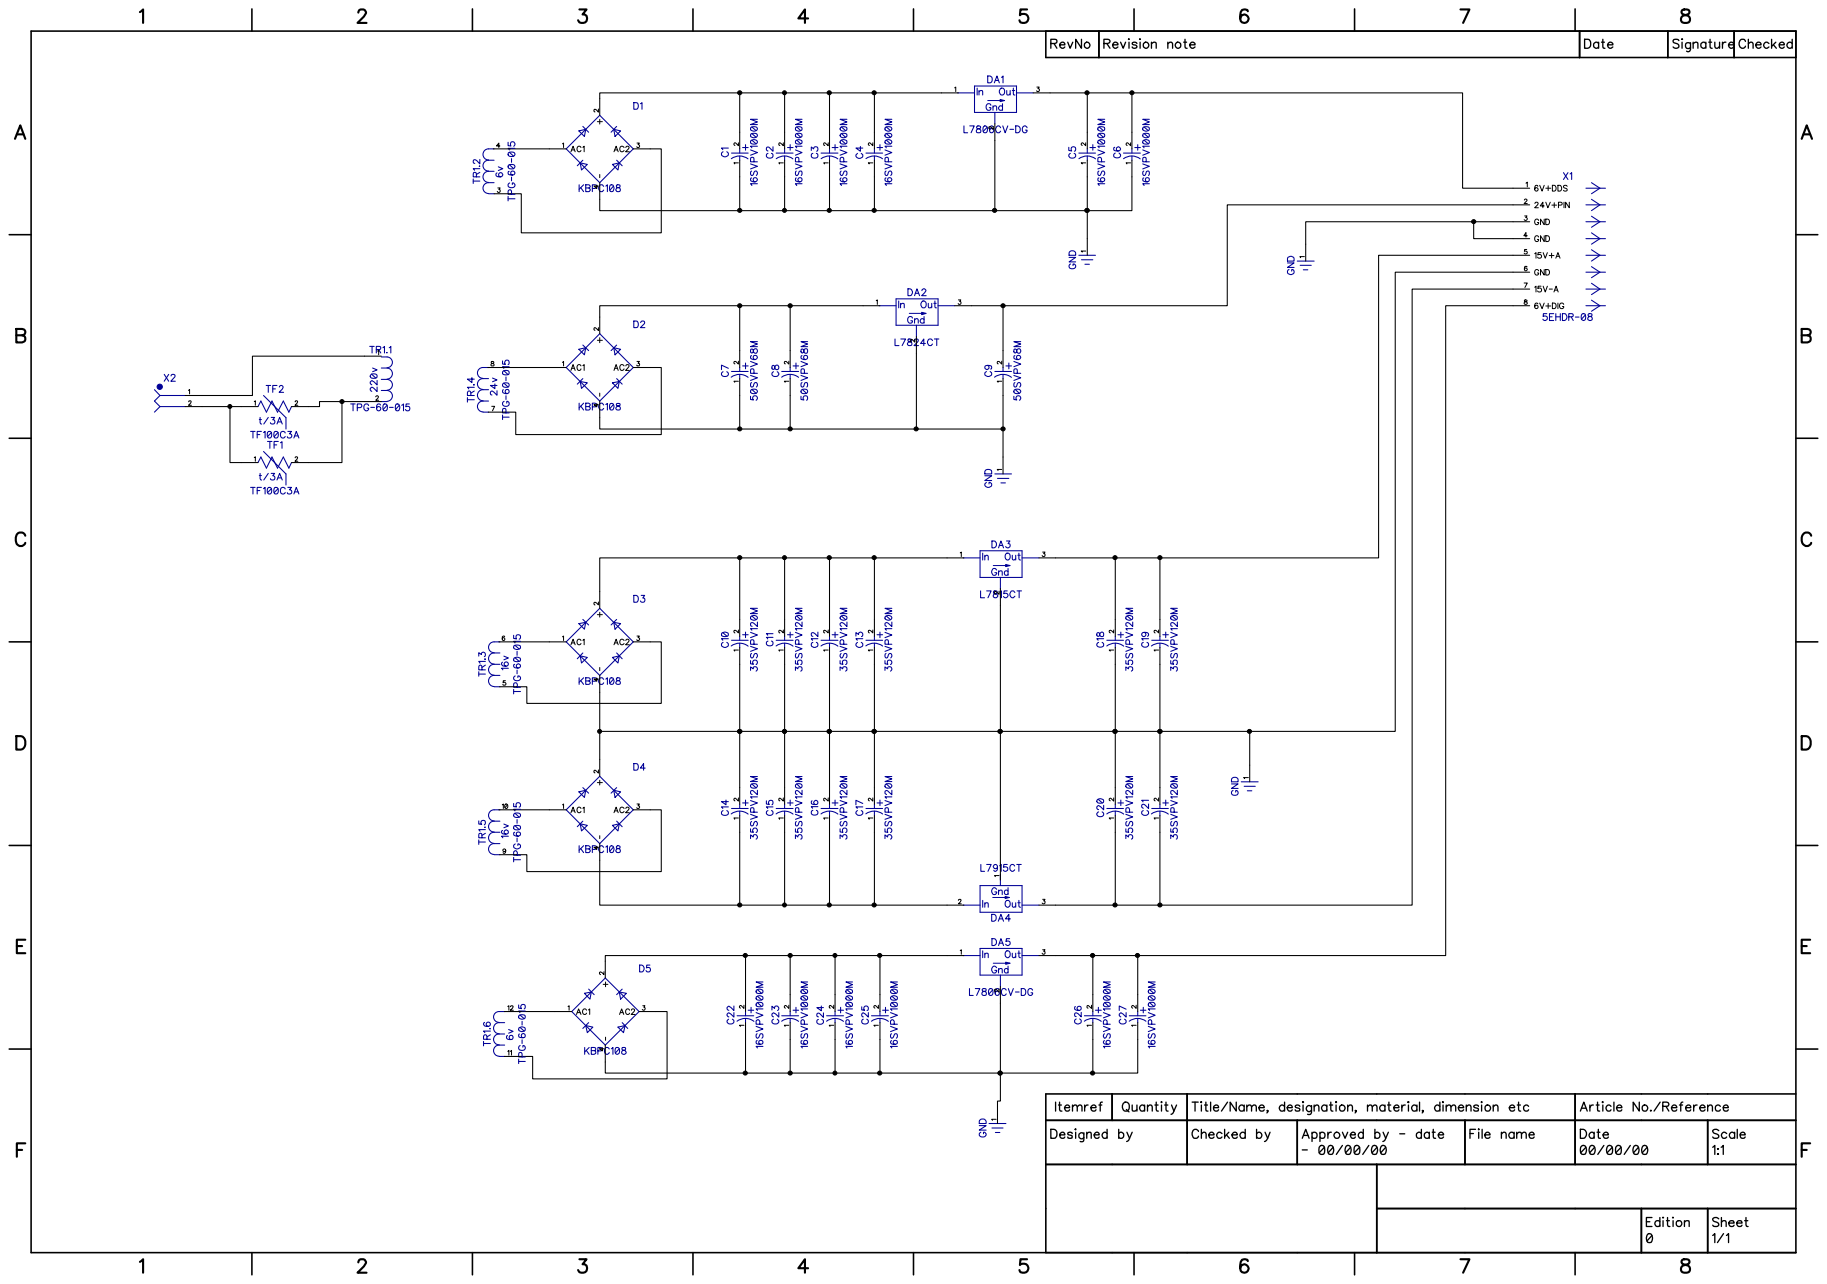
[picture p27: page 1]
