neuroandriyanov/LaserRangefinder/(commit log)

2026-11-03 Publish LaserRangefinder sources, hardware and bench measurements
    [bom.xlsx, cal1.csv, cal2.csv, hdl-config.txt, Стендовые измерения.xlsx]
2026-11-07 Add full English documentation, oscilloscope labels and measurement workbook
    [Bench measurements.en.xlsx]
